magicmaker3/magicmaker/ESP32主控板JOKER SPARROW/Brush fastener tool刷固件工具/ESP32清FLASH教程/ESP双清教程.jpg

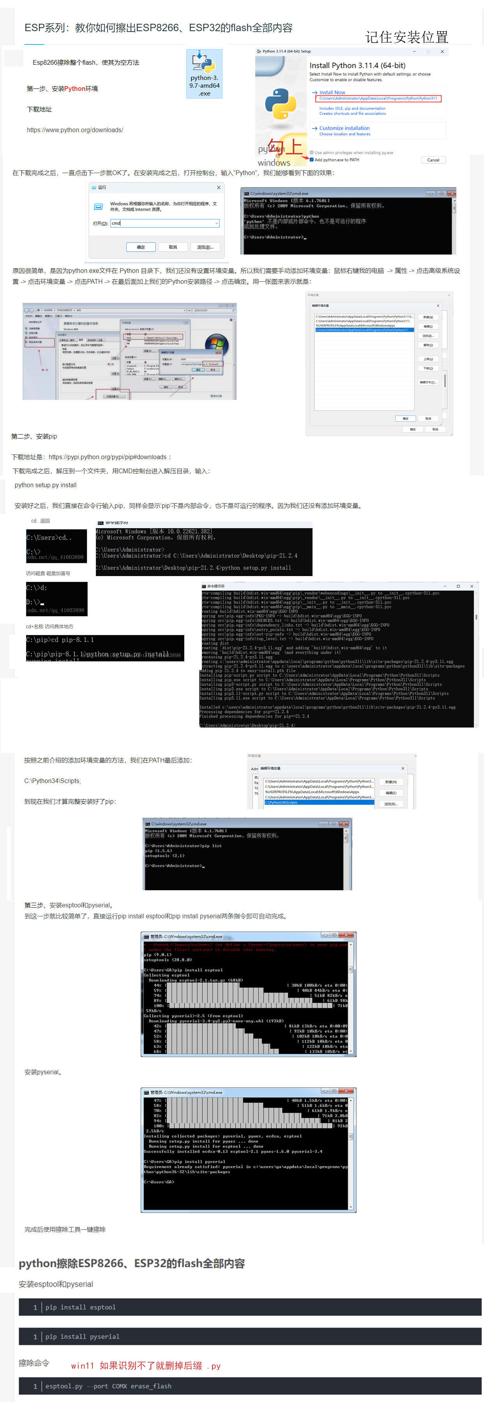
ESP32主控板JOKER SPARROW/Brush fastener tool刷固件工具/ESP32清FLASH教程/ESP双清教程.jpg
