magicmaker3/magicmaker/ESP32主控板JOKER SPARROW/JOKER/JOKER-PIN.JPG

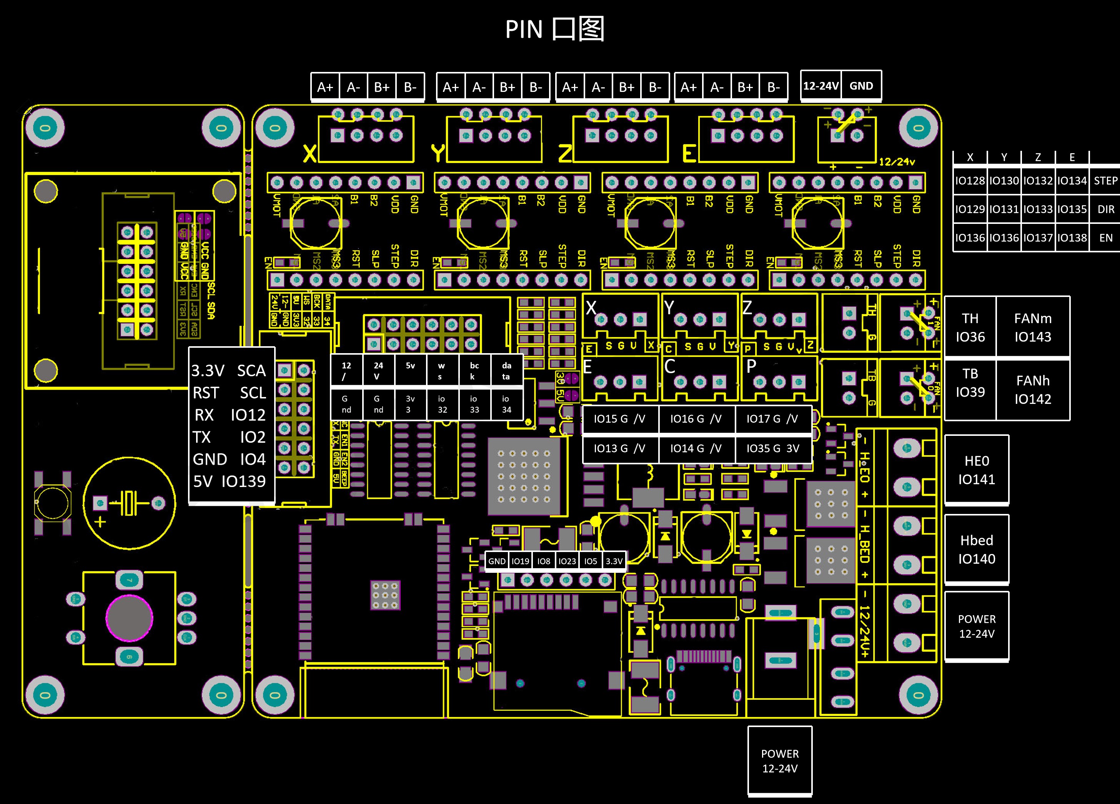
ESP32主控板JOKER SPARROW/JOKER/JOKER-PIN.JPG
