magicmaker3/magicmaker/SLuban/Video link 视频链接1.4.txt

☆官方网站
3dmohe.com 推荐电脑浏览

Installation tutorial安装教程
https://b23.tv/ZMMmphU还是以图文教程为主，视频做参考流程和动作，因为视频不好表现细节

Operation demonstration操作演示
https://b23.tv/kTxgm2I

Slicing software切片软件
https://www.bilibili.com/video/BV17K4y1t77R/.

小鲁班资料百度云链接:
 https://pan.baidu.com/s/1aTfgacmzn0Qr1cNqkTUBUg 提取码: mukb

海外用户：
github.com/magicmaker3/magicmaker
