magicmaker3/magicmaker/ESP32主控板JOKER SPARROW/JOKER连wifi和刷固件教程1.82.pdf

用的ESP32-S模组，双天线

提要：
ESP32的wifi对信号比较挑剔，信号不好系
统会重启，可以尝试多连几次，但也可能中
途重启，建议换手机或电脑尝试。
（如何判断wifi稳不稳定：看连上后重不重启）

之前在测试时针对重启问题折腾了一个月，换各版ESP32，换过 乐鑫原厂的，换各版marlin，换过进口falsh，最后发现同事的苹 果SE连wifi怎么折腾都不会重启，我的努比亚Z20和电脑的 USBwifi连就必重启，后面用华为P40测试也不会重启，电脑换了 PCI的无线网卡，也没再重启，结论就是ESP32对wifi信号质量和
稳定性要求高。

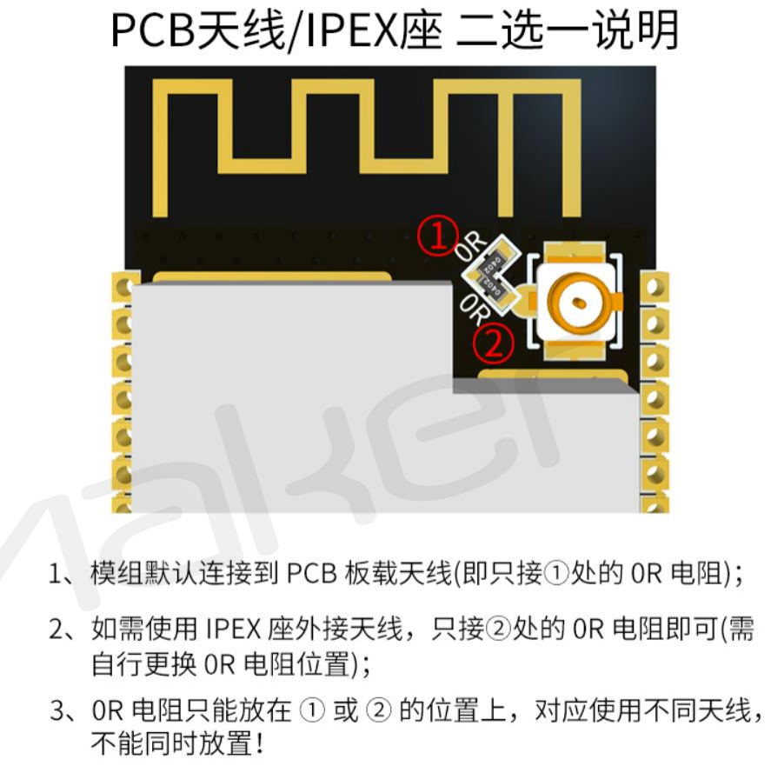
[picture p18: figure]

然而改成客户端模式，基本没有重启过。 如果遇到连wifi重启的，改成客户端模式。 | 一般出厂是默认的板载电阻，
换电阻需要点技术，建议直接用洛铁，
吹风可能直接吹没了
（这是个0R电阻，也可以直接飞线）

## 首先刷好marlin2.0固件，

一般会出厂刷好，没固件的看刷固件教程

## ESP32的初始wifi密码是12345678,不建议更改

# magicmaker

客户端模式会更稳定，
建议改成客户端模式(只支持2.4G）

## 连上后打开浏览器输入IP地址192.168.0.1

## index.html.gz

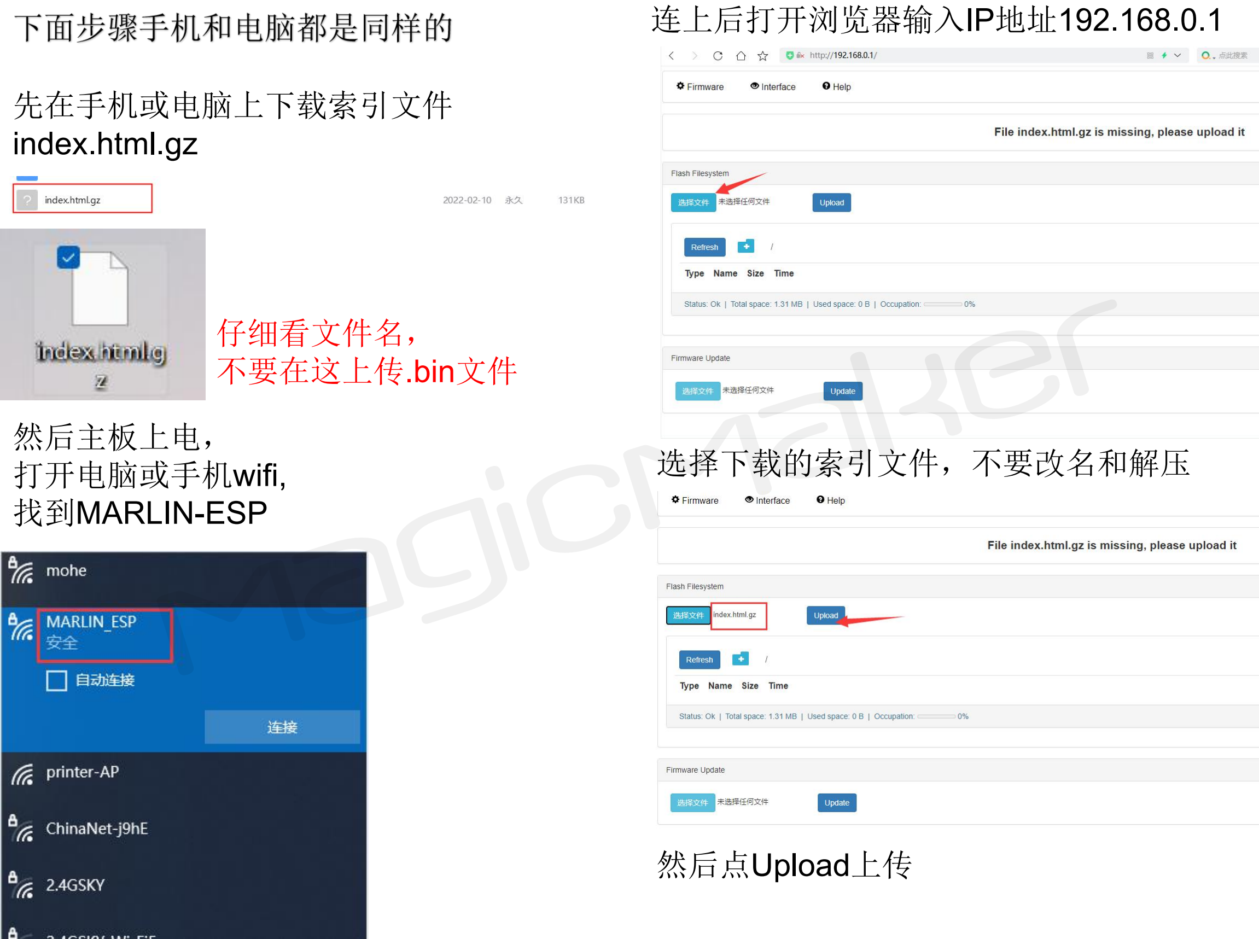
[picture p19: page 2]

然后主板上电，

## 打开电脑或手机wifi, 找到MARLIN-ESP

先在手机或电脑上下载索引文件

选择下载的索引文件，不要改名和解压

## 然后点Upload上传

# magicmaker

仔细看文件名，
不要在这上传.bin文件

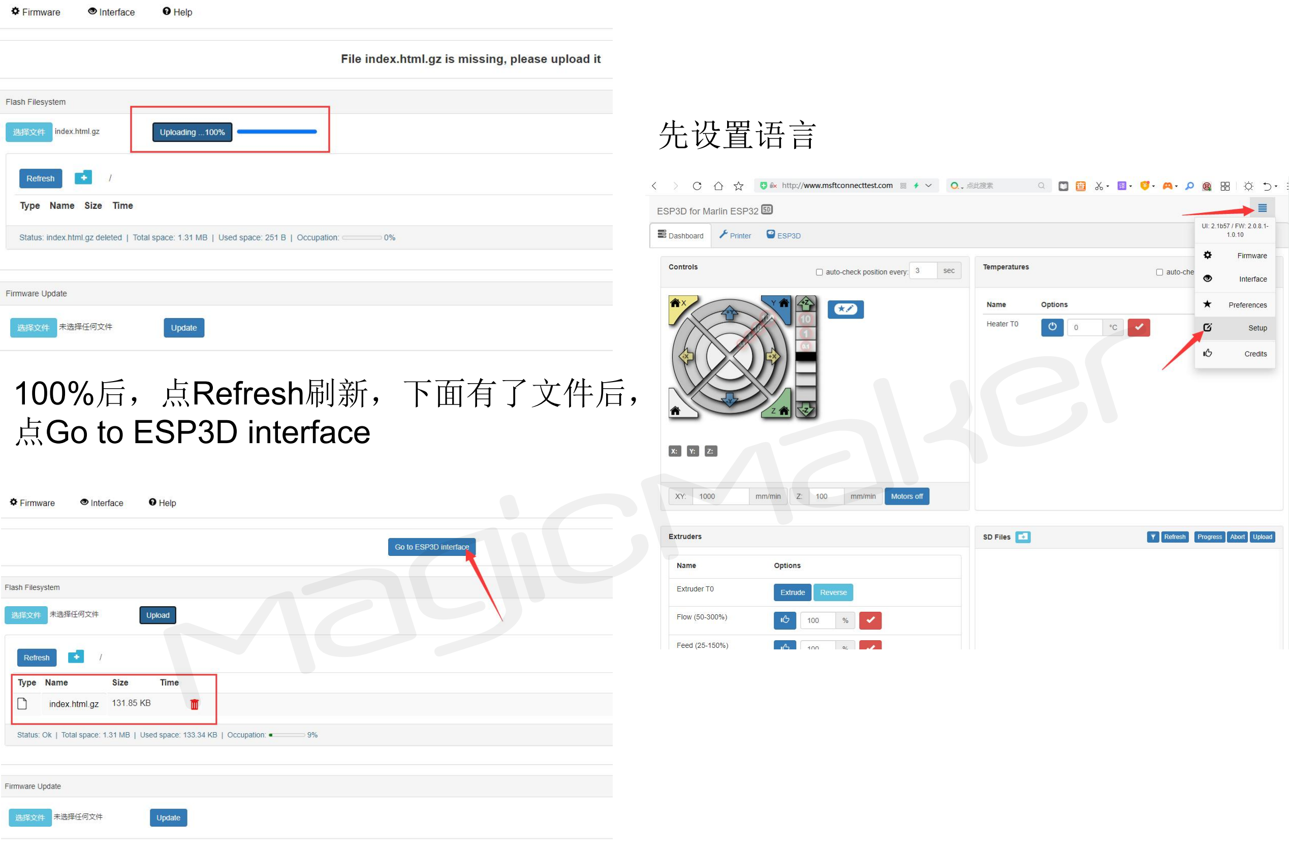
[picture p20: page 3]

100%后，点Refresh刷新，下面有了文件后，

## 点Go to ESP3D interface

先设置语言

# magicmaker

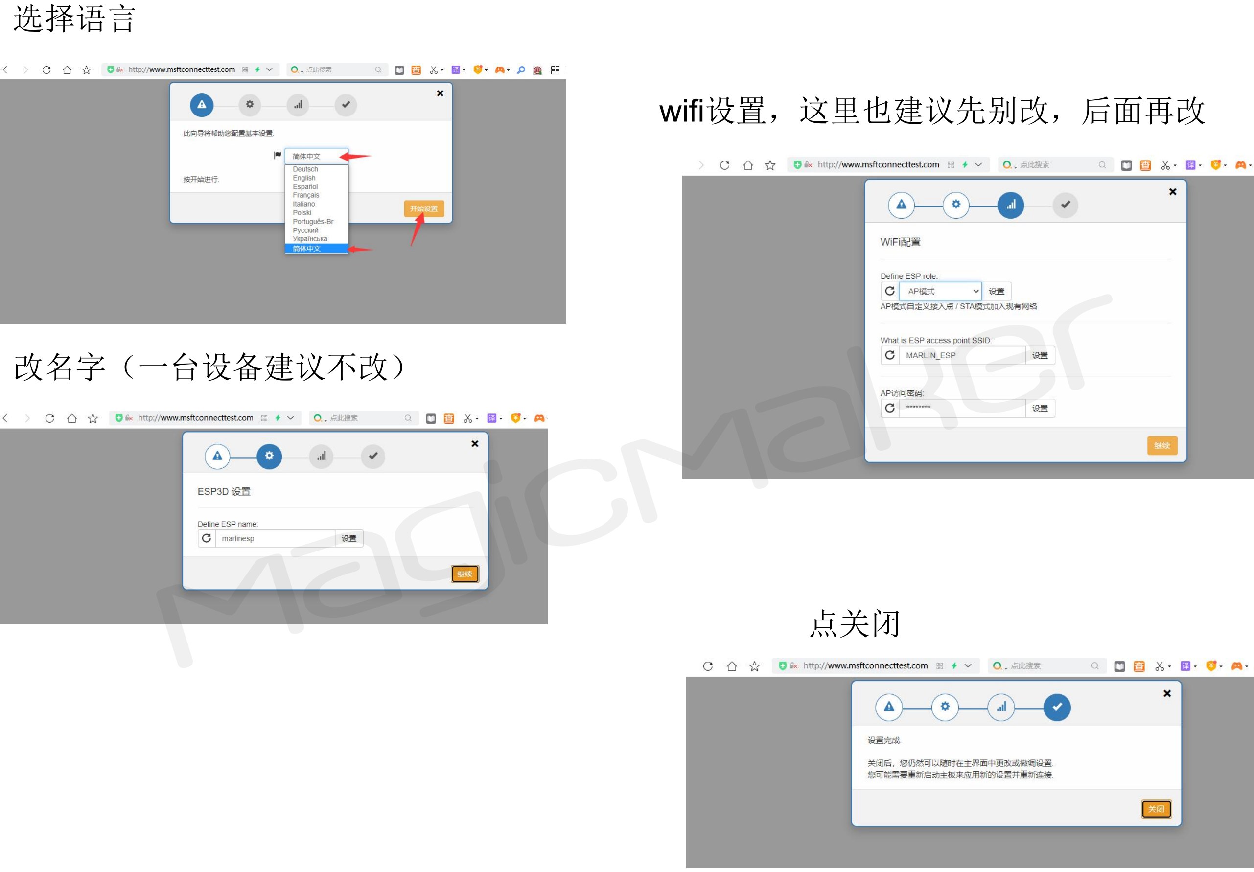
[picture p21: page 4]

改名字（一台设备建议不改）

wifi设置，这里也建议先别改，后面再改

# mag

点关闭

# icmaker

选择语言

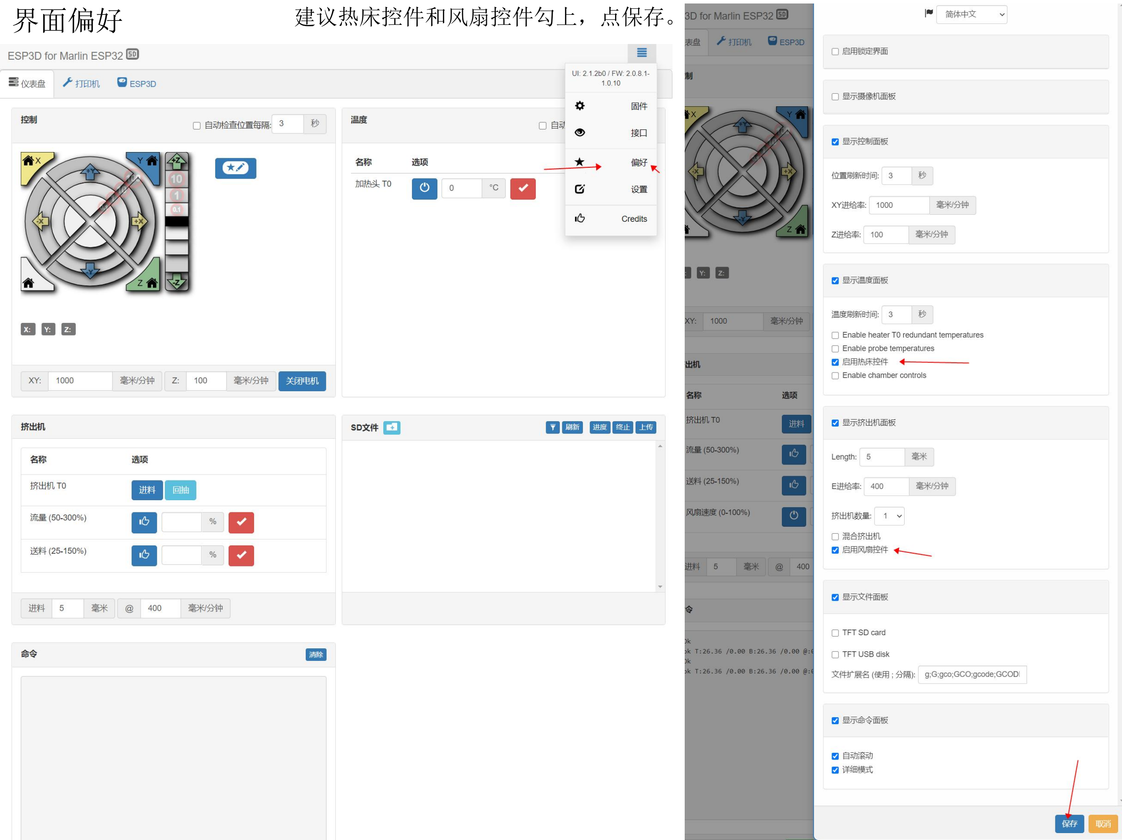
[picture p22: page 5]

界面偏好 | 建议热床控件和风扇控件勾上，点保存。

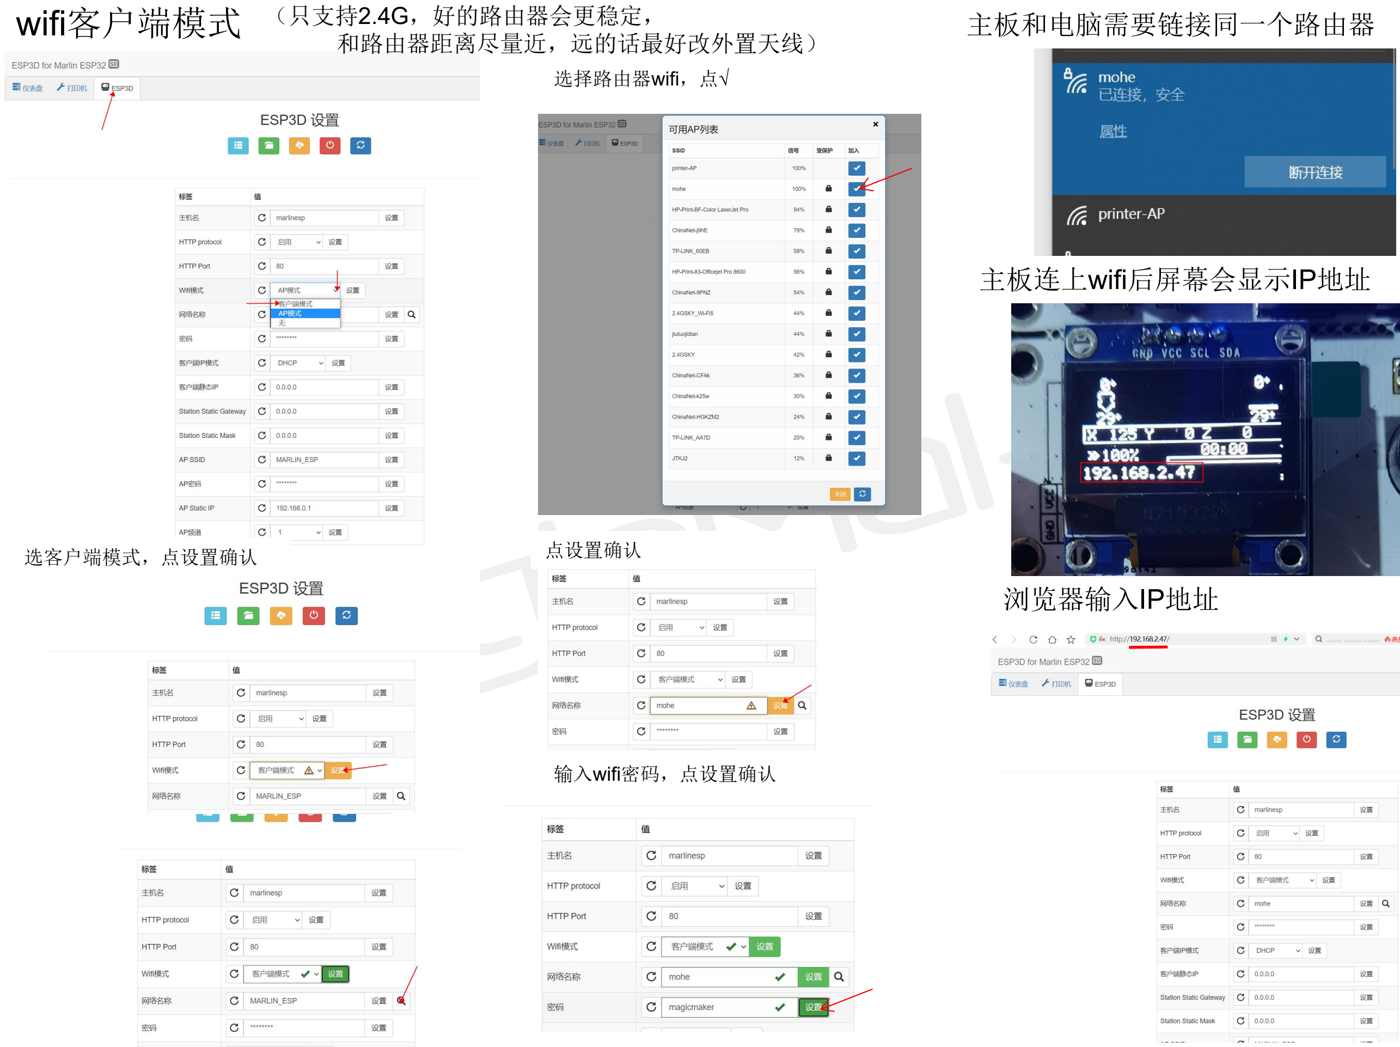
[picture p23: page 6]

wifi客户端模式

# magicmaker

主板和电脑需要链接同一个路由器

主板连上wifi后屏幕会显示IP地址

浏览器输入IP地址

输入wifi密码，点设置确认

选客户端模式，点设置确认

选择路由器wifi，点√

点设置确认

（只支持2.4G，好的路由器会更稳定，
和路由器距离尽量近，远的话最好改外置天线）

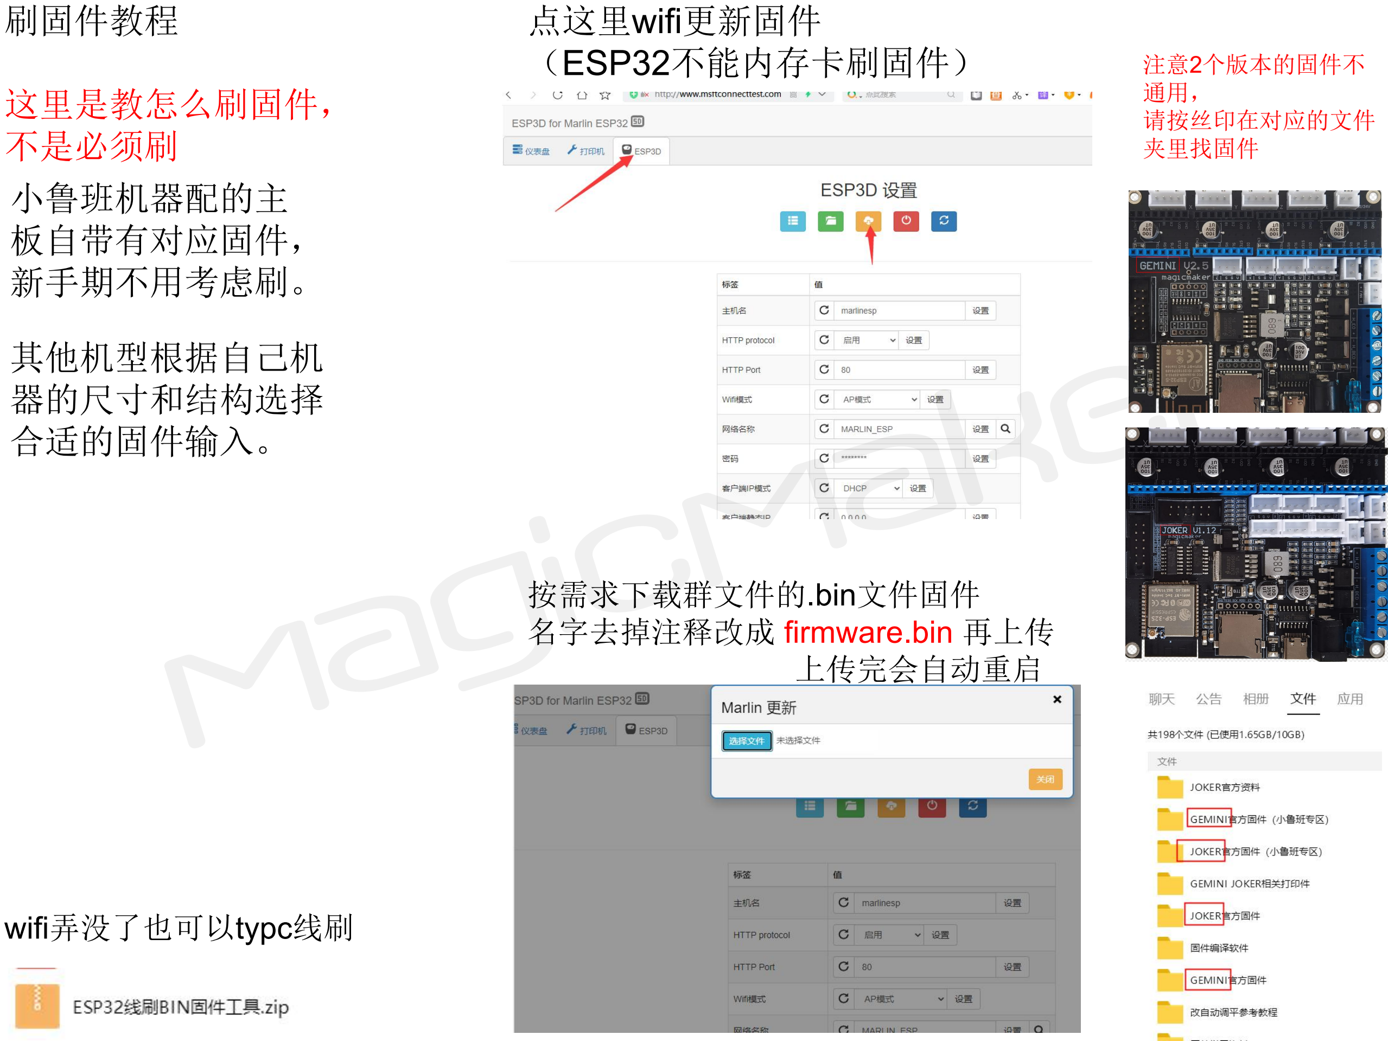
[picture p24: page 7]

点这里wifi更新固件
（ESP32不能内存卡刷固件）

按需求下载群文件的.bin文件固件

### 名字去掉注释改成 firmware.bin 再上传

上传完会自动重启 magicmaker

注意2个版本的固件不
通用，
请按丝印在对应的文件
夹里找固件

刷固件教程

小鲁班机器配的主
板自带有对应固件，
新手期不用考虑刷。

这里是教怎么刷固件，
不是必须刷

其他机型根据自己机
器的尺寸和结构选择
合适的固件输入。

### wifi弄没了也可以typc线刷

## JOKER主板在JOKER的文件夹里找，

## 文件名只能为firmware.bin

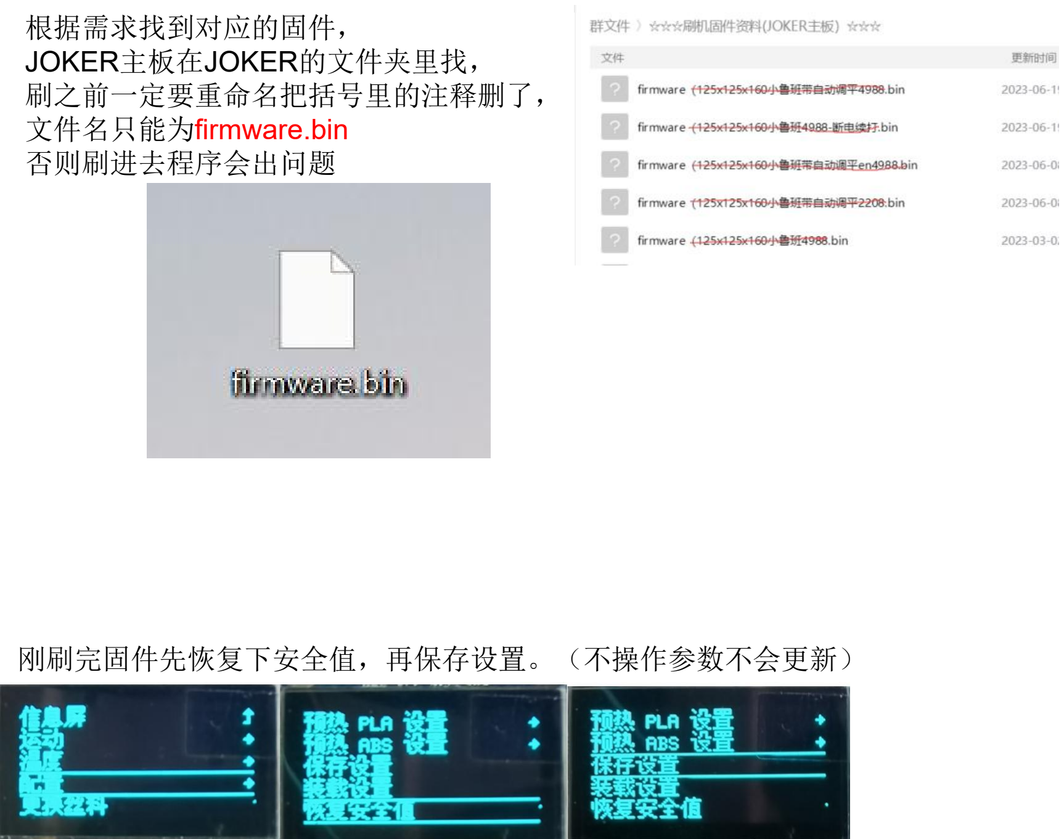
[picture p25: page 8]

根据需求找到对应的固件，

刷之前一定要重命名把括号里的注释删了，

否则刷进去程序会出问题

刚刷完固件先恢复下安全值，再保存设置。（不操作参数不会更新）

## 电机反转

刷完固件可能遇到电机反的情况，
wifi和屏幕上不能改屏幕方向。
需要重新改固件，
不会编译固件的可以直接改电机线序

根据机型和机器尺寸选择固件模板
没一样的尺寸可以选大一号的尺寸，
向下兼容，尺寸限制在切片软件上设置


把电机线的一端端子用尖锐的东西挑出来，线序互换一下，就是换方向了，

## 比如1234可以换成4321


例如，如果要换电机方向，
把 红蓝绿黑 换成 黑绿蓝红

刷完固件可能出现这个界面，需要旋钮拧到右边，点确认

模板固件的限位都是在XYZ的MIN，
坐标0点，喷头在平台左前方停

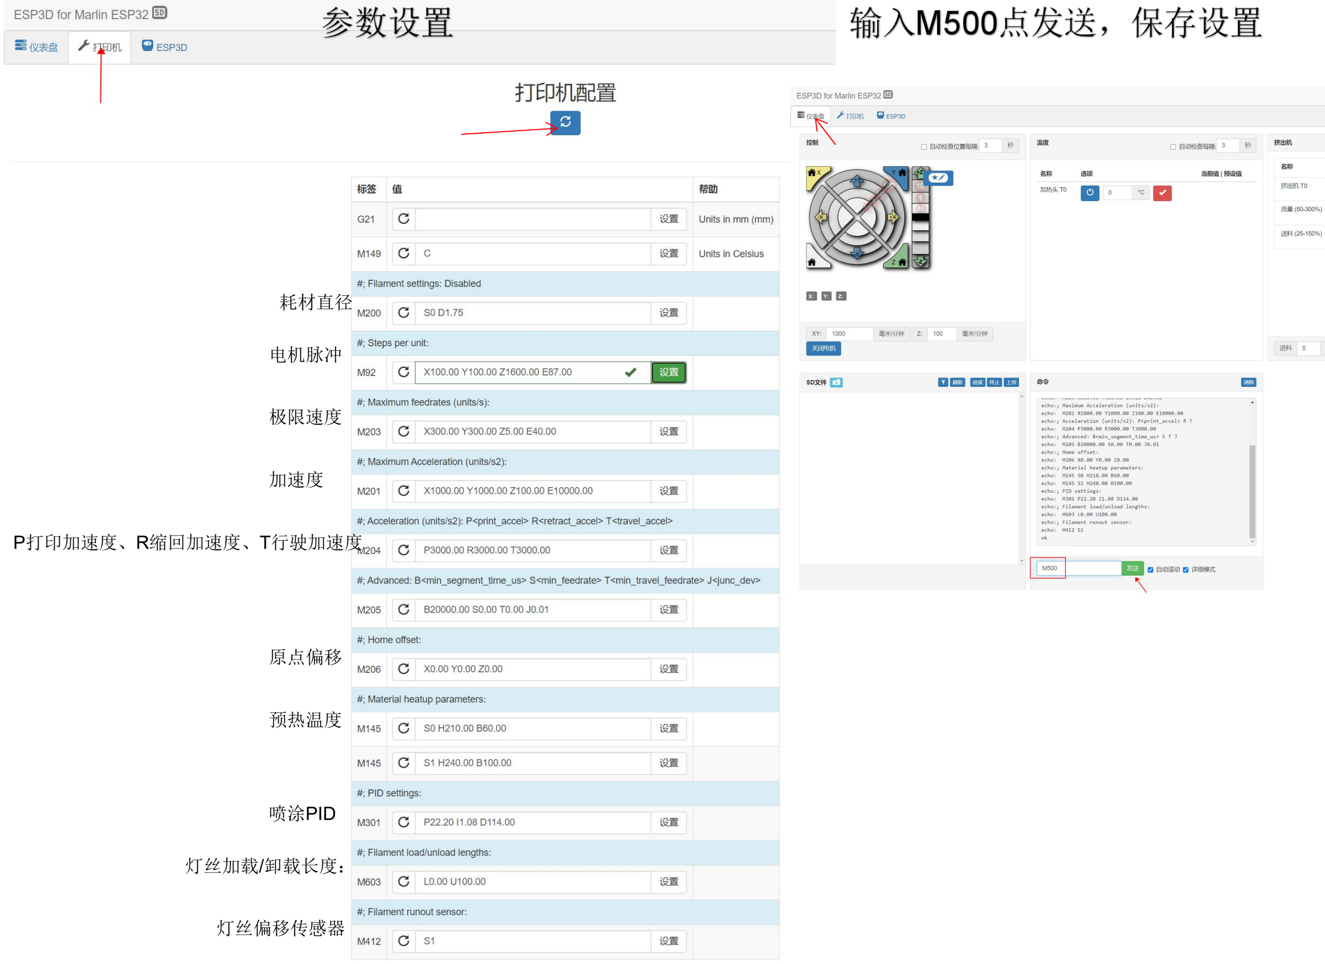
[picture p26: page 10]

电机脉冲

极限速度

加速度

预热温度

喷涂PID

原点偏移

灯丝加载/卸载长度：

灯丝偏移传感器

P打印加速度、R缩回加速度、T行驶加速度

耗材直径
