magicmaker3/magicmaker/SLuban/refit data 改装资料/Automatic leveling自动调平/小鲁班改自动调平教程2.2.pdf

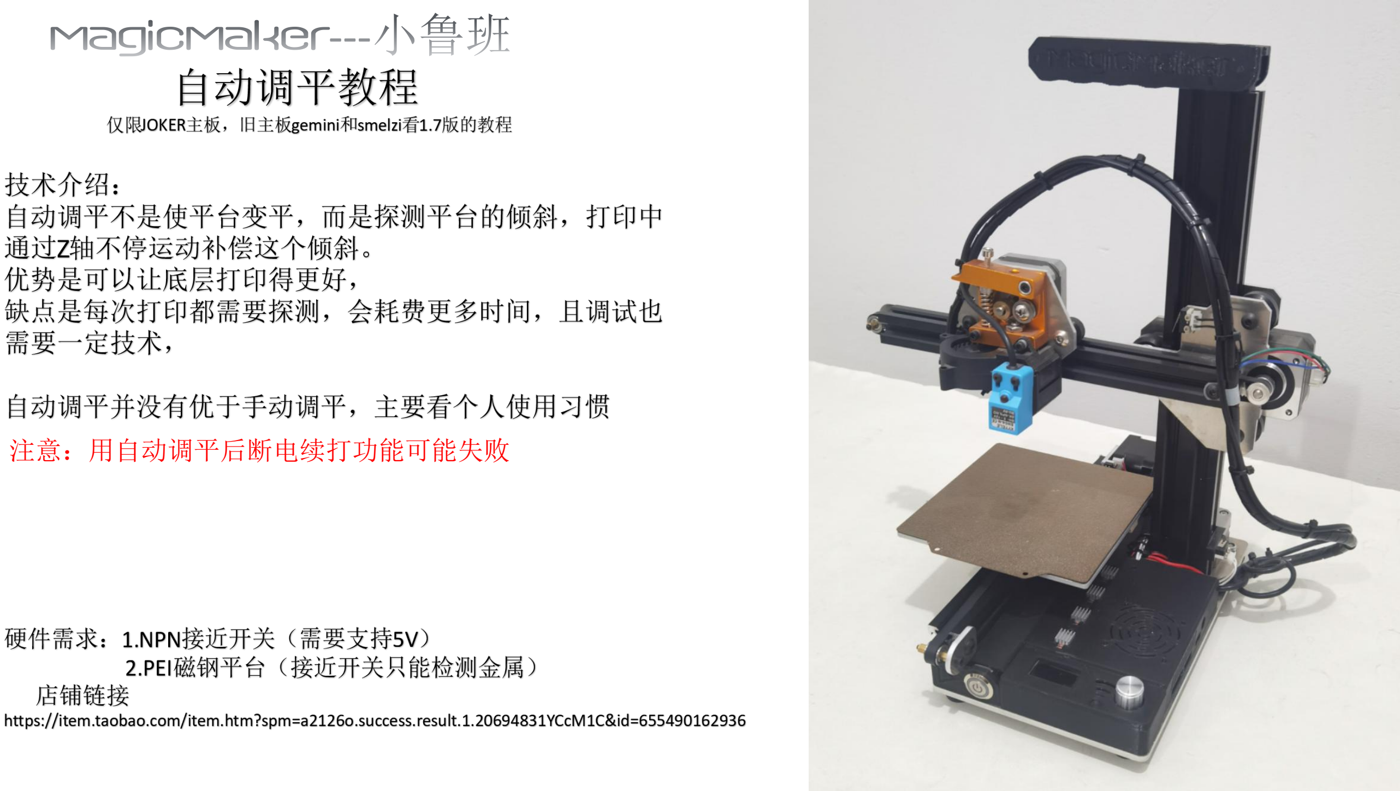
[picture p27: page 1]

注意：用自动调平后断电续打功能可能失败

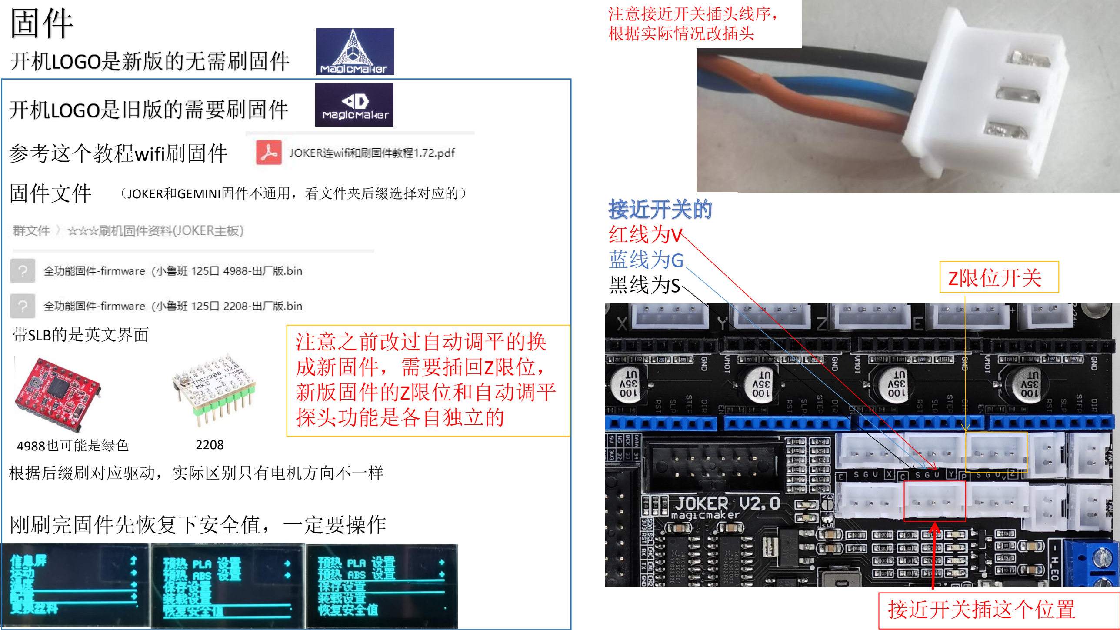
[picture p28: page 2]

接近开关插这个位置

参考这个教程wifi刷固件

固件文件

根据后缀刷对应驱动，实际区别只有电机方向不一样

刚刷完固件先恢复下安全值，一定要操作

（JOKER和GEMINI固件不通用，看文件夹后缀选择对应的）

4988也可能是绿色 | 2208

注意接近开关插头线序，
根据实际情况改插头

红线为V
蓝线为G
黑线为S
带SLB的是英文界面 | 注意之前改过自动调平的换 成新固件，需要插回Z限位， 新版固件的Z限位和自动调平 探头功能是各自独立的

Z限位开关

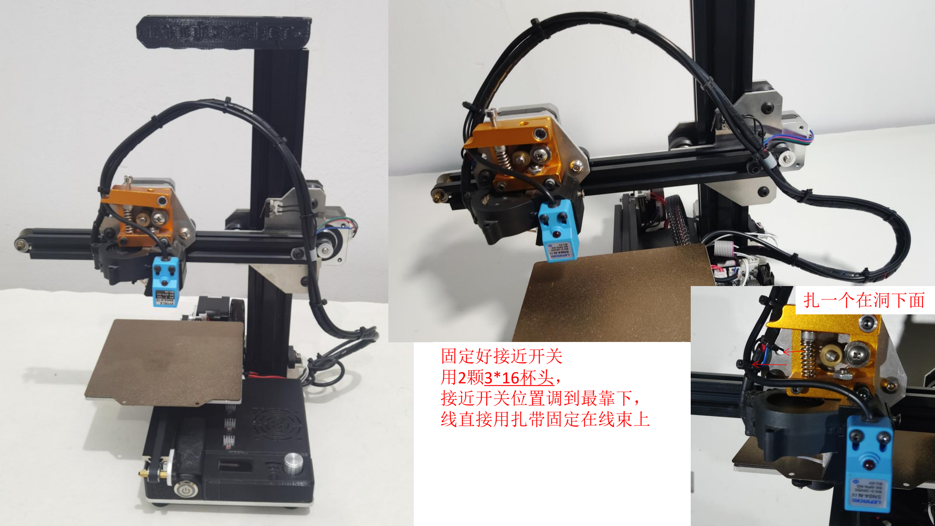
[picture p29: page 3]

固定好接近开关
用2颗3*16杯头，
接近开关位置调到最靠下，
线直接用扎带固定在线束上

扎一个在洞下面

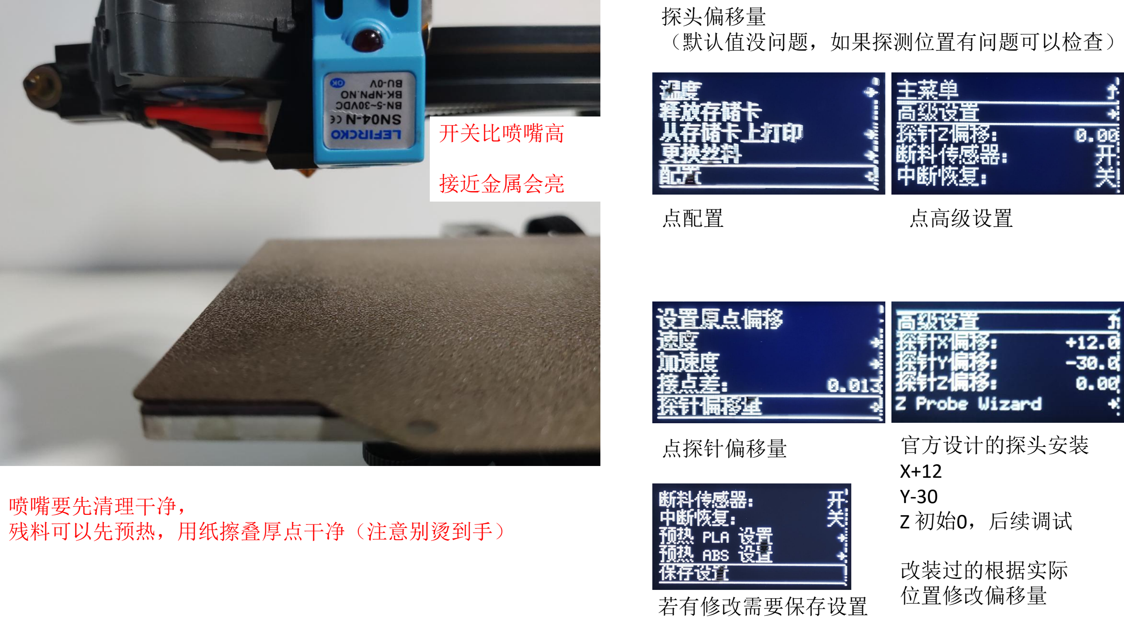
[picture p30: page 4]

开关比喷嘴高

接近金属会亮

喷嘴要先清理干净，
残料可以先预热，用纸擦叠厚点干净（注意别烫到手）

探头偏移量
（默认值没问题，如果探测位置有问题可以检查）
点配置 | 点高级设置
点探针偏移量 | 官方设计的探头安装
X+12
Y-30
| Z 初始0，后续调试
| 改装过的根据实际
位置修改偏移量 若有修改需要保存设置

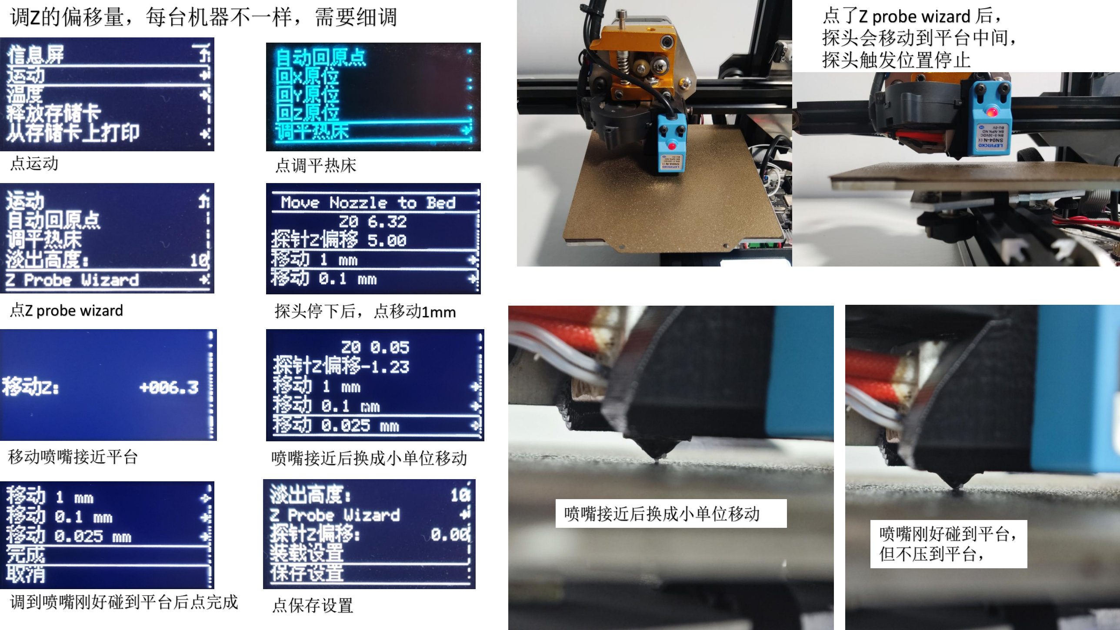
[picture p31: page 5]
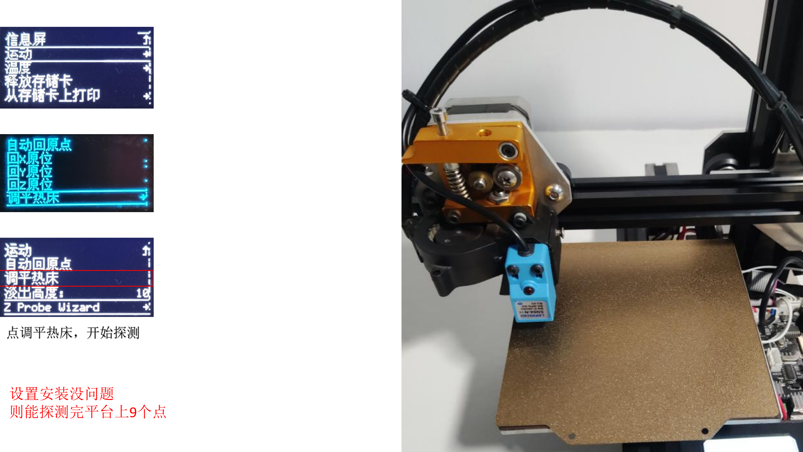
[picture p32: page 6]

设置安装没问题
则能探测完平台上9个点

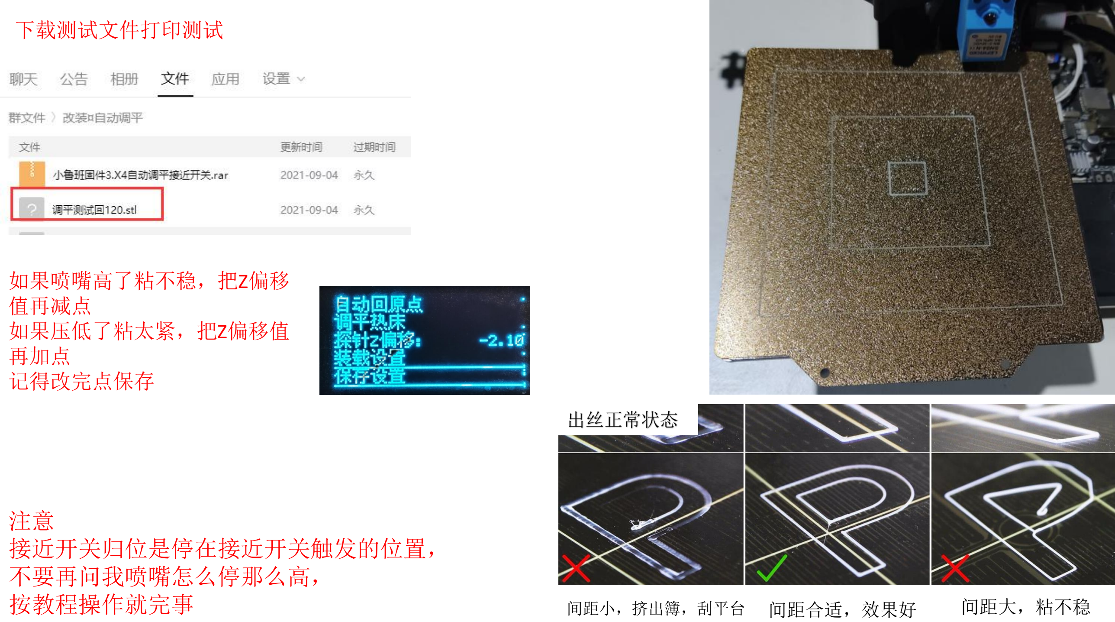
[picture p33: page 7]

如果喷嘴高了粘不稳，把Z偏移
值再减点
如果压低了粘太紧，把Z偏移值
再加点
记得改完点保存

下载测试文件打印测试

间距小，挤出簿，刮平台 | 间距合适，效果好 | 间距大，粘不稳

注意
接近开关归位是停在接近开关触发的位置，
不要再问我喷嘴怎么停那么高，
按教程操作就完事

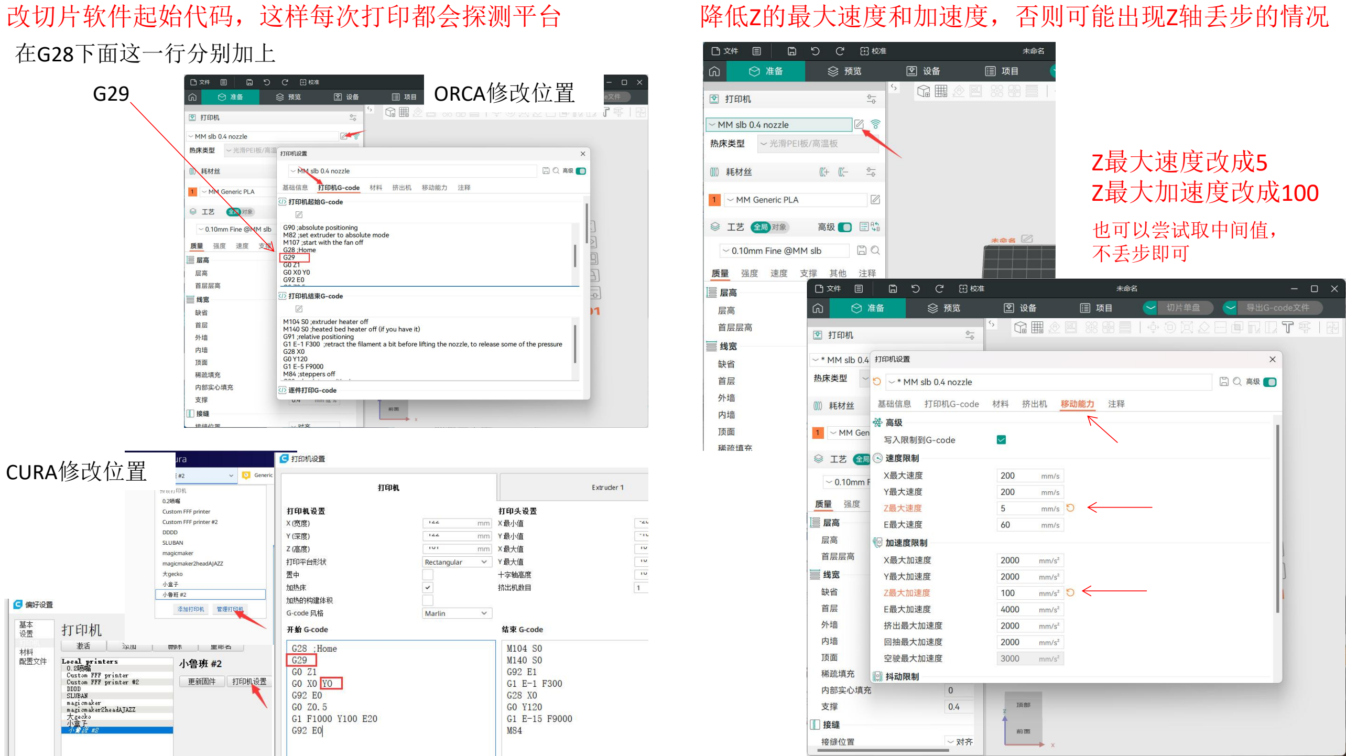
[picture p34: page 8]

在G28下面这一行分别加上

改切片软件起始代码，这样每次打印都会探测平台

### CURA修改位置

G29 | ORCA修改位置

也可以尝试取中间值，
不丢步即可

Z最大速度改成5
Z最大加速度改成100

降低Z的最大速度和加速度，否则可能出现Z轴丢步的情况
