magicmaker3/magicmaker/ESP32主控板JOKER SPARROW/JOKER/小鲁班X升级JOKER教程/小鲁班改JOKER主板教程1.3.pdf

没驱动的建议买带驱动的套装，建议4988 或2208

主板默认是4988的固件，其他驱动或带自动调平需
要自己刷固件，详细看后面

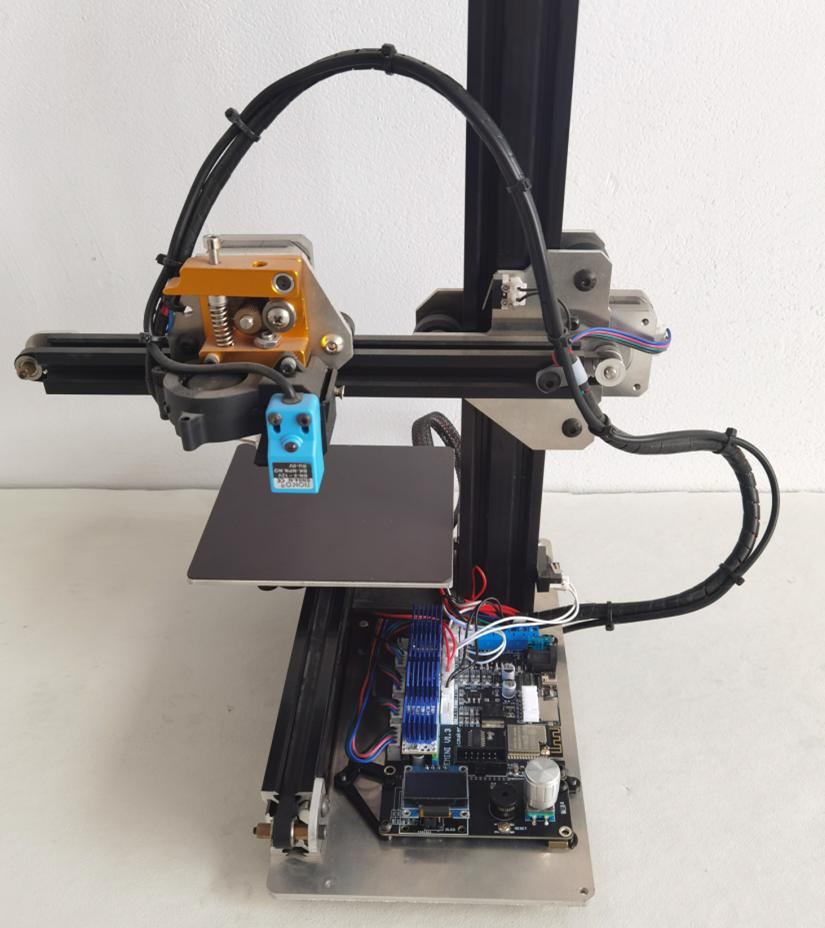
[picture p35: figure]
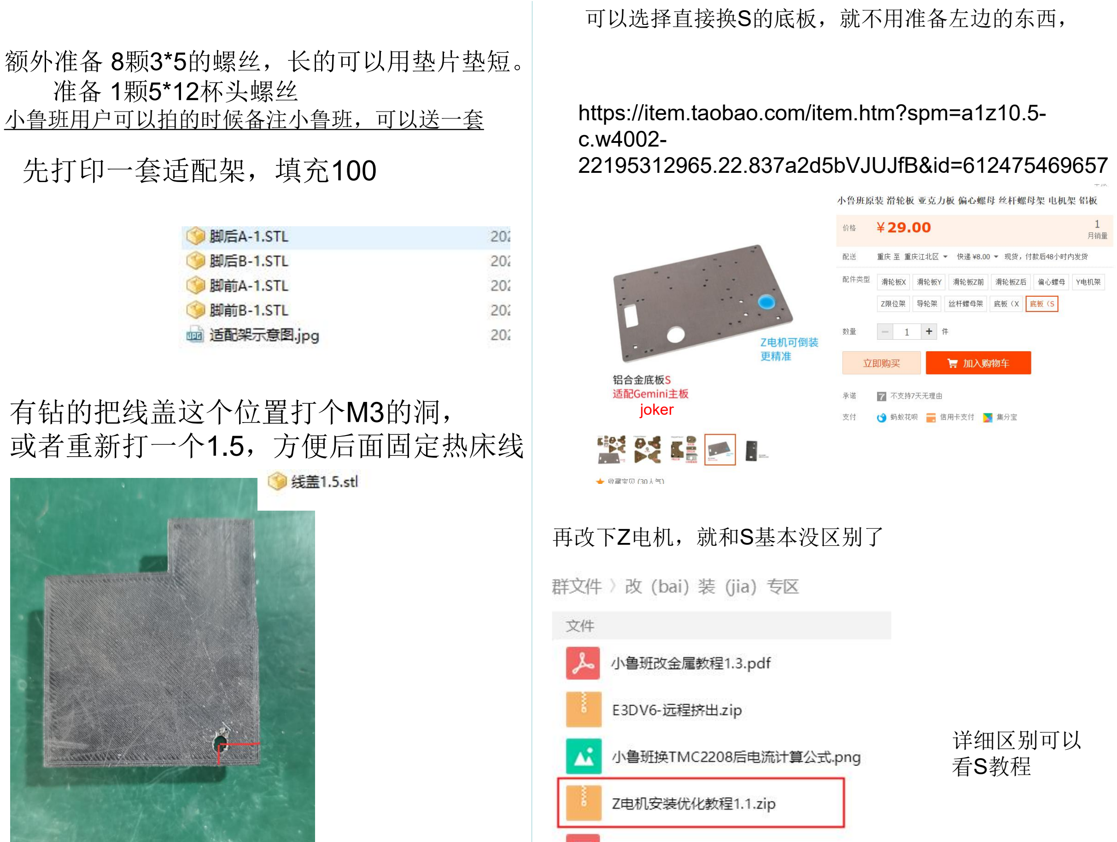
[picture p36: page 2]

先打印一套适配架，填充100

额外准备 8颗3*5的螺丝，长的可以用垫片垫短。
准备 1颗5*12杯头螺丝
小鲁班用户可以拍的时候备注小鲁班，可以送一套

有钻的把线盖这个位置打个M3的洞，
或者重新打一个1.5，方便后面固定热床线

https://item.taobao.com/item.htm?spm=a1z10.5- c.w4002- 22195312965.22.837a2d5bVJUJfB&id=612475469657

可以选择直接换S的底板，就不用准备左边的东西，

joker

再改下Z电机，就和S基本没区别了

详细区别可以
看S教程

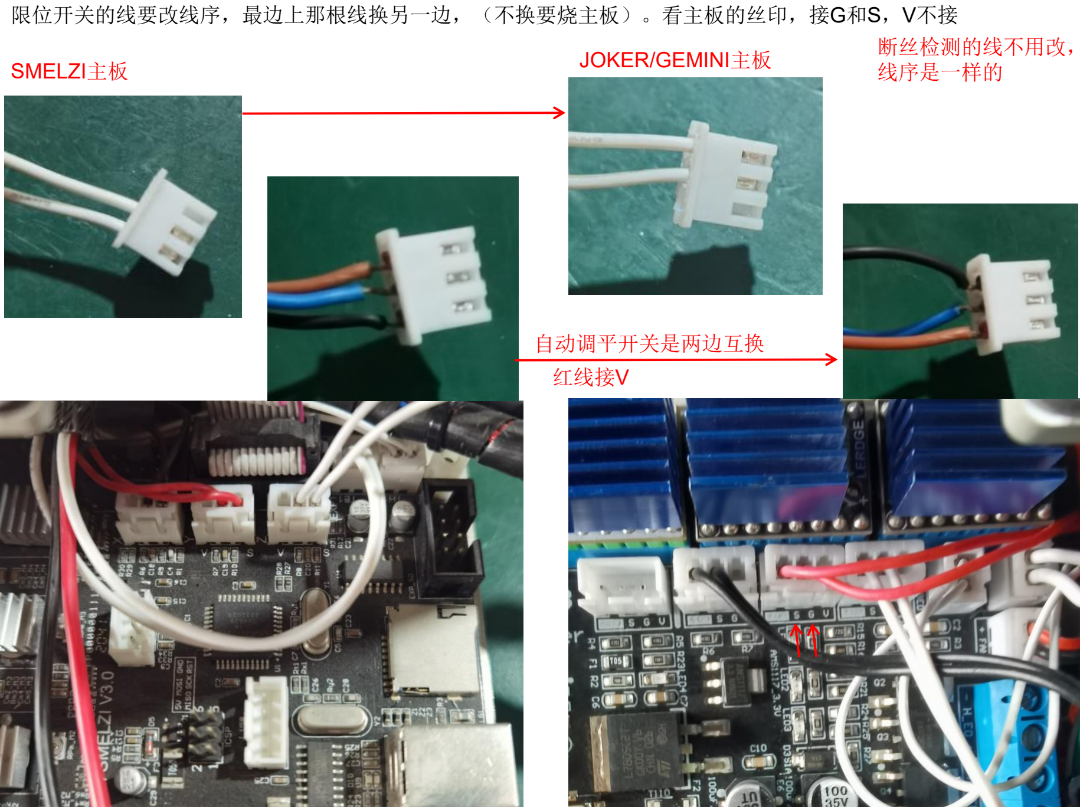
[picture p37: page 3]

限位开关的线要改线序，最边上那根线换另一边，（不换要烧主板）。看主板的丝印，接G和S，V不接

SMELZI主板

JOKER/GEMINI主板

自动调平开关是两边互换
红线接V

断丝检测的线不用改，
线序是一样的

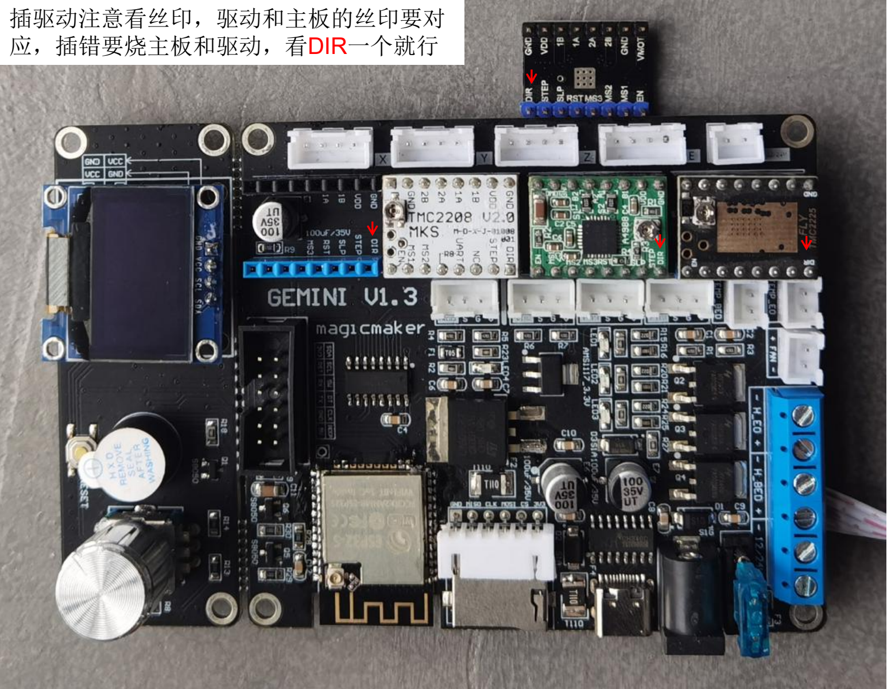
[picture p38: page 4]

插驱动注意看丝印，驱动和主板的丝印要对
应，插错要烧主板和驱动，看DIR一个就行

# JOKER接线图

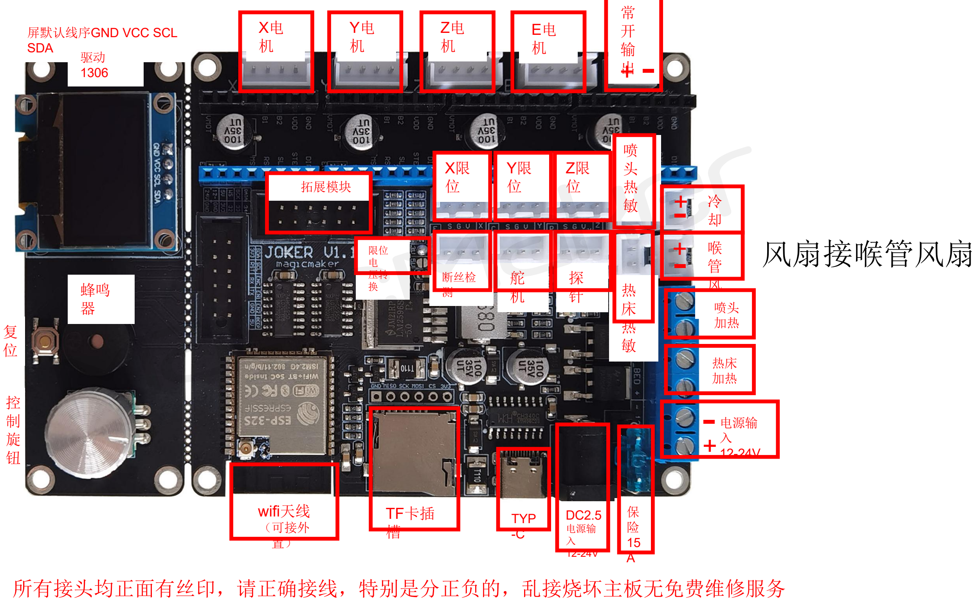
[picture p39: figure]
wifi天线; （可接外 置）; 断丝检 测; TF卡插 槽; TYP -C; 电源输 入; 电源输; 所有接头均正面有丝印，请正确接线，特别是分正负的，乱接烧坏主板无免费维修服务; 屏默认线序GND VCC SCL; SDA; 拓展模块; magicmaker; 风扇接喉管风扇

- +

# GEMINI接线图

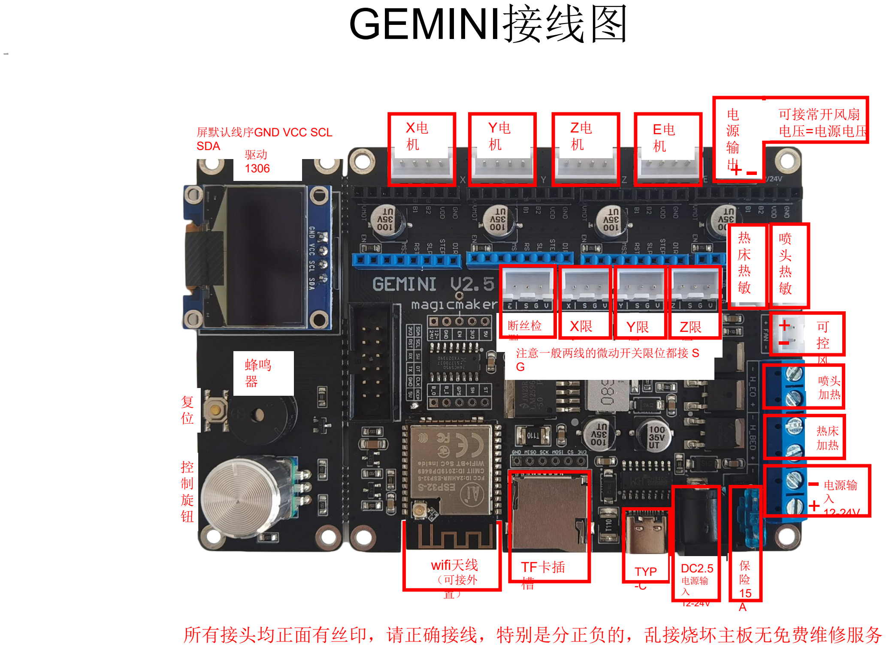
[picture p40: page 6]

wifi天线
（可接外
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
可接常开风扇
X电 | 电压=电源电压
机

Y电
机

Z电
机

E电
机

TF卡插
槽

TYP
-C

DC2.5
电源输
入

12-24V 保 险
15
A

电源输

入 +12-24V -

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
注意一般两线的微动开关限位都接 S
G

所有接头均正面有丝印，请正确接线，特别是分正负的，乱接烧坏主板无免费维修服务

+

屏默认线序GND VCC SCL
SDA | 驱动
| 1306

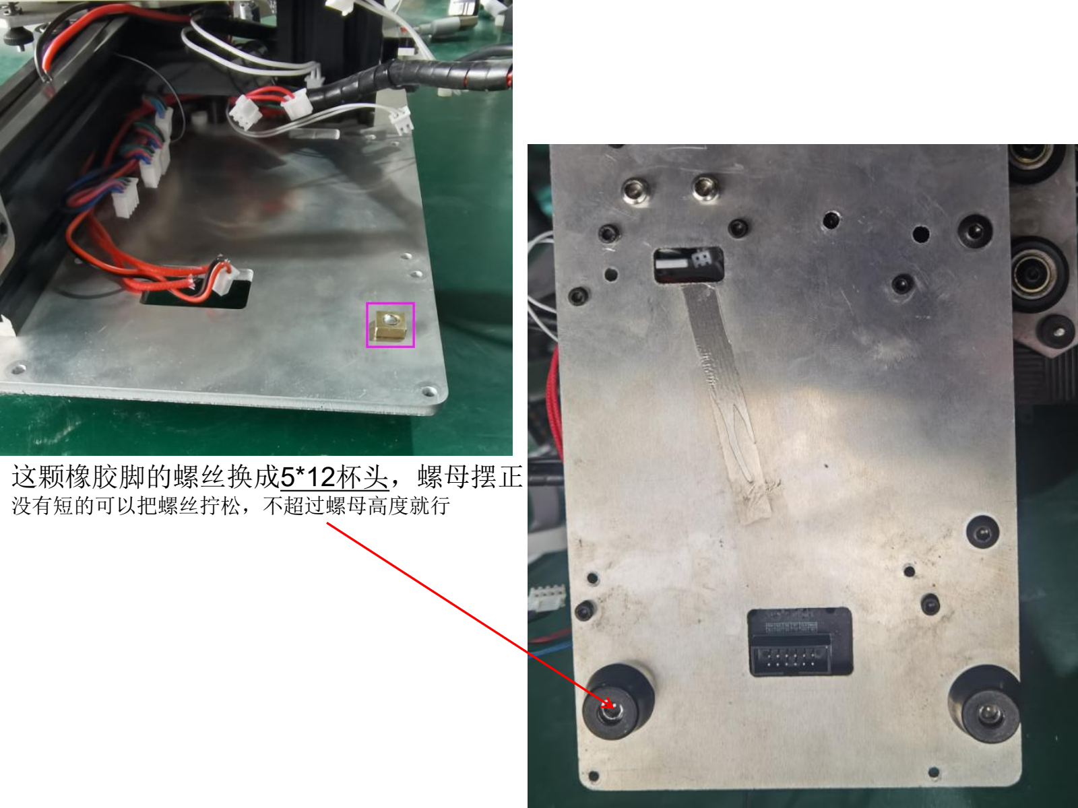
[picture p41: page 7]

这颗橡胶脚的螺丝换成5*12杯头，螺母摆正
没有短的可以把螺丝拧松，不超过螺母高度就行

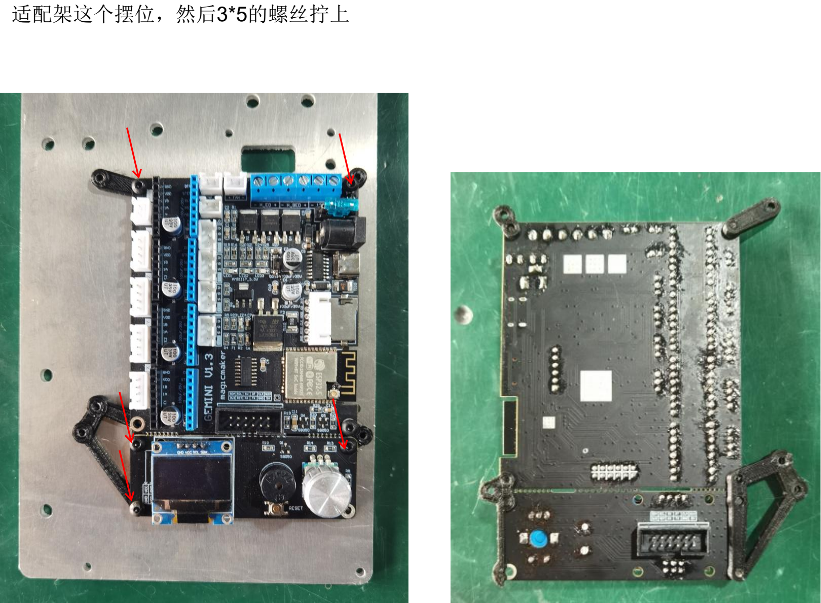
[picture p42: page 8]

适配架这个摆位，然后3*5的螺丝拧上

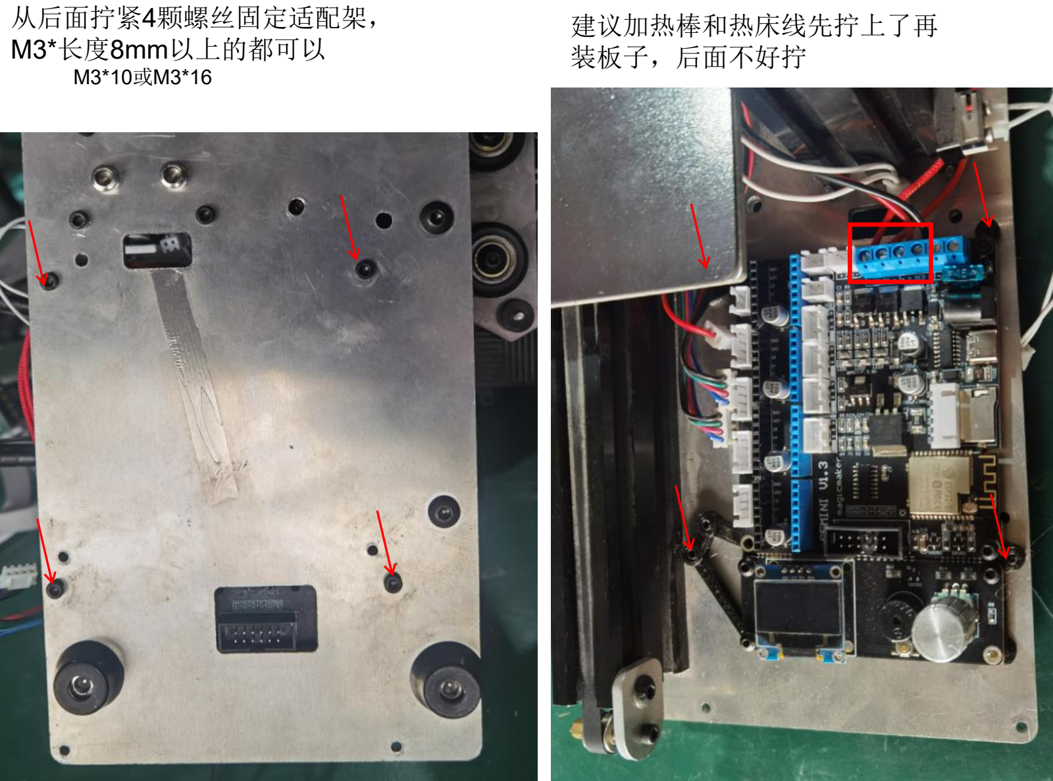
[picture p43: page 9]

从后面拧紧4颗螺丝固定适配架， M3*长度8mm以上的都可以 M3*10或M3*16 | 建议加热棒和热床线先拧上了再 装板子，后面不好拧

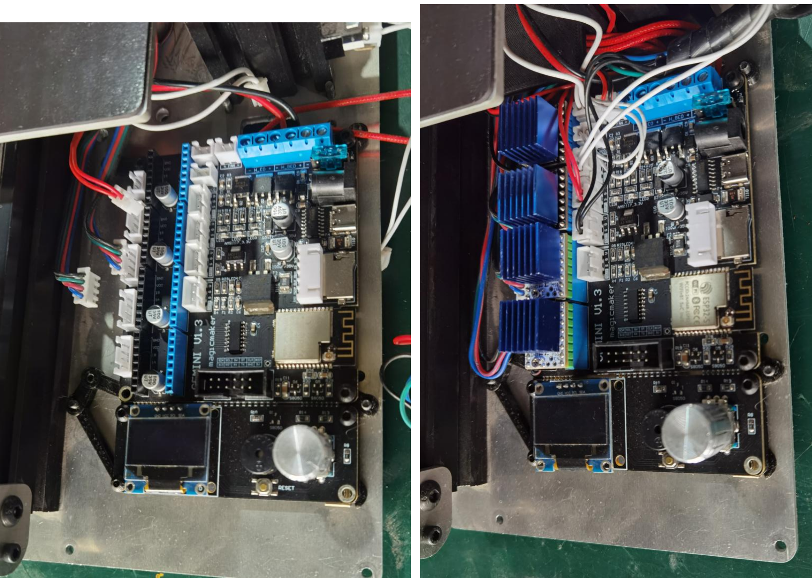
[picture p44: page 10]
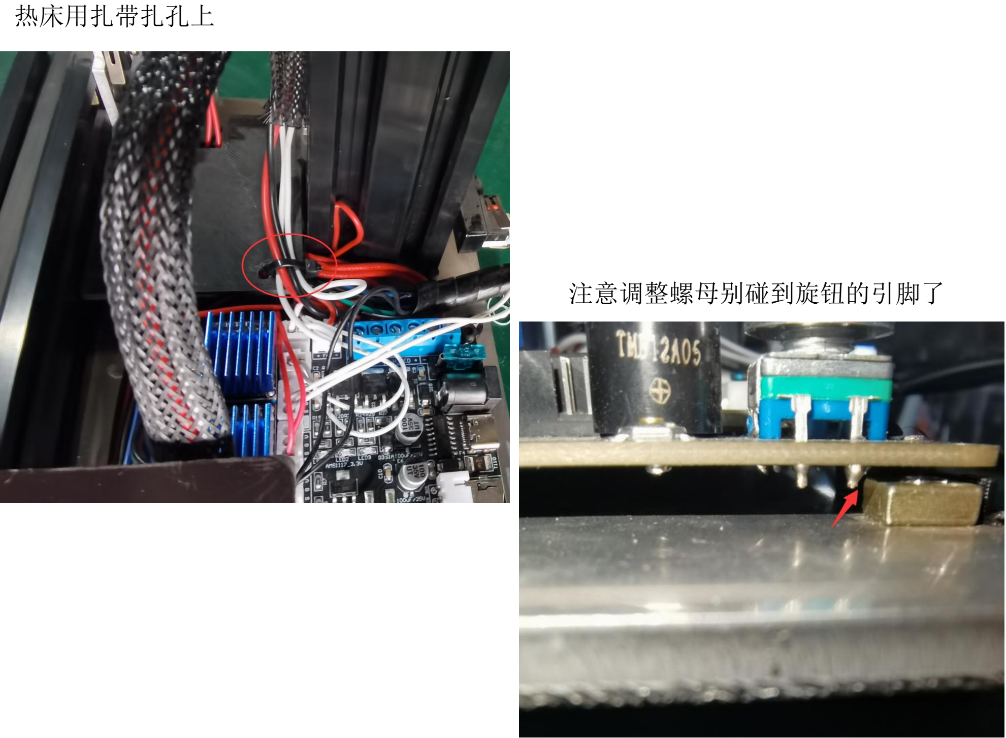
[picture p45: page 11]

热床用扎带扎孔上

注意调整螺母别碰到旋钮的引脚了

把电机线的端子一端，把边上两根线线序互换，就会改变换方向，

## 比如1234可以换成2134或1243，或者全换-换成4321

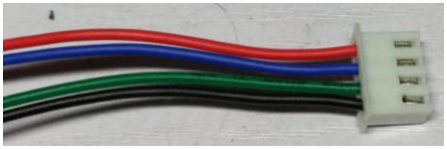
[picture p46: figure]

例如，如果要换电机方向，打红蓝线互
换位置，或者绿黑互换位置

1.改固件，但2.0编译比较麻烦，需要有一定经验才能搞定

2.改线序，如下

有万用表的看驱动链接里的教程跟着调（小鲁班电机合适电流0.5-0.6A） 没万用表的可以盲调，拧一小段就打印一会测试下（直到电机不烫也不丢步

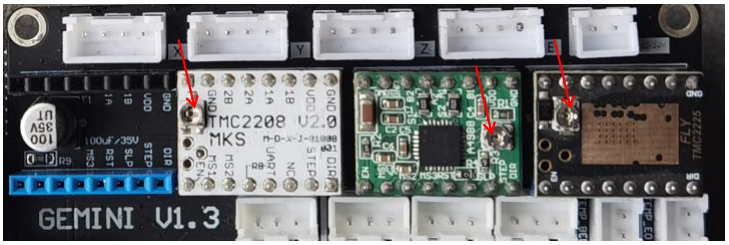
[picture p47: figure]

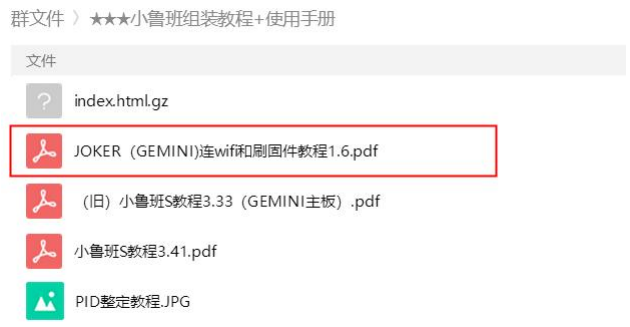
[picture p48: figure]
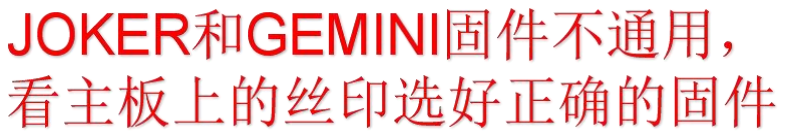
[picture p49: figure]
