magicmaker3/magicmaker/SLuban/refit data 改装资料/Automatic leveling自动调平/小鲁班改自动调平教程1.7（非JOKER旧主板.pdf

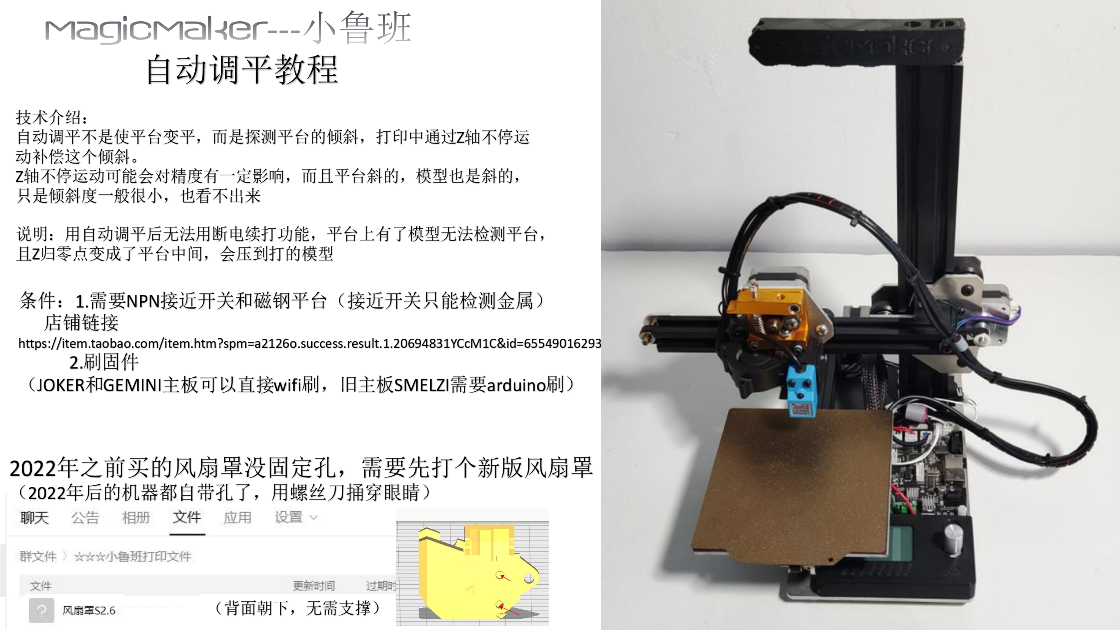
[picture p50: page 1]
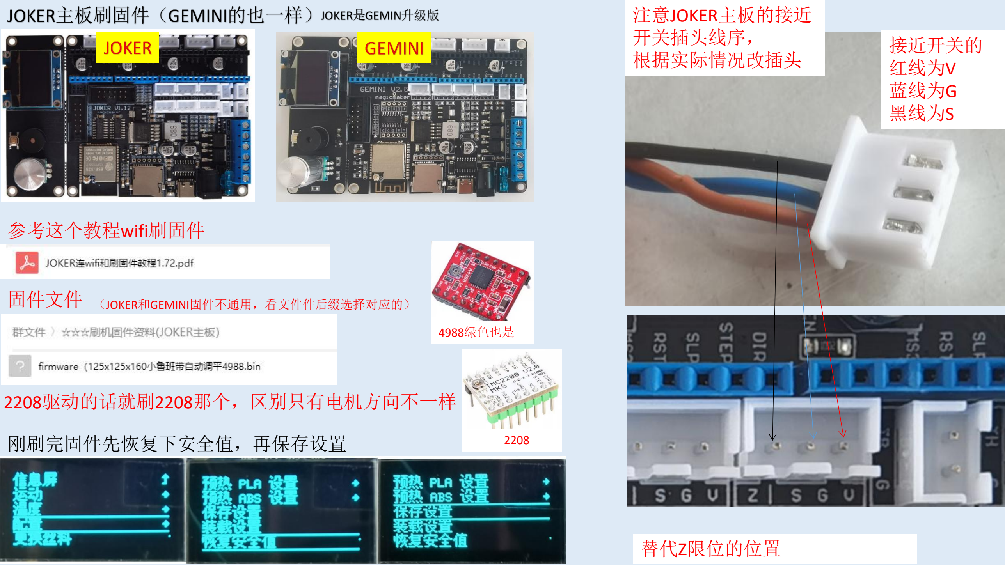
[picture p51: page 2]

参考这个教程wifi刷固件

固件文件

2208驱动的话就刷2208那个，区别只有电机方向不一样

注意JOKER主板的接近
开关插头线序，
根据实际情况改插头

接近开关的
红线为V
蓝线为G
黑线为S

刚刷完固件先恢复下安全值，再保存设置

（JOKER和GEMINI固件不通用，看文件件后缀选择对应的）

替代Z限位的位置

4988绿色也是

2208

## 注意SMELZI和JOKER两

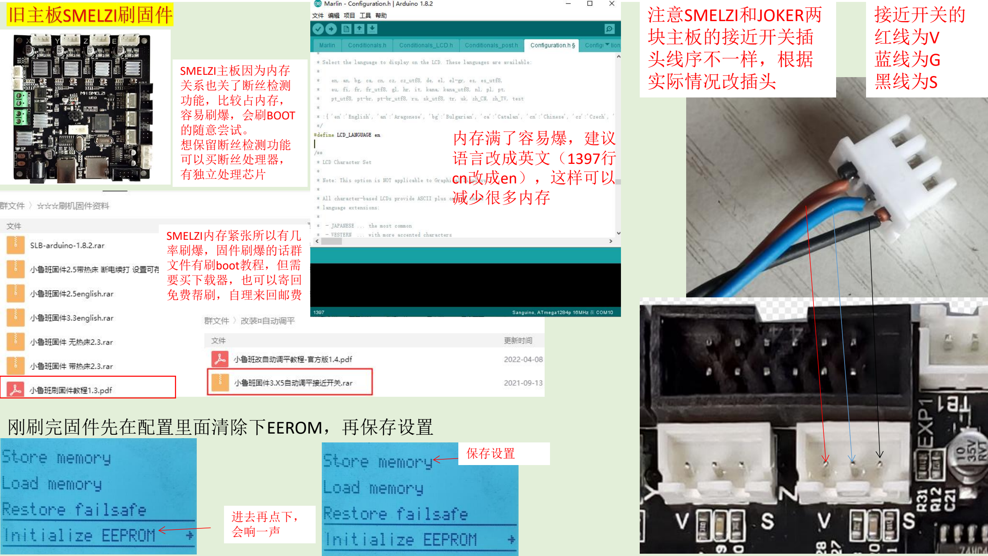
[picture p52: page 3]

SMELZI内存紧张所以有几
率刷爆，固件刷爆的话群
文件有刷boot教程，但需
要买下载器，也可以寄回
免费帮刷，自理来回邮费

内存满了容易爆，建议
语言改成英文（1397行
cn改成en），这样可以
减少很多内存

块主板的接近开关插
头线序不一样，根据
实际情况改插头

接近开关的
红线为V
蓝线为G
黑线为S

刚刷完固件先在配置里面清除下EEROM，再保存设置

进去再点下，
会响一声

保存设置

SMELZI主板因为内存
关系也关了断丝检测
功能，比较占内存，
容易刷爆，会刷BOOT
的随意尝试。
想保留断丝检测功能
可以买断丝处理器，
有独立处理芯片

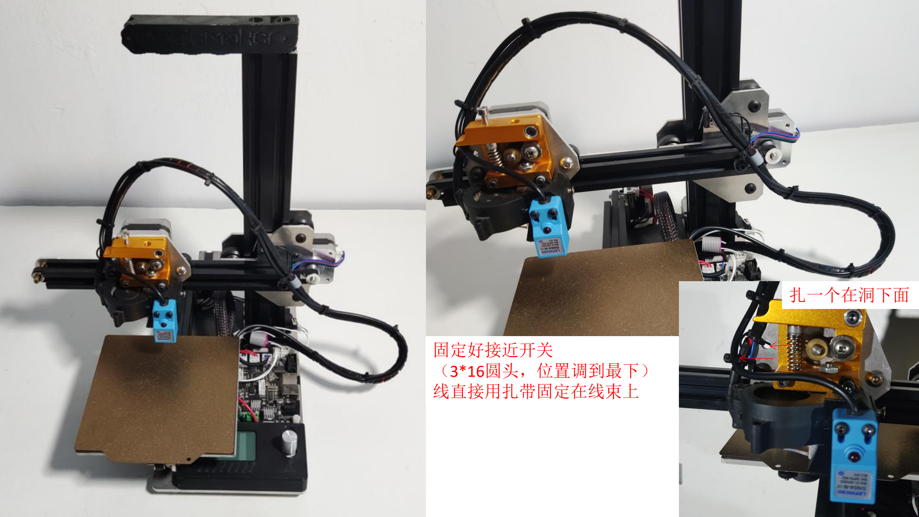
[picture p53: page 4]

固定好接近开关
（3*16圆头，位置调到最下）
线直接用扎带固定在线束上

扎一个在洞下面

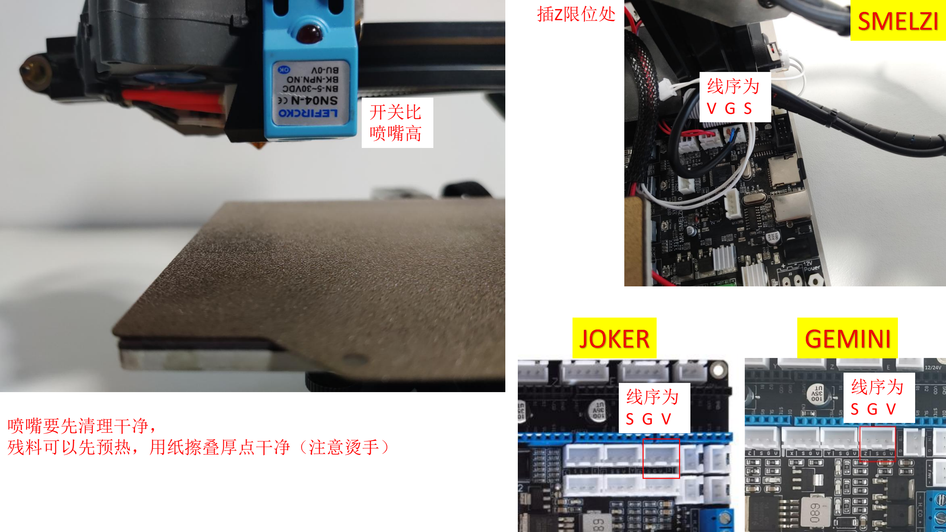
[picture p54: page 5]

线序为
开关比 | V G S
喷嘴高

喷嘴要先清理干净，
残料可以先预热，用纸擦叠厚点干净（注意烫手）

线序为

## S G V

插Z限位处

线序为

## S G V

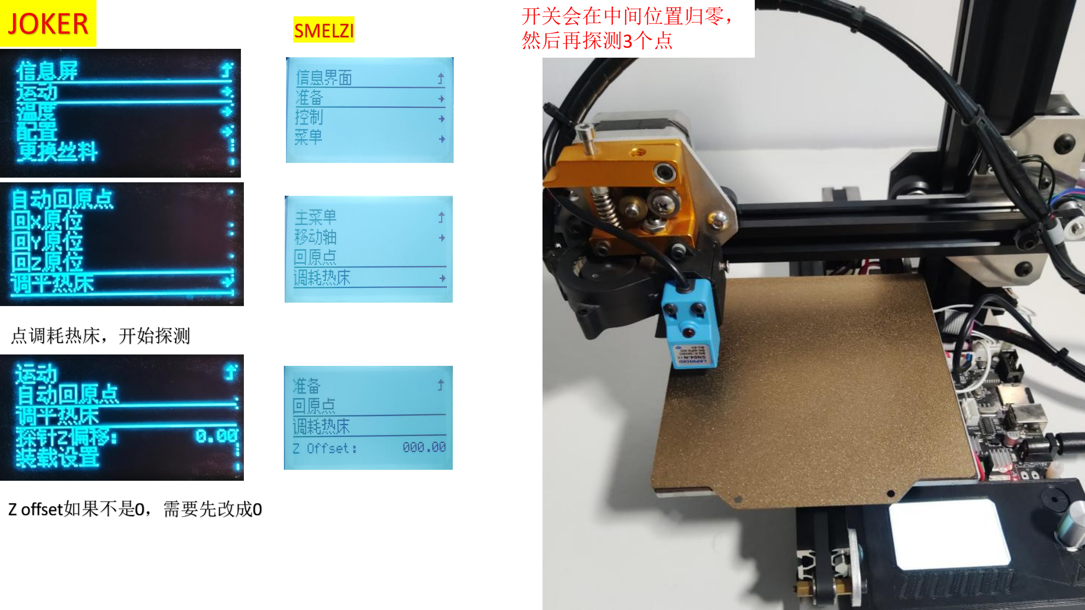
[picture p55: page 6]

开关会在中间位置归零，
然后再探测3个点

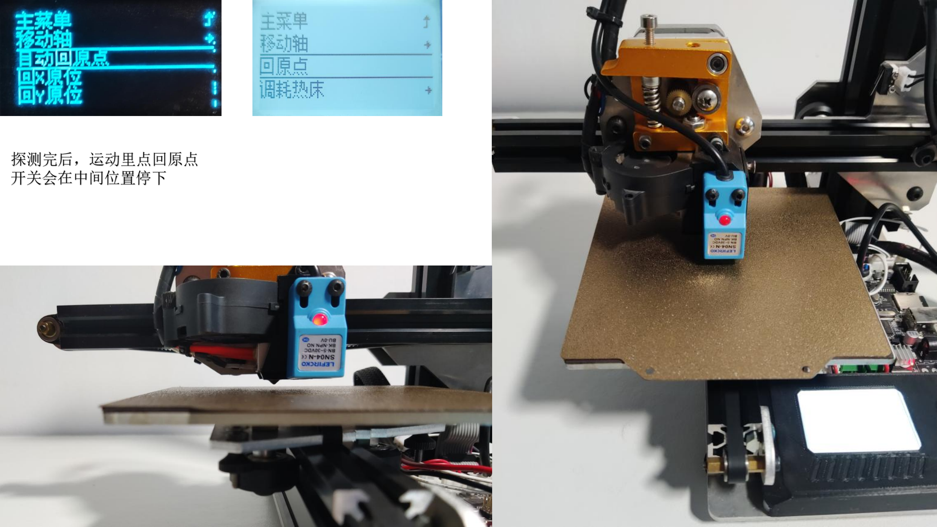
[picture p56: page 7]
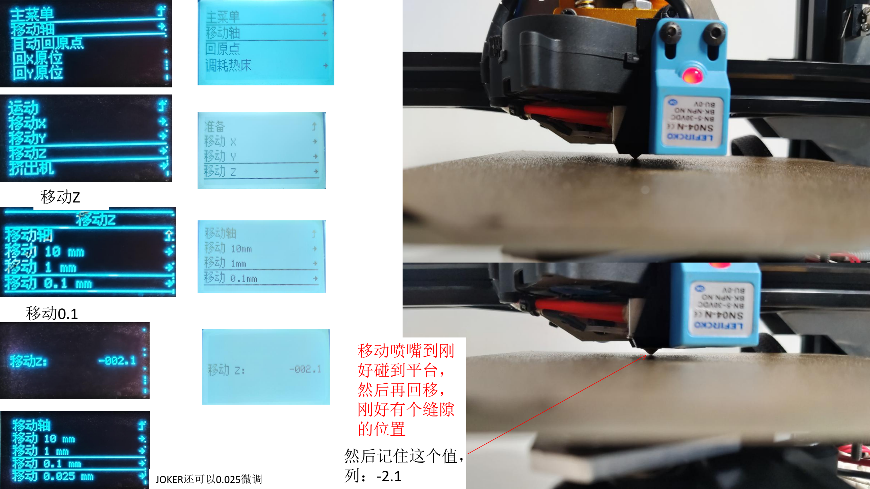
[picture p57: page 8]

移动Z

移动0.1

移动喷嘴到刚
好碰到平台，
然后再回移，
刚好有个缝隙
的位置
然后记住这个值，
JOKER还可以0.025微调 | 列：-2.1

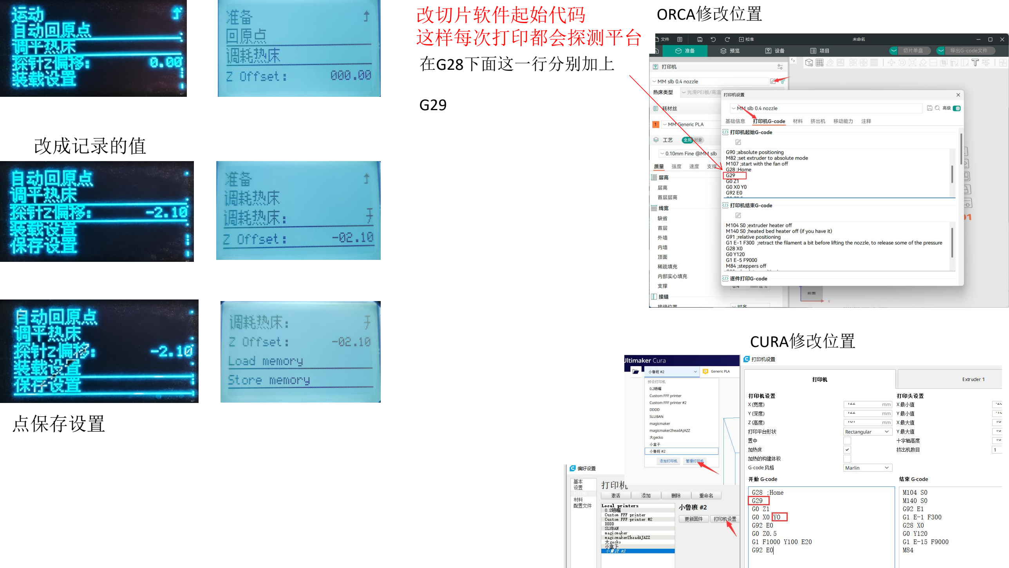
[picture p58: page 9]

改成记录的值

点保存设置

在G28下面这一行分别加上

G29

改切片软件起始代码
这样每次打印都会探测平台

### CURA修改位置

### ORCA修改位置

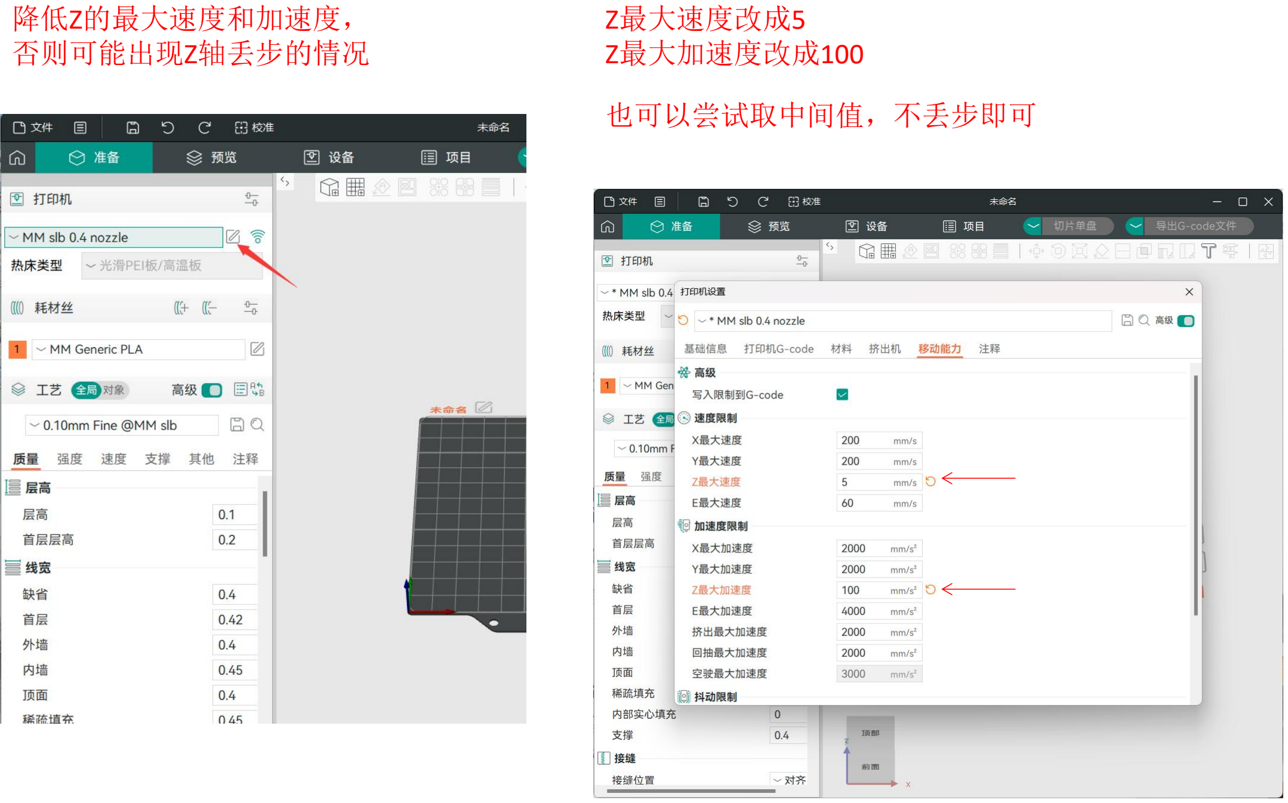
[picture p59: page 10]

降低Z的最大速度和加速度，
否则可能出现Z轴丢步的情况

Z最大速度改成5
Z最大加速度改成100

也可以尝试取中间值，不丢步即可

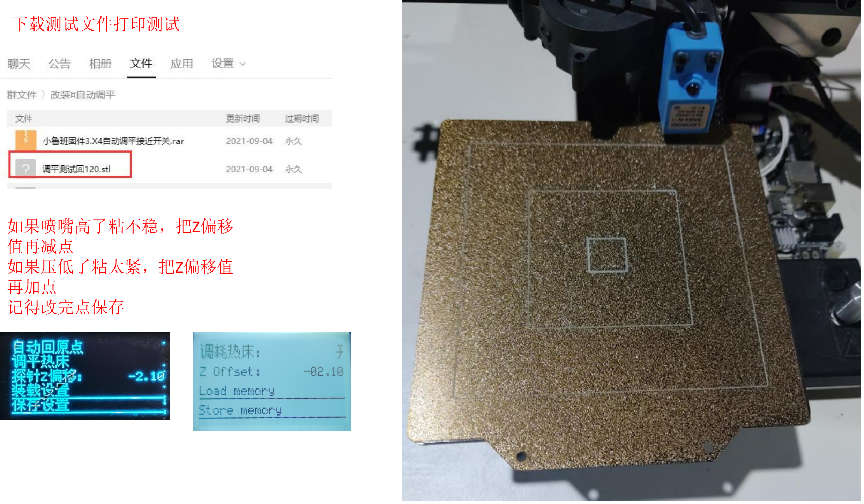
[picture p60: page 11]

如果喷嘴高了粘不稳，把Z偏移
值再减点
如果压低了粘太紧，把Z偏移值
再加点
记得改完点保存

下载测试文件打印测试
