magicmaker3/magicmaker/ESP32主控板JOKER SPARROW/JOKER/Firmware template固件模板/自动调平-自定义C口-插常开接近开关SN04-N-NPN-NO-支持5V.jpg

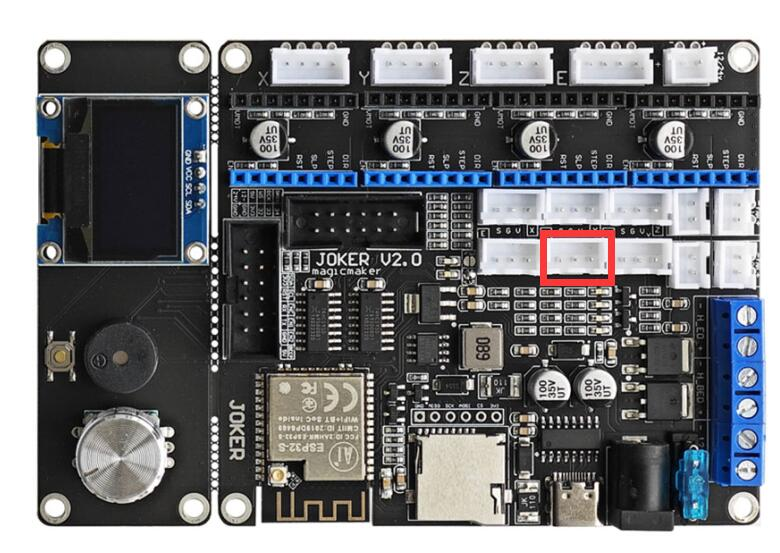
ESP32主控板JOKER SPARROW/JOKER/Firmware template固件模板/自动调平-自定义C口-插常开接近开关SN04-N-NPN-NO-支持5V.jpg
