magicmaker3/magicmaker/ESP32主控板JOKER SPARROW/JOKER/Firmware template固件模板SLUBAN小鲁班/全功能固件更新内容.jpg

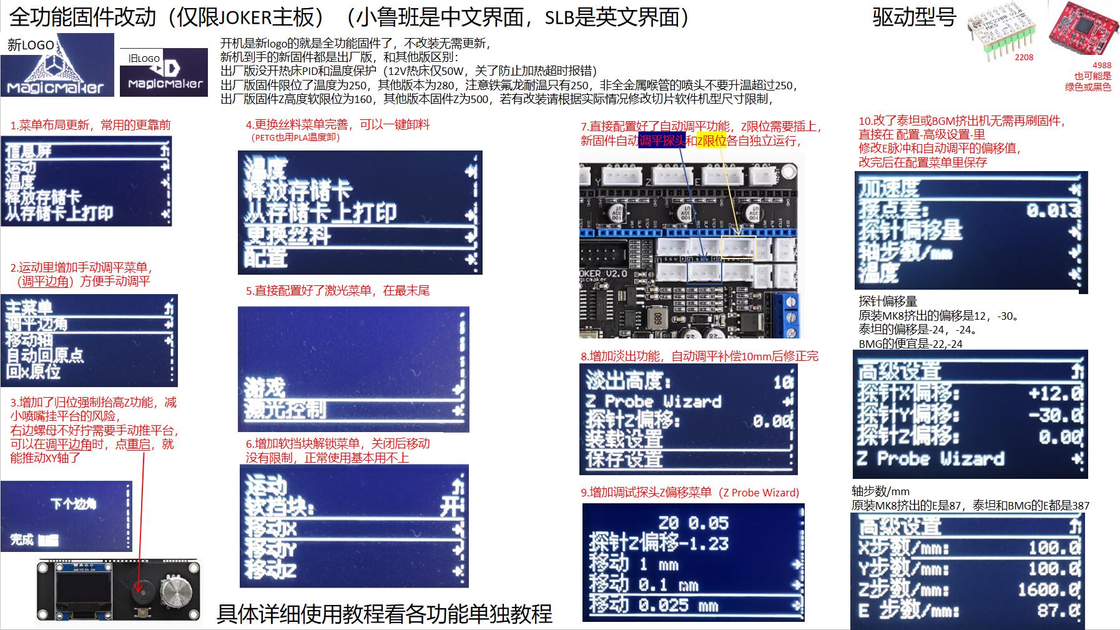
ESP32主控板JOKER SPARROW/JOKER/Firmware template固件模板SLUBAN小鲁班/全功能固件更新内容.jpg
