magicmaker3/magicmaker/ESP32主控板JOKER SPARROW/JOKER/jcanshu.JPG

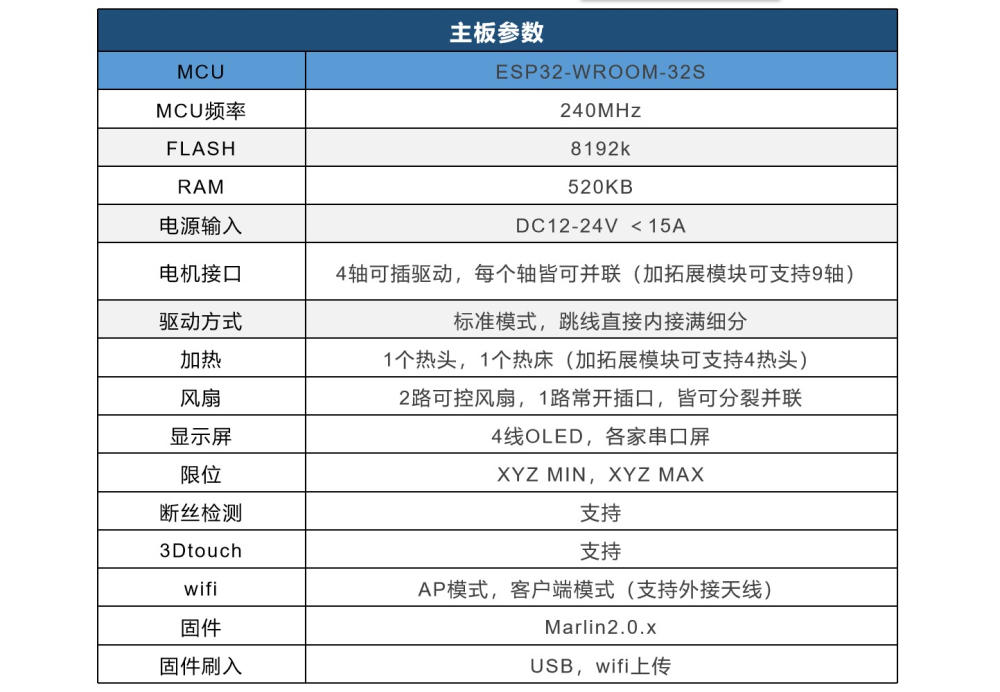
ESP32主控板JOKER SPARROW/JOKER/jcanshu.JPG
