magicmaker3/magicmaker/ESP32主控板JOKER SPARROW/JOKER/JOKER+2+5拓展模块/JOKER+2-PIN.JPG

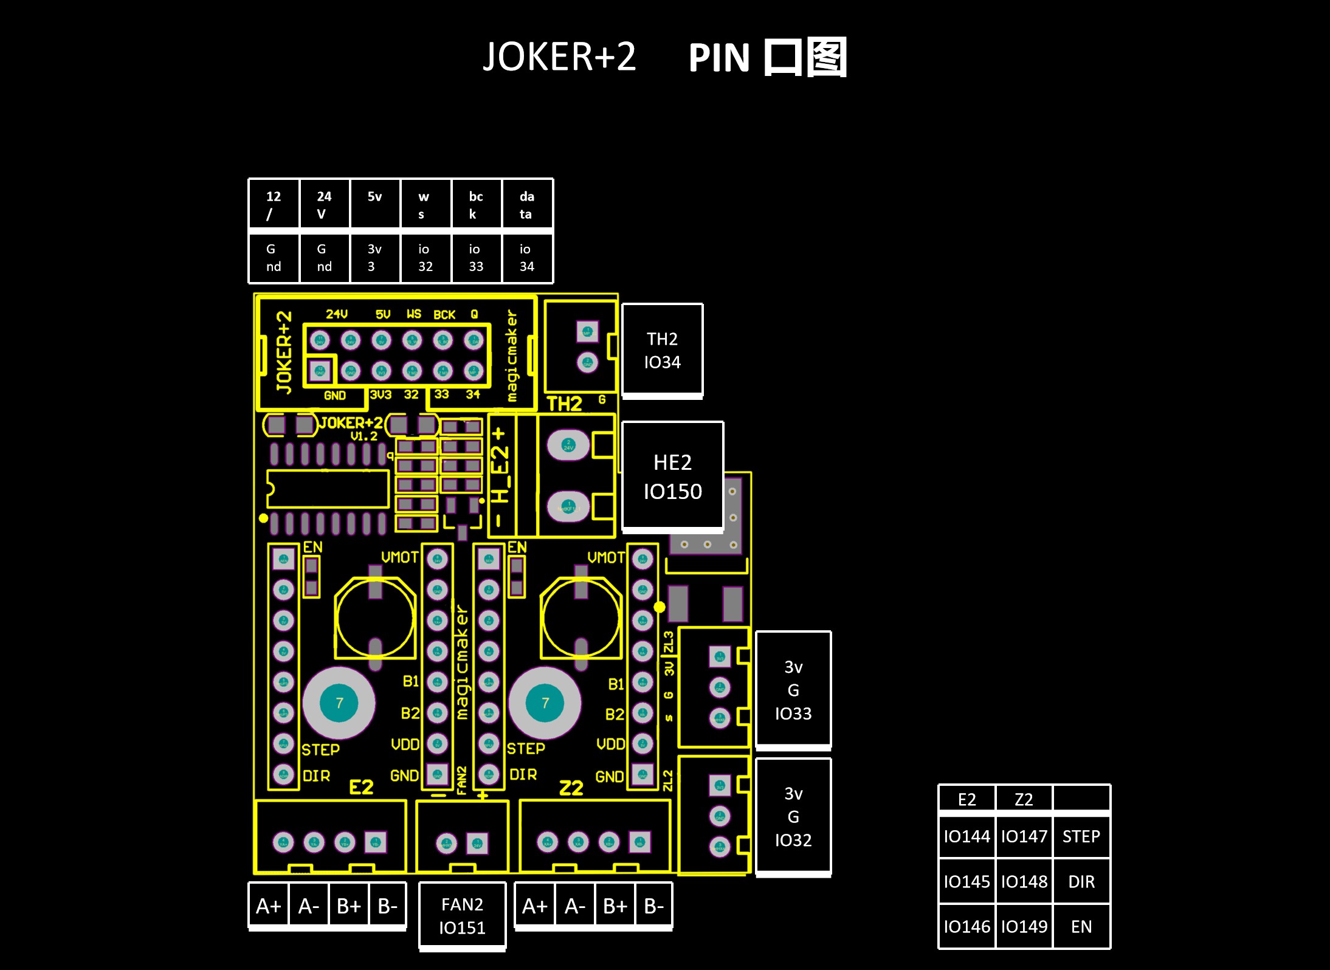
ESP32主控板JOKER SPARROW/JOKER/JOKER+2+5拓展模块/JOKER+2-PIN.JPG
