magicmaker3/magicmaker/ESP32主控板JOKER SPARROW/JOKER/JOKER-尺寸图.jpg

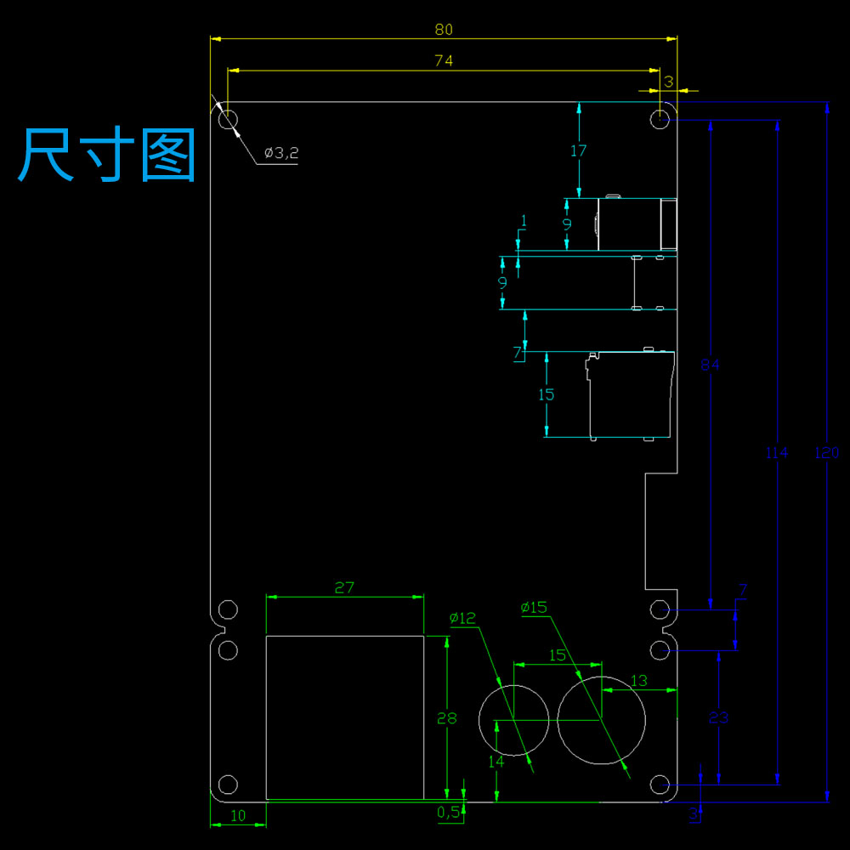
ESP32主控板JOKER SPARROW/JOKER/JOKER-尺寸图.jpg
