magicmaker3/magicmaker/ESP32主控板JOKER SPARROW/JOKER/JOKER接线图.jpg

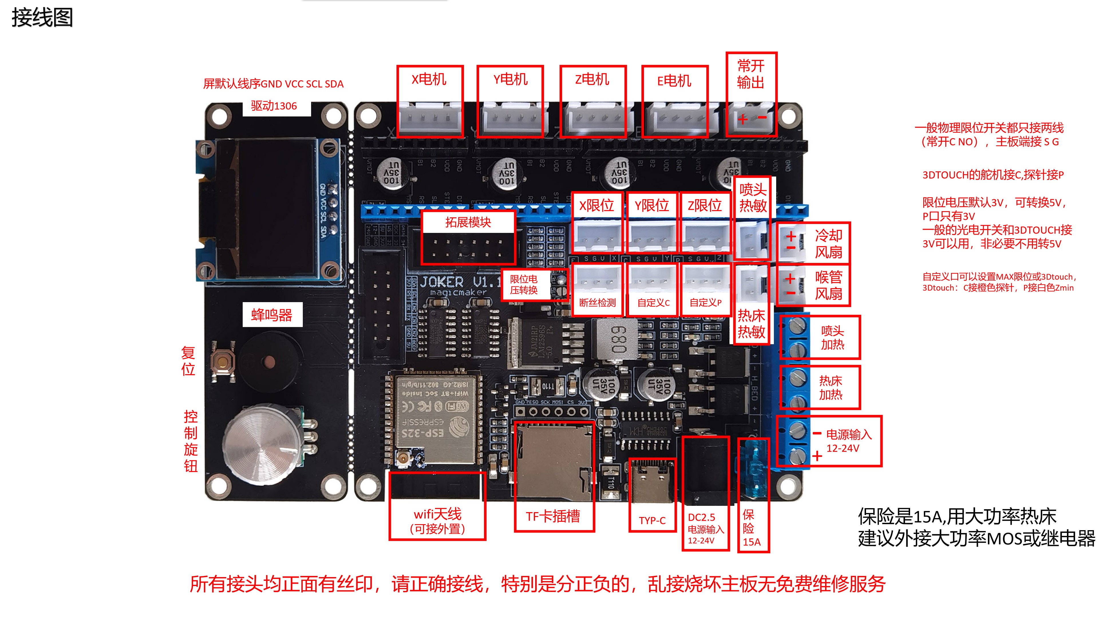
ESP32主控板JOKER SPARROW/JOKER/JOKER接线图.jpg
