magicmaker3/magicmaker/ESP32主控板JOKER SPARROW/JOKER/小鲁班X升级JOKER教程/适配架示意图.jpg

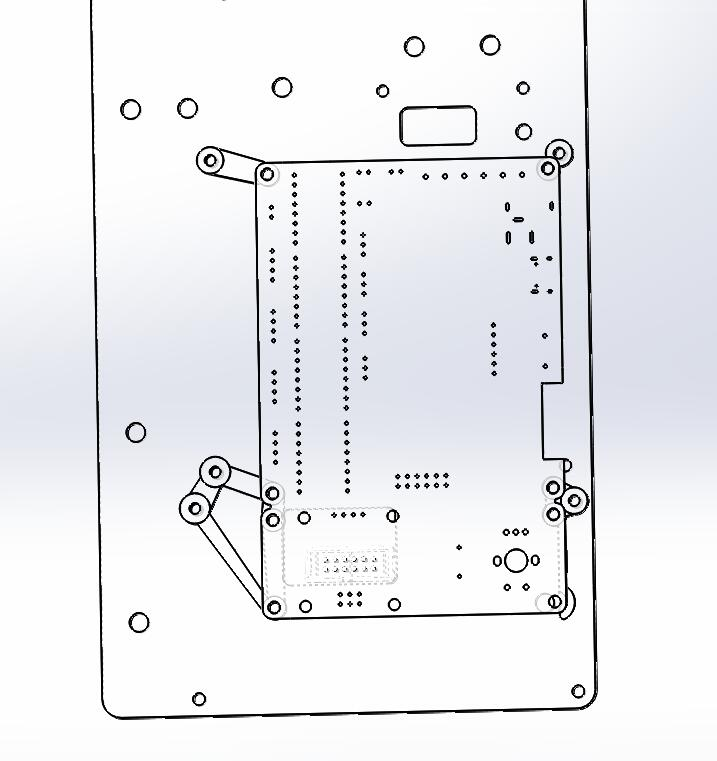
ESP32主控板JOKER SPARROW/JOKER/小鲁班X升级JOKER教程/适配架示意图.jpg
