magicmaker3/magicmaker/ESP32主控板JOKER SPARROW/PID整定教程（marlin2）.JPG

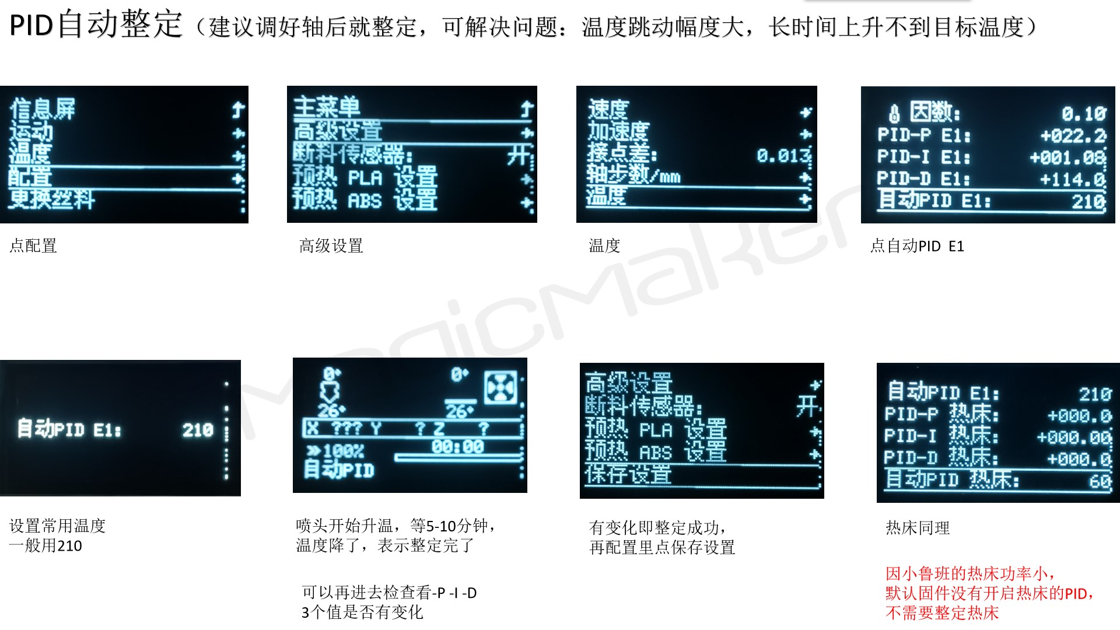
ESP32主控板JOKER SPARROW/PID整定教程（marlin2）.JPG
