magicmaker3/magicmaker/SLuBan-U/小鲁班U螺丝对照图A4纸.jpg

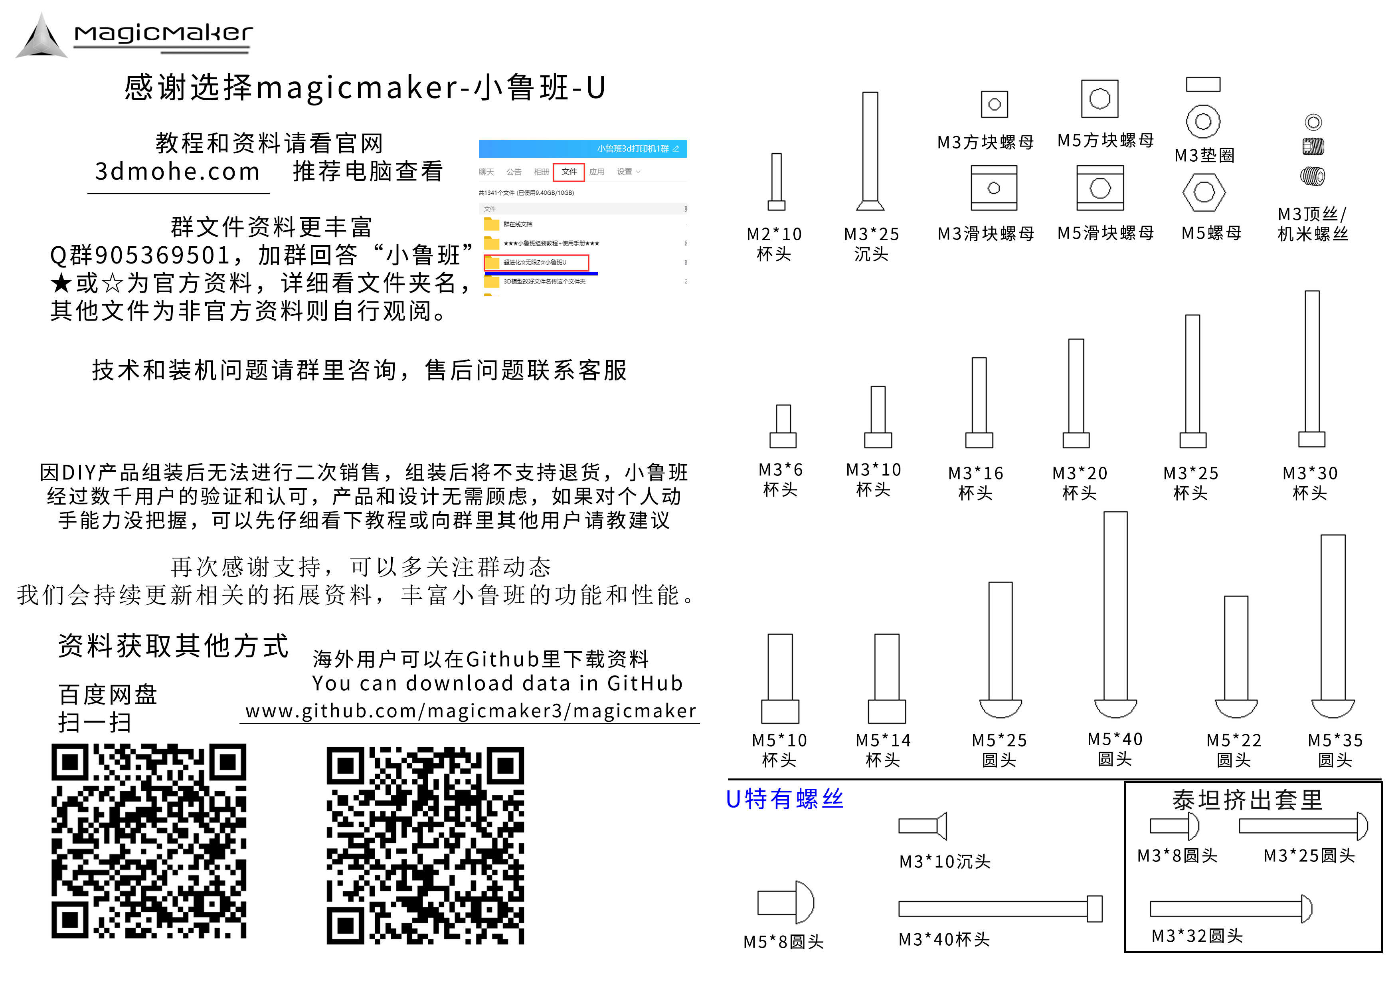
SLuBan-U/小鲁班U螺丝对照图A4纸.jpg
