magicmaker3/magicmaker/SLuban/小鲁班S螺丝对照图A4纸.jpg

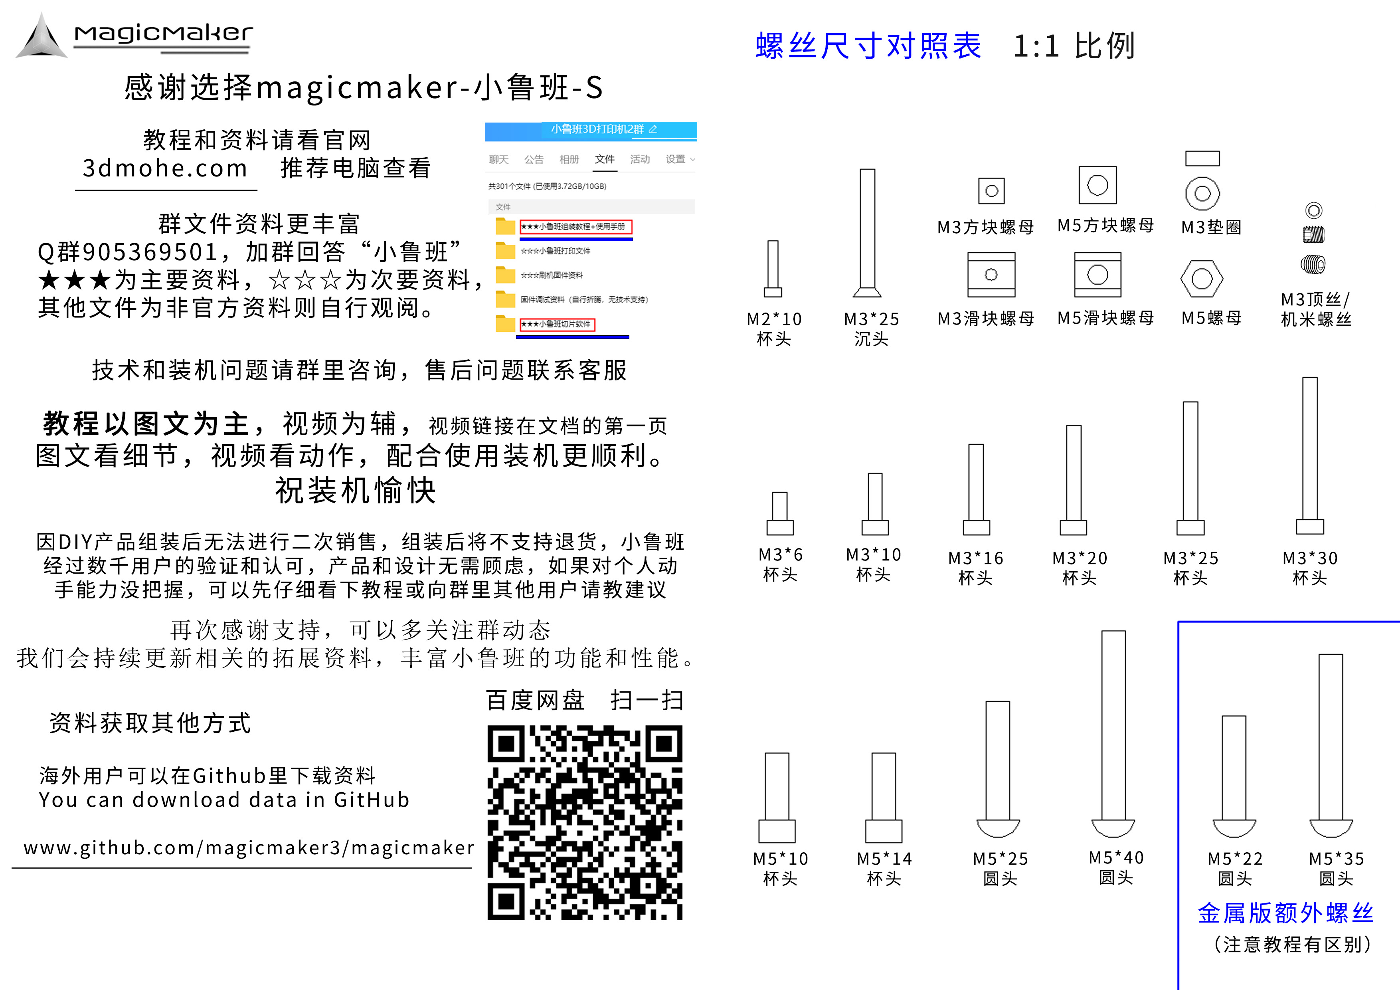
SLuban/小鲁班S螺丝对照图A4纸.jpg
