magicmaker3/magicmaker/SLuban/小鲁班S清单BOM表.xlsx

Sheet: Sheet1
 | o | 名称 | 备注 | 数量 | 单价
 | o | 2040铝型材欧标v-slot 黑色
 | o | 300mm | 切割平整，两边打螺纹15mm | 1
 | o | 200mm |  | 1
 | o | 2020铝型材欧标v-slot 黑色
 | o | 230mm |  | 1
https://item.taobao.com/item.htm?spm=a1z10.5-c.w4002-22195312965.22.2c7a2d5b49nyGq&id=612475469657 | o | 丝杆螺母架 | CNC加工 | 1
https://item.taobao.com/item.htm?spm=a1z10.5-c.w4002-22195312965.22.2c7a2d5b49nyGq&id=612475469657 | o | 铝底板4mm |  | 1
https://item.taobao.com/item.htm?spm=a1z10.5-c.w4002-22195312965.22.2c7a2d5b49nyGq&id=612475469657 | o | 亚克力6mm | 结构板 | 1
 | o | 定制42步进电机 | 高25.5mm | 4
 | o | 电机线 | E 80cm | 1
 | o |  | X 60cm | 1
 | o |  | ZY 20cm | 2
 | o | 法兰轴承F623ZZ |  | 4
 | o | 弹簧 | 6*7*12 | 4
 | o | 调节螺母 | 镀黑锌M3 | 4
 | o | 偏心柱 | 内径5.1外径8高度6 | 4
 | o | 隔离柱5*8*6 |  | 9
 | o | 滑轮小 | 大轴承 | 3
 | o | 滑轮大 |  | 6
 | o | T8丝杆8mm导程2 | 长220mm（端头加工好 | 1
 | o | 法兰螺母切边 | T8导程2 | 1
https://item.taobao.com/item.htm?spm=a1z10.5-c.w4002-22195312965.30.2c7a2d5b49nyGq&id=616609306307 | o | 抱紧式钢性联轴器 | 5*8 | 1
 | o | 同步轮2GT | 5mm孔16齿 | 1
 | o | MK8挤出 | 新版反向（左手）配40齿挤出轮 | 1
https://item.taobao.com/item.htm?spm=a1z10.5-c.w4002-22195312965.16.2c7a2d5b49nyGq&id=611574935822 | o | 铝块E3DV5 | 黑色新版 | 1
 | o | 喉管 (https://item.taobao.com/item.htm?id=44449201543&_u=fnon41s387f) | M6*40，内置铁氟龙（切平整 | 1
 | o | E3D喷嘴0.4 | 1.75/0.4 | 1
 | o | 加热棒 | 6*15 12V40W 线长90cm | 1
 | o | 热敏 带2.54端子 | XH2.54端子 80cm | 1
 | o | 同步带2GT | 宽6mm | 1.2
 | o | 涡轮风扇4020 | 12V 90cm XH2.54端子正头 | 1
 | o | 限位开关带弹片 |  | 3
 | o | 限位线 | X黑色 45cm | 1
 | o |  | Y红色 15cm | 1
 | o |  | Z白色 10cm | 1
 | o | 适配器 | 12V足10A | 1
 | o | wifi主板joker | 带显示屏 | 1
 | o | 4988驱动 |  | 4
https://item.taobao.com/item.htm?spm=a1z10.5-c.w4002-22195312965.28.2c7a2d5b49nyGq&id=615959888998 | o | 热床 |  | 1
 | o | 3M胶 | 300LSE | 1
 | o | 橡胶脚垫21*17*12 |  | 4
 | o | 带孔平头销钉8*80 | 料架 | 1
 | o | M6薄螺母 | 厚度3mm | 1
 | o | 20型材滑块螺母M3 |  | 3
 | o | 20型材滑块螺母M5 | 长度不超过11mm | 3
 | o | M3四方螺母3*5.5*2 |  | 15
 | o | M5四方螺母5*8*3 |  | 15
 | o | M5防松螺母 |  | 9
 | o | 铜柱M3*6 | 双通 | 9
 | o | ABS隔离柱7*3*3 | 外径*内径*高度 | 10
 | o | 3*6*0.5垫圈 |  | 30
 | o | PVC软垫片 | M3*6*1 | 3
 | o | 内6角螺丝
 | o | M2*10杯头 | 304 | 7
 | o | M3*10杯头 | 12.9级 | 20
 | o | M3*8圆头 | 12.9级 | 5
 | o | M3*16圆头 | 12.9级 | 9
 | o | M3*20杯头 | 12.9级 | 5
 | o | M3*25杯头 | 12.9级 | 6
 | o | M3*30杯头 | 12.9级 | 2
 | o | M3*25沉头 | 不锈钢304 | 4
 | o | M5*10圆头 | 12.9级 | 10
 | o | M5*14杯头 | 不锈钢201 | 8
 | o | M5*25圆头 | 12.9级 | 6
 | o | M5*40圆头 | 12.9级 | 3
 | o
 | o | 绕线带黑6mm | 1M | 1
 | o | 扎带3*80 | 2.5宽 | 20
 | o | R型线夹 | R型6.4mm | 2
 | o | 打印件 | 风扇架风扇罩料架 | 1
 | 白金套餐 | 高速内存卡4G |  | 1
 | 白金套餐 | 读卡器 |  | 1
 | 白金套餐 | 42步进电机 | 34 | 2
https://item.taobao.com/item.htm?spm=a1z10.5-c.w4002-22195312965.32.2c7a2d5b49nyGq&id=633946927081 | 白金套餐 | 磁吸平台 |  | 1
 | 白金套餐 | 断丝检测 |  | 1
 | 白金套餐 | 耗材200G |  | 1
 | 至尊套餐 | 铝合金3mm | 结构板 | 1
https://item.taobao.com/item.htm?spm=a1z10.5-c.w4002-22195312965.36.2c7a2d5b49nyGq&id=649268749323 | 至尊套餐 | pei平台 |  | 1
https://item.taobao.com/item.htm?spm=a1z10.5-c.w4002-22195312965.20.756264983puzkP&id=676696046218 | 至尊套餐 | 金属开关大电流15A带灯 |  | 1
https://item.taobao.com/item.htm?spm=a1z10.5-c.w4002-22195312965.40.2c7a2d5b49nyGq&id=655490162936 | 至尊套餐 | 接近开关 | 定制5-24V | 1
 | o | 纸箱350*240*130内尺寸 |  | 1 | 4
 | o | 珍珠棉包装 |  | 1 | 10
 | o | 运费 |  | 1 | 15
 | o | 内六扳手1.5/2.0/2.5/3.0/4.0 | 碳钢 | 1
 | o | 小起子 | 2mm一字 | 1
 | o | 开口扳手 | 8-10（一个多厚 | 1
 | o | 自封袋8丝
 | o |  | 5*7 | 6
 | o |  | 8*12 | 10
 | o |  | 12*17 | 2

Sheet: 子清单
M3 垫片 | 30
PVC软垫片 | 3
M2*10 杯头 | 7
隔离柱 h3 | 10
滑块螺母 M3 | 3
滑块螺母 M5 | 3
四方螺母 M3 | 15
四方螺母 M5 | 15
M5 防松螺母 | 9
铜柱 M3*6 | 9
M3*10 杯头 | 20
M3*20 杯头 | 5
M3*25 杯头 | 6
M3*30 杯头 | 2
M3*8 圆头 | 5
M3*16 圆头 | 9
M5*14 杯头 | 8
M5*10 圆头 | 10
M5*25 圆头 | 6
M5*40 圆头 | 3
M3*25 沉头 | 4
弹簧 | 4
M3调节螺母 | 4
偏心柱 | 4
隔离柱5*8*6 | 9

Sheet: 带图
名称 | 备注
滑轮小 |  | 3 |  | 1.7
滑轮大 |  | 6 |  | 1.6
T8丝杆8mm导程2 | 长220mm（端头加工好 | 1 | 500 | 3.5 | 1750 | 涡轮风扇4020 | 12V 线长90cm XH2.54端子正头 | 1 |  | 3.2
法兰螺母切边 | T8导程2 | 1 | 500 | 1.3 | 650 | 同步带2GT宽6mm | 每根1.2米 | 1.2 |  | 3
钢性联轴器 | 5*8 | 1 | 200 | 3.2 | 640
同步轮5mm孔16齿 |  | 2 | 950 | 1.2 | 1140 | 电机架 |  | 1 |  | 1.9
同步带2GT宽6mm |  | 1 | 600 | 2 | 1200 | 弹性联轴器 | 5*8 | 1 | 0 | 2.2
MK8挤出套 | 新版反向（左手）配40齿挤出轮 | 1 | 500 | 8.3 | 4150
 |  |  |  |  | 9530
热敏 带2.54端子 | XH2.54端子 80cm | 1 |  | 1.6
加热棒 | 6*15 12V40W 线长0.9m | 1 |  | 2.6
铝块E3DV5 |  | 1 | 700 | 1.4 | 980
喉管E3DV6 (https://item.taobao.com/item.htm?id=44449201543&_u=fnon41s387f) | M6*40 | 1 | 700 | 1.5 | 1050
喷嘴0.4 | 1.75/0.4 | 1 | 700 | 0.4 | 280
 | 热敏 |  | 250 | 0.6 | 150
铝块E3DV5新版 |  |  |  | 1.5

Sheet: 金属升级螺丝
金属升级套螺丝
3*6*0.5垫圈 |  | 20 | 0.0019 | 0.038 | 2
M3*8杯头 | 12.9级 | 3 | 0.033 | 0.099 | 2 | X架2
M3*6圆头 | 12.9级 | 10 | 0.033 | 0.33 | 4 | Y电机2 X电机2 Y同步带4
M3*20杯头 | 12.9级 | 1 | 0.044 | 0.044 | 1 | X同步带1
M5*8圆头 | 12.9级 | 5 | 0.052 | 0.26 | 4 | 导轮2Y电机架2
M5*22圆头 | 12.9级 | 1 | 0.062 | 0.062 | 1 | X导轮
M5*35圆头 | 12.9级 | 1 | 0.12 | 0.12 | 1 | Z导轮
M3*23杯头 | 12.9级 | 1 | 0.053 | 0.053 | 1
M3*28杯头 | 12.9级 | 1 | 0.059 | 0.059 | 1
