magicmaker3/magicmaker/SLuban/Related model files机身模型/小鲁班S外壳shell/Main board cover3.5主板盖.stl

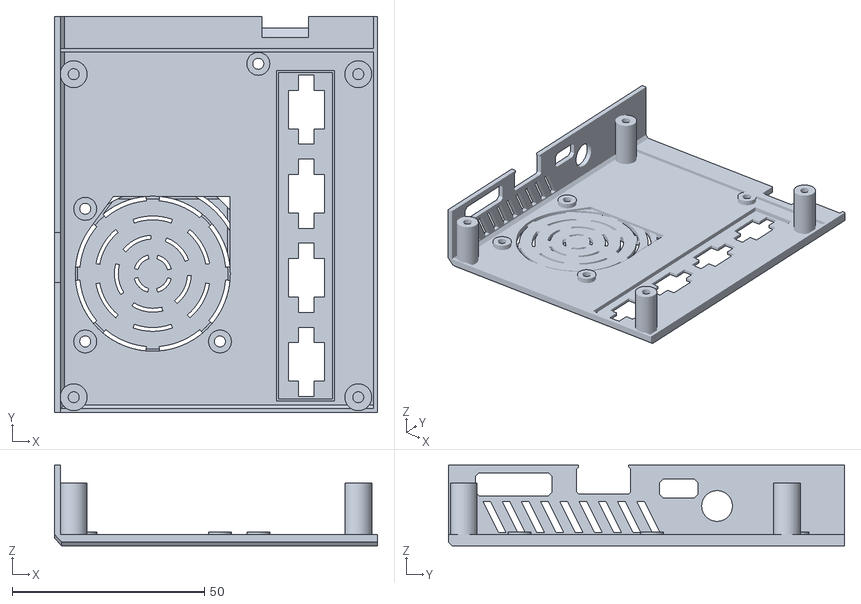
[picture p72: CAD file, 2023-03-16]
SLuban/Related model files机身模型/小鲁班S外壳shell/Main board cover3.5主板盖.stl
84.0 x 103.0 x 21.0
