magicmaker3/magicmaker/SLuban/Related model files机身模型/小鲁班SL外壳shell/SL-Main board cover主板盖.stl

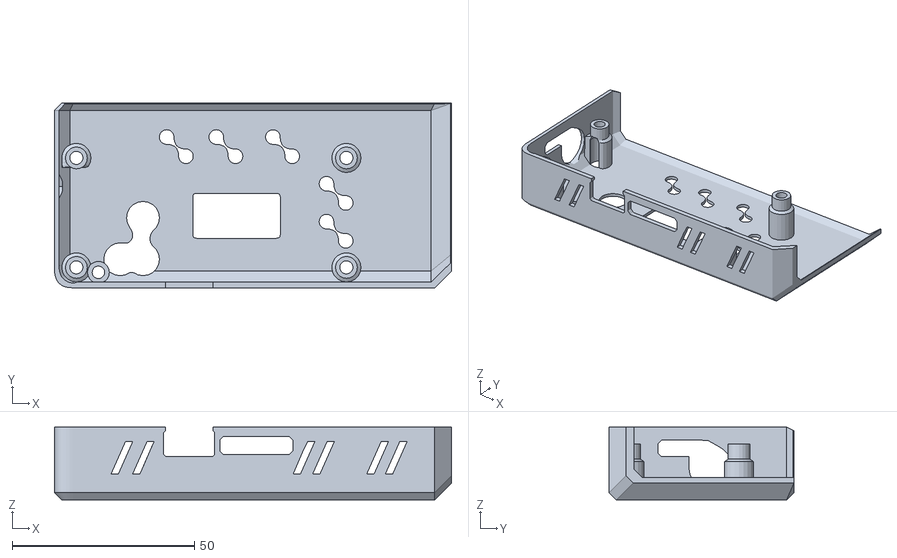
[picture p73: CAD file, 2026-03-28]
SLuban/Related model files机身模型/小鲁班SL外壳shell/SL-Main board cover主板盖.stl
108.8 x 50.6 x 20.0
