magicmaker3/magicmaker/SLuban/Related model files机身模型/小鲁班SP外壳shell/SP-Main board cover主板盖.stl

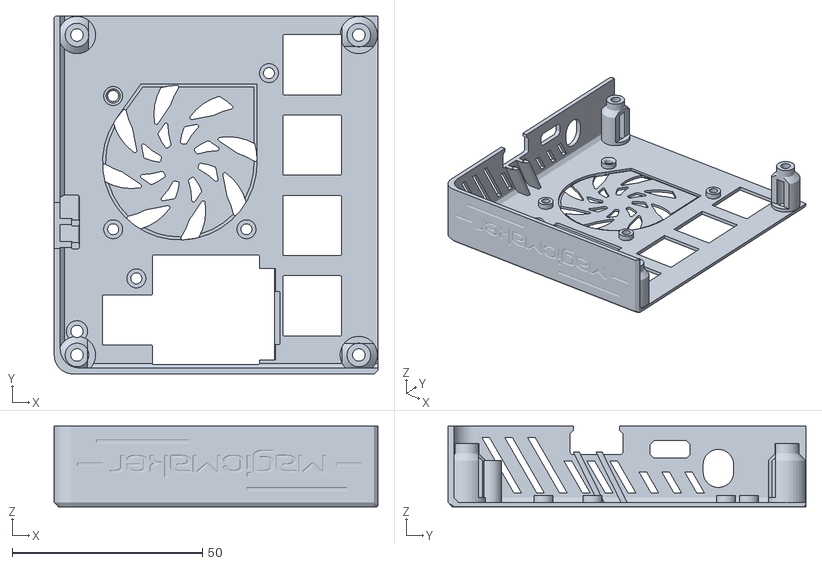
[picture p74: CAD file, 2026-09-19]
SLuban/Related model files机身模型/小鲁班SP外壳shell/SP-Main board cover主板盖.stl
85.0 x 94.0 x 21.2
