magicmaker3/magicmaker/ESP32主控板JOKER SPARROW/JOKER/3D文件/joker底板B.stl

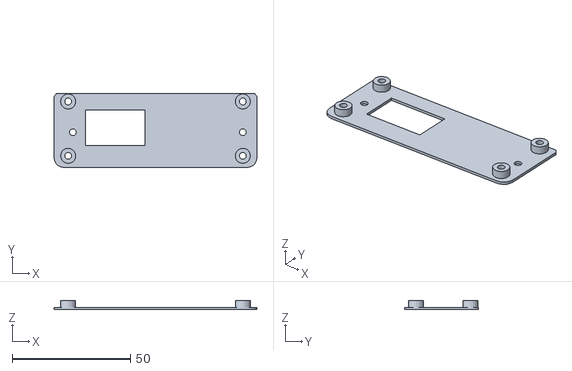
[picture p75: CAD file, 2026-03-28]
ESP32主控板JOKER SPARROW/JOKER/3D文件/joker底板B.stl
86.0 x 31.4 x 4.00
