magicmaker3/magicmaker/ESP32主控板JOKER SPARROW/JOKER/3D文件/小鲁班S专用打印件/小鲁班S屏盖3.6（下装螺丝版）.stl

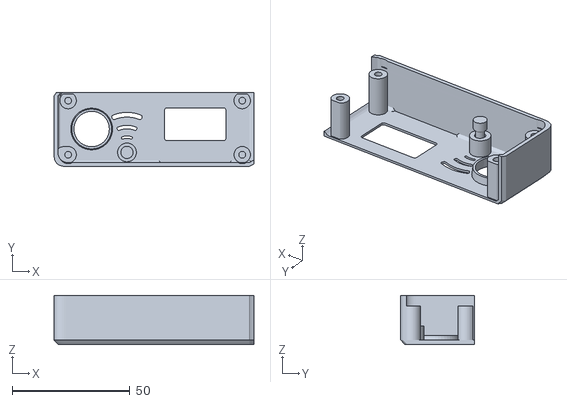
[picture p76: CAD file, 2026-03-28]
ESP32主控板JOKER SPARROW/JOKER/3D文件/小鲁班S专用打印件/小鲁班S屏盖3.6（下装螺丝版）.stl
85.0 x 31.4 x 21.0
