magicmaker3/magicmaker/ESP32主控板JOKER SPARROW/JOKER/小鲁班X升级JOKER教程/线盖1.5.stl

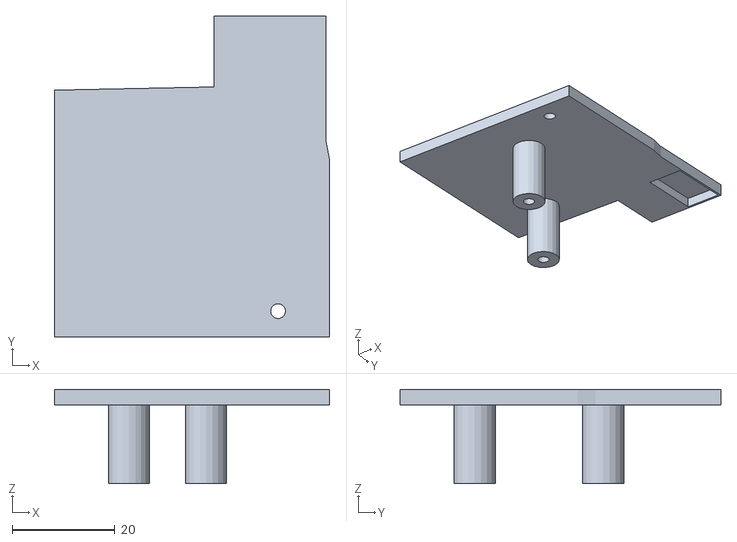
[picture p77: CAD file, 2022-11-03]
ESP32主控板JOKER SPARROW/JOKER/小鲁班X升级JOKER教程/线盖1.5.stl
53.5 x 62.4 x 18.3
