magicmaker3/magicmaker/ESP32主控板JOKER SPARROW/SPARROW/3D文件/小鲁班SX专业打印件/小鲁班SX简易主板盖.stl

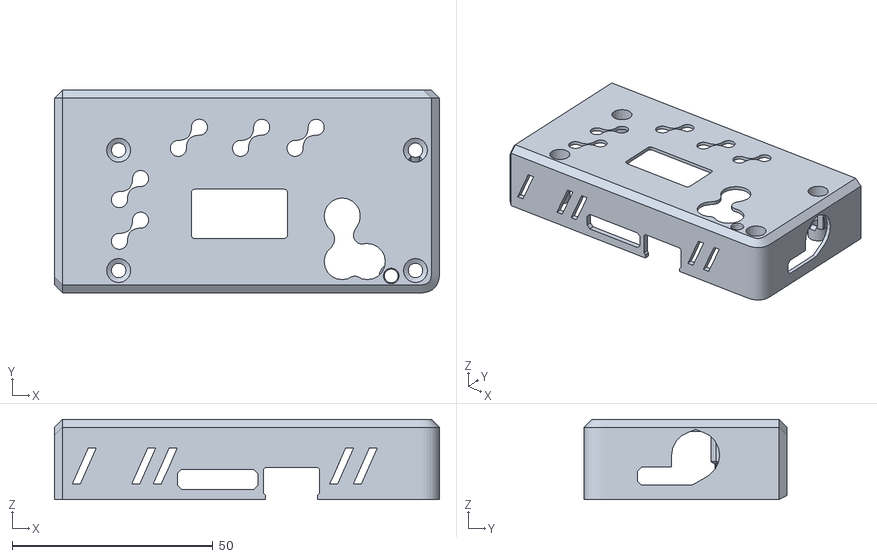
[picture p78: CAD file, 2026-03-28]
ESP32主控板JOKER SPARROW/SPARROW/3D文件/小鲁班SX专业打印件/小鲁班SX简易主板盖.stl
96.0 x 50.6 x 20.0
