magicmaker3/magicmaker/ESP32主控板JOKER SPARROW/SPARROW/3D文件/麻雀壳底.stl

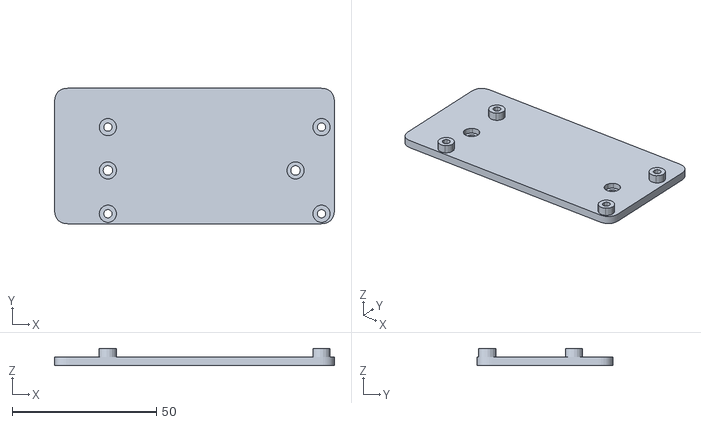
[picture p79: CAD file, 2026-03-28]
ESP32主控板JOKER SPARROW/SPARROW/3D文件/麻雀壳底.stl
97.0 x 47.0 x 6.00
