magicmaker3/magicmaker/SLuBan-U/Related model files机身模型/Already equipped已配/风扇罩1.2.stl

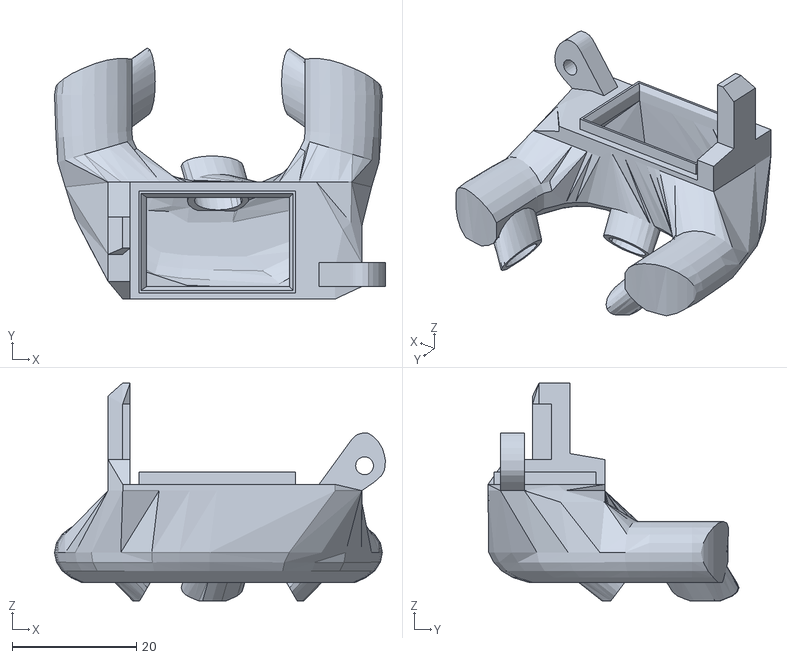
[picture p80: CAD file, 2026-07-19]
SLuBan-U/Related model files机身模型/Already equipped已配/风扇罩1.2.stl
53.2 x 40.4 x 35.0
