magicmaker3/magicmaker/SLuBan-U/Related model files机身模型/Side cover边盖U.stl

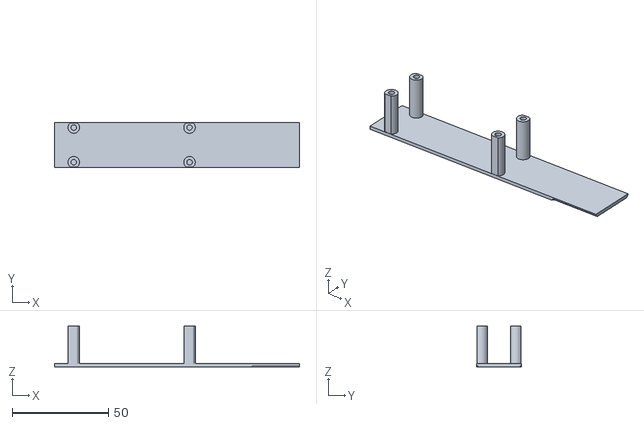
[picture p81: CAD file, 2026-05-23]
SLuBan-U/Related model files机身模型/Side cover边盖U.stl
127.0 x 23.1 x 21.0
