magicmaker3/magicmaker/SLuBan-U/Slicing software切片软件/小鲁班U-cura3.6配置文件1.2.3mf

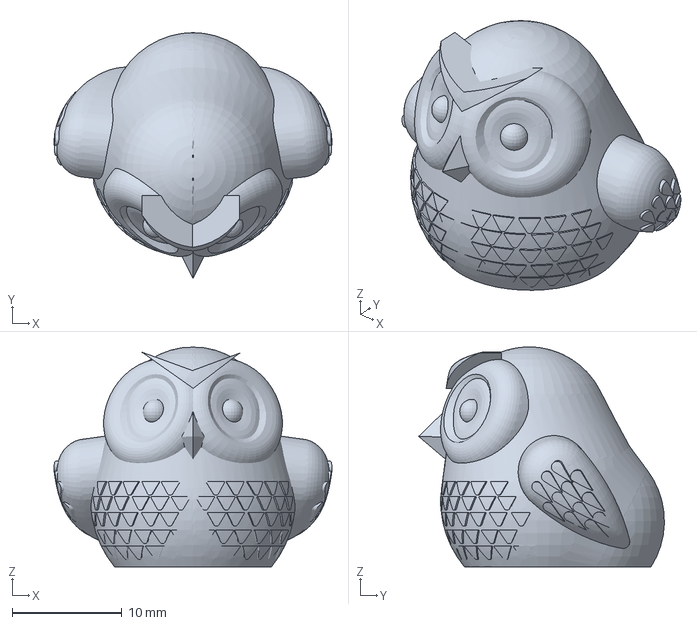
[picture p82: CAD file, 2025-09-22]
SLuBan-U/Slicing software切片软件/小鲁班U-cura3.6配置文件1.2.3mf
25.3 x 22.4 x 20.0 mm
