magicmaker3/magicmaker/SLuban/refit data 改装资料/Automatic leveling自动调平/调平测试回120.stl

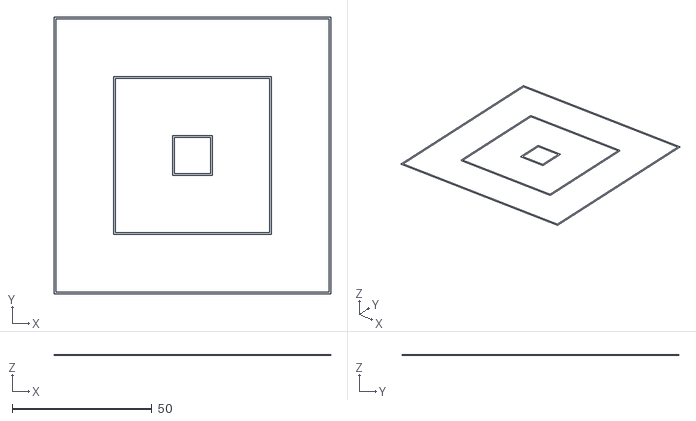
[picture p83: CAD file, 2024-08-17]
SLuban/refit data 改装资料/Automatic leveling自动调平/调平测试回120.stl
99.0 x 99.0 x 0.2
