magicmaker3/magicmaker/SLuban/Related model files机身模型/Already equipped已配/Fan cover风扇罩S2.8（可装硅胶套.stl

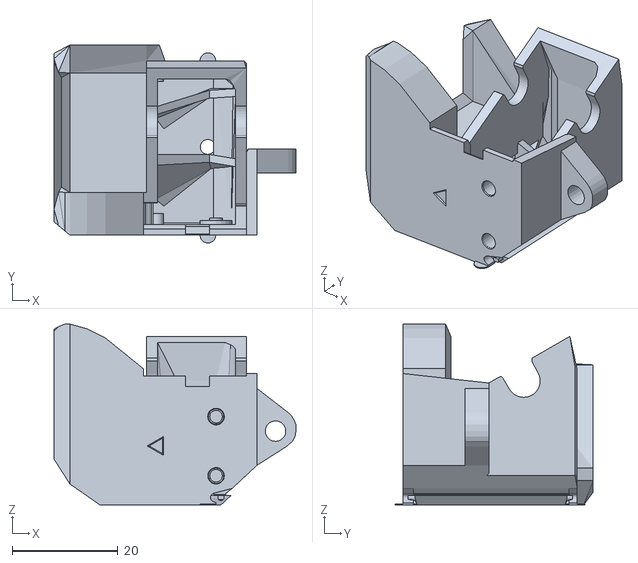
[picture p84: CAD file, 2025-01-15]
SLuban/Related model files机身模型/Already equipped已配/Fan cover风扇罩S2.8（可装硅胶套.stl
45.8 x 37.5 x 34.2
