magicmaker3/magicmaker/SLuban/Related model files机身模型/小鲁班SL外壳shell/SL-Back cover后盖.stl

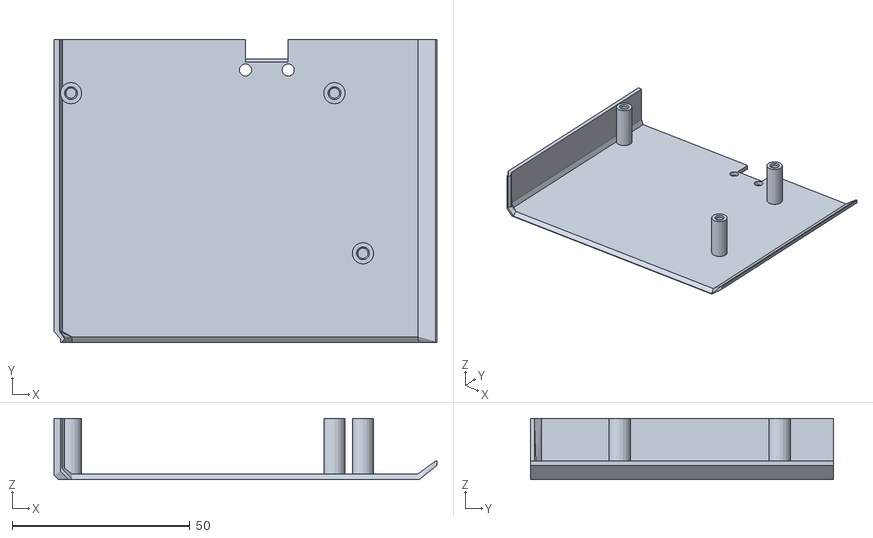
[picture p85: CAD file, 2026-09-19]
SLuban/Related model files机身模型/小鲁班SL外壳shell/SL-Back cover后盖.stl
107.6 x 85.0 x 17.2
