magicmaker3/magicmaker/SLuban/Related model files机身模型/小鲁班SP外壳shell/SP-Wire cover线盖.STL

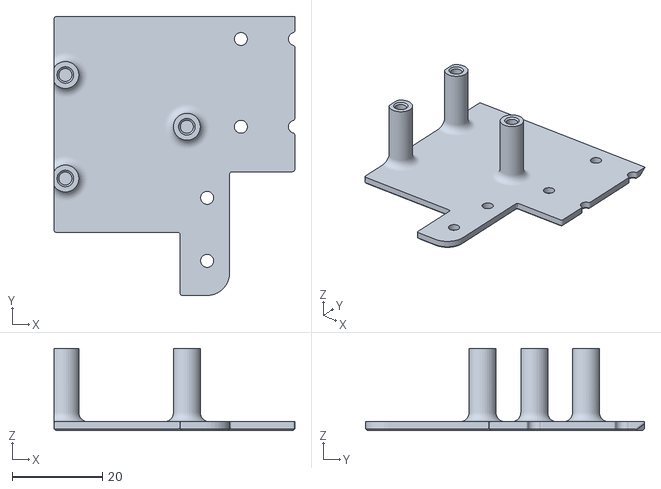
[picture p86: CAD file, 2026-09-19]
SLuban/Related model files机身模型/小鲁班SP外壳shell/SP-Wire cover线盖.STL
53.5 x 62.0 x 18.3
