magicmaker3/magicmaker/ESP32主控板JOKER SPARROW/JOKER/3D文件/joker底板AB一体.stl

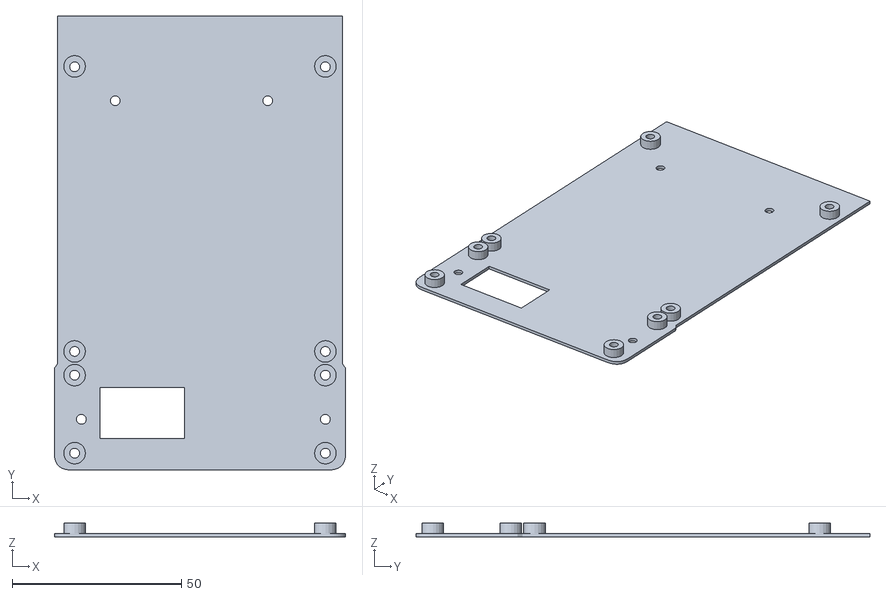
[picture p87: CAD file, 2026-03-28]
ESP32主控板JOKER SPARROW/JOKER/3D文件/joker底板AB一体.stl
86.0 x 134.0 x 4.00
