magicmaker3/magicmaker/ESP32主控板JOKER SPARROW/JOKER/小鲁班X升级JOKER教程/脚前A-1.STL

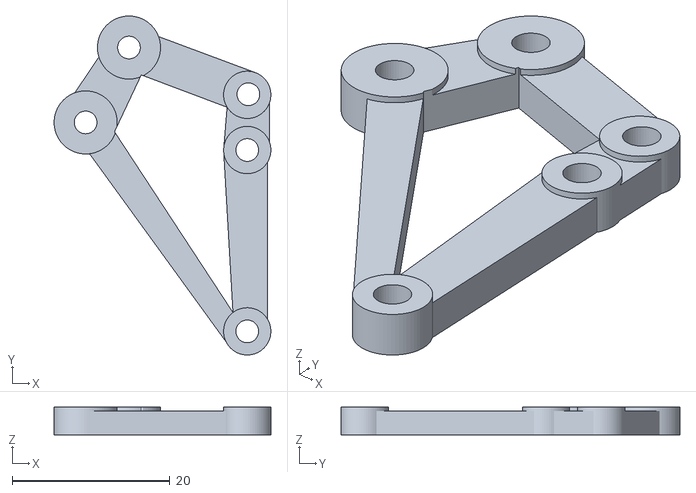
[picture p88: CAD file, 2022-11-03]
ESP32主控板JOKER SPARROW/JOKER/小鲁班X升级JOKER教程/脚前A-1.STL
27.5 x 43.0 x 3.50
