magicmaker3/magicmaker/ESP32主控板JOKER SPARROW/SPARROW/3D文件/麻雀壳.stl

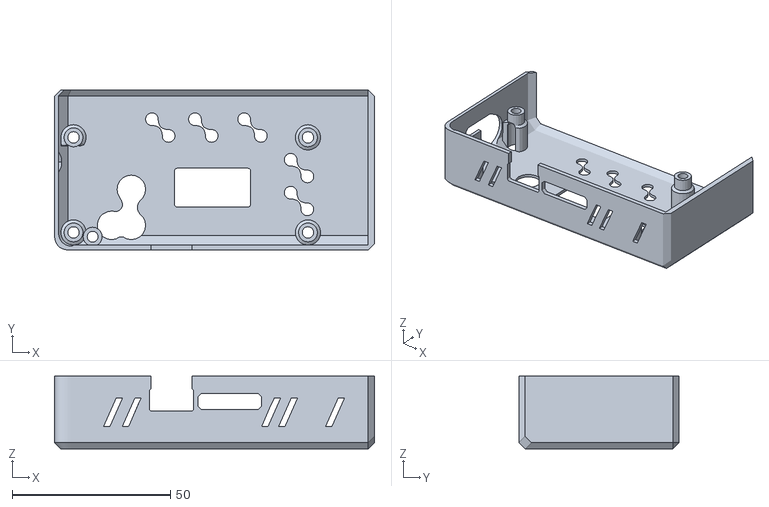
[picture p89: CAD file, 2026-03-28]
ESP32主控板JOKER SPARROW/SPARROW/3D文件/麻雀壳.stl
101.0 x 50.6 x 23.0
