magicmaker3/magicmaker/SLuBan-U/Related model files机身模型/Already equipped已配/料架座.stl

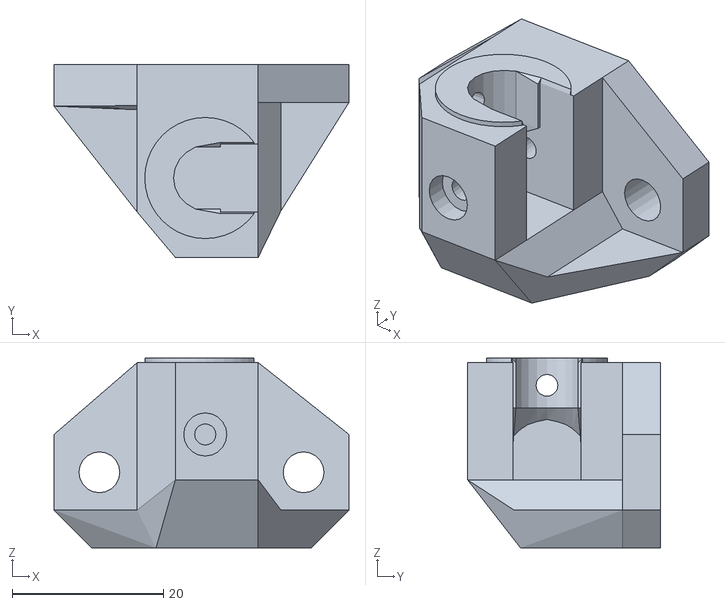
[picture p90: CAD file, 2026-07-19]
SLuBan-U/Related model files机身模型/Already equipped已配/料架座.stl
39.0 x 25.5 x 25.1
