magicmaker3/magicmaker/SLuBan-U/Related model files机身模型/开关架U.stl

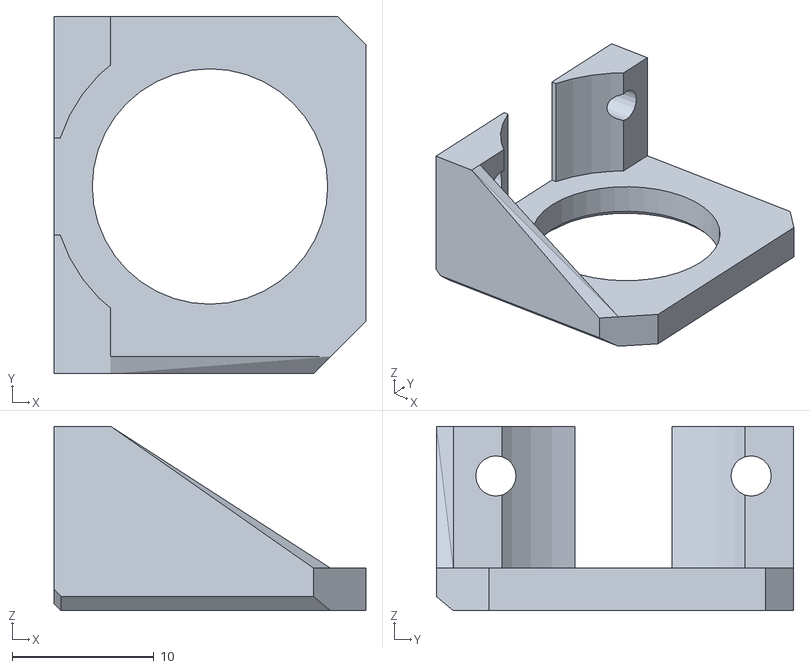
[picture p91: CAD file, 2025-09-22]
SLuBan-U/Related model files机身模型/开关架U.stl
22.0 x 25.2 x 13.0
