magicmaker3/magicmaker/SLuban/Related model files机身模型/Already equipped已配/料架臂X1.4（关支撑.stl

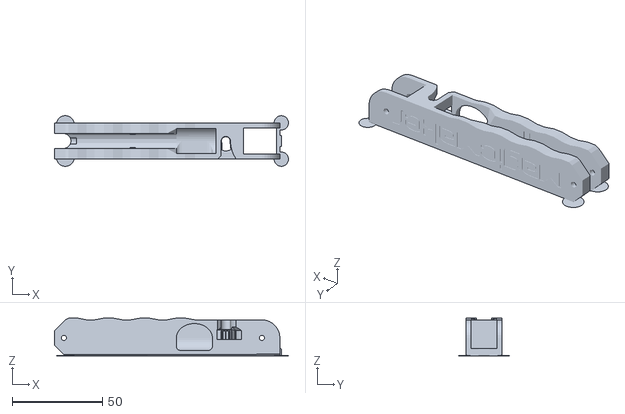
[picture p92: CAD file, 2025-01-07]
SLuban/Related model files机身模型/Already equipped已配/料架臂X1.4（关支撑.stl
129.8 x 28.2 x 21.0
