magicmaker3/magicmaker/SLuban/Related model files机身模型/小鲁班SP外壳shell/SP-Wind guidance风导.STL

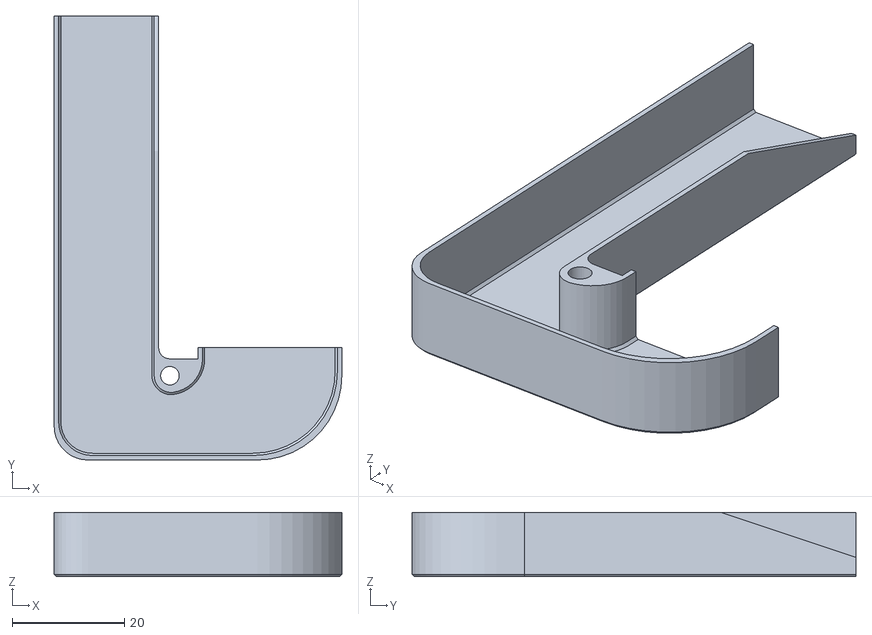
[picture p93: CAD file, 2026-09-19]
SLuban/Related model files机身模型/小鲁班SP外壳shell/SP-Wind guidance风导.STL
51.2 x 79.0 x 11.4
