magicmaker3/magicmaker/SLuban/Related model files机身模型/小鲁班S外壳shell/Wire cover3.42线盖.stl

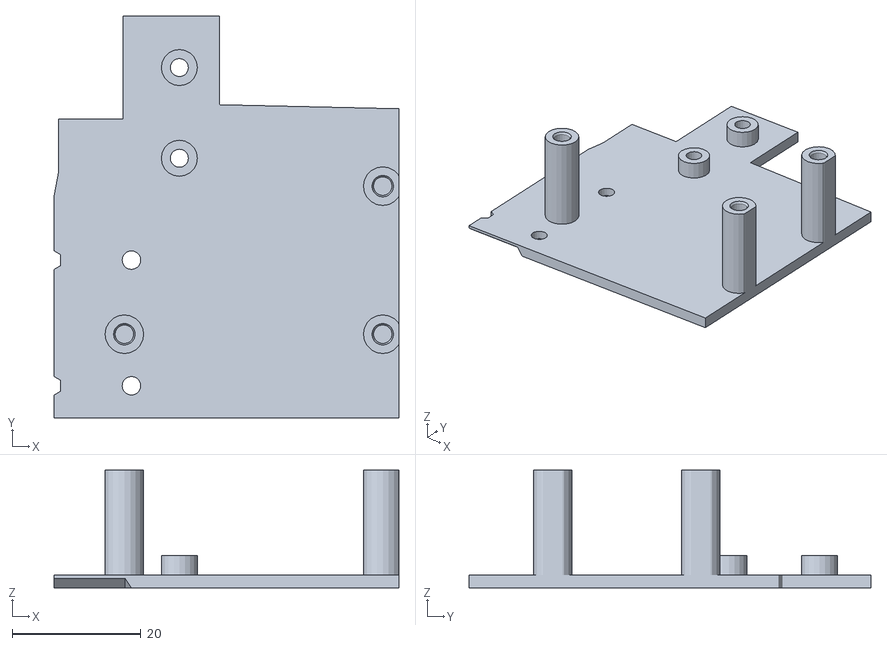
[picture p94: CAD file, 2023-03-16]
SLuban/Related model files机身模型/小鲁班S外壳shell/Wire cover3.42线盖.stl
53.5 x 62.4 x 18.3
