magicmaker3/magicmaker/ESP32主控板JOKER SPARROW/JOKER/3D文件/joker底板A.stl

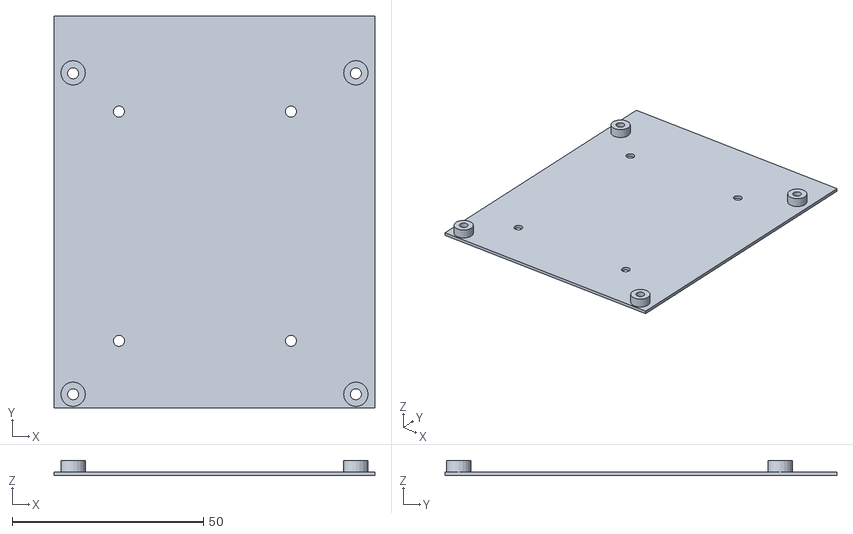
[picture p95: CAD file, 2026-03-28]
ESP32主控板JOKER SPARROW/JOKER/3D文件/joker底板A.stl
84.0 x 102.6 x 4.00
