magicmaker3/magicmaker/ESP32主控板JOKER SPARROW/JOKER/小鲁班X升级JOKER教程/脚后B-1.STL

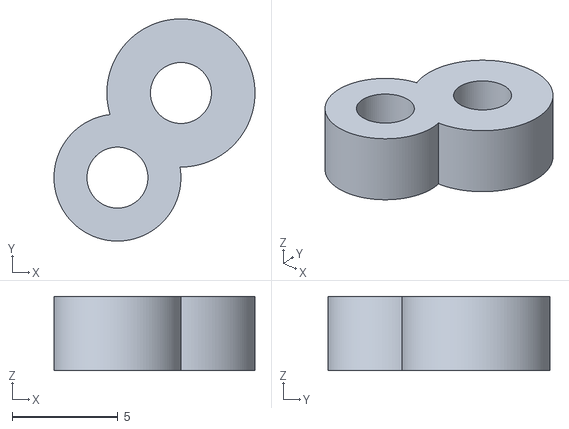
[picture p96: CAD file, 2022-11-03]
ESP32主控板JOKER SPARROW/JOKER/小鲁班X升级JOKER教程/脚后B-1.STL
9.50 x 10.5 x 3.50
