magicmaker3/magicmaker/SLuBan-U/Related model files机身模型/Already equipped已配/喷头架2.3.stl

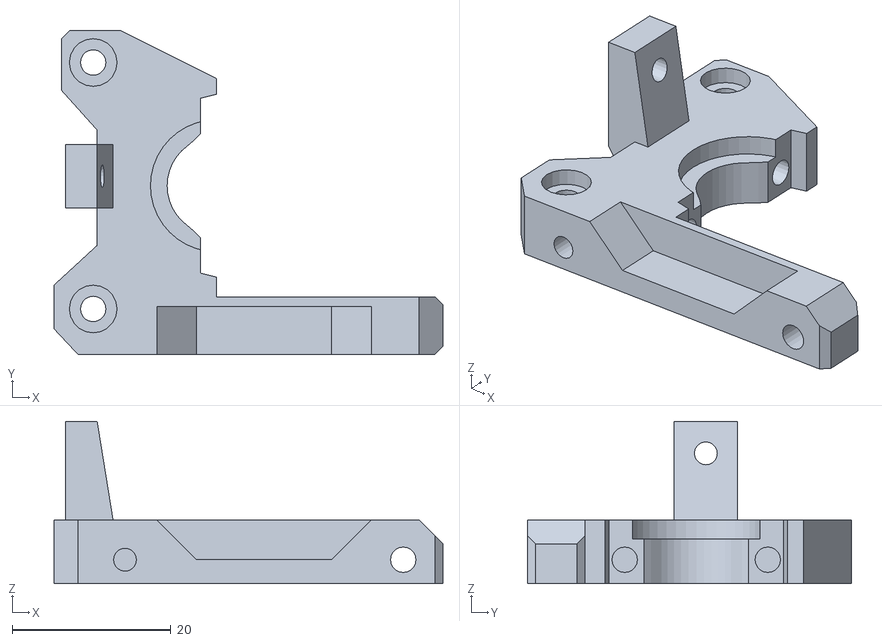
[picture p97: CAD file, 2026-07-19]
SLuBan-U/Related model files机身模型/Already equipped已配/喷头架2.3.stl
48.9 x 40.7 x 20.4
