magicmaker3/magicmaker/SLuBan-U/Related model files机身模型/前档.stl

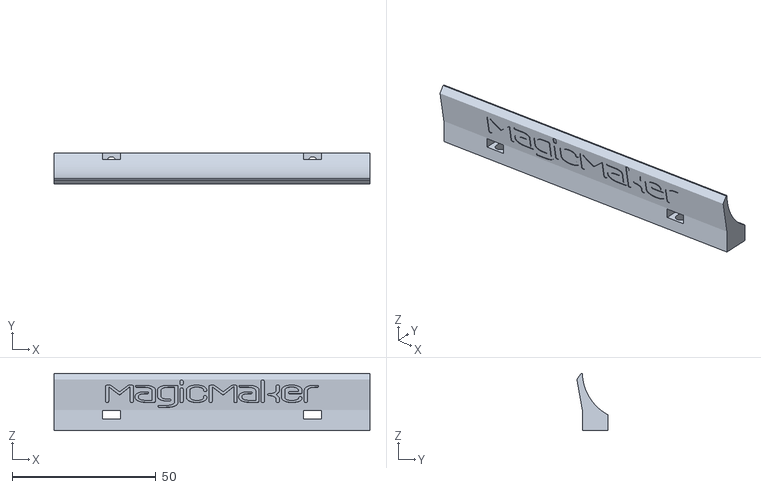
[picture p98: CAD file, 2025-09-22]
SLuBan-U/Related model files机身模型/前档.stl
110.0 x 10.9 x 20.0
