magicmaker3/magicmaker/SLuban/Related model files机身模型/Already equipped已配/Material rack seat1.3料架座.stl

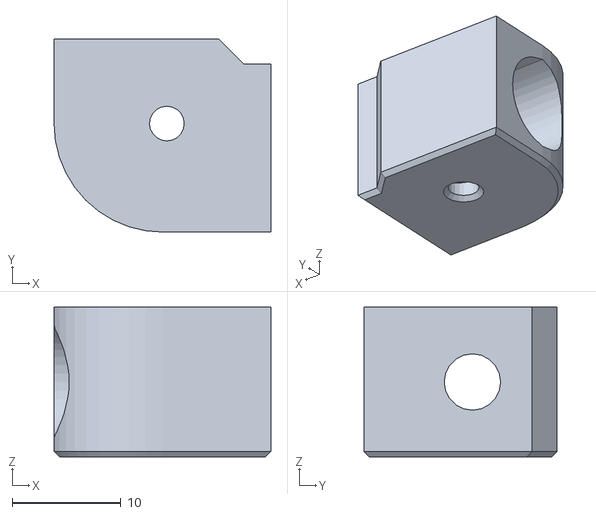
[picture p99: CAD file, 2025-01-07]
SLuban/Related model files机身模型/Already equipped已配/Material rack seat1.3料架座.stl
20.0 x 17.8 x 13.8
