magicmaker3/magicmaker/SLuban/Related model files机身模型/小鲁班SP外壳shell/SP-Side cover边盖.STL

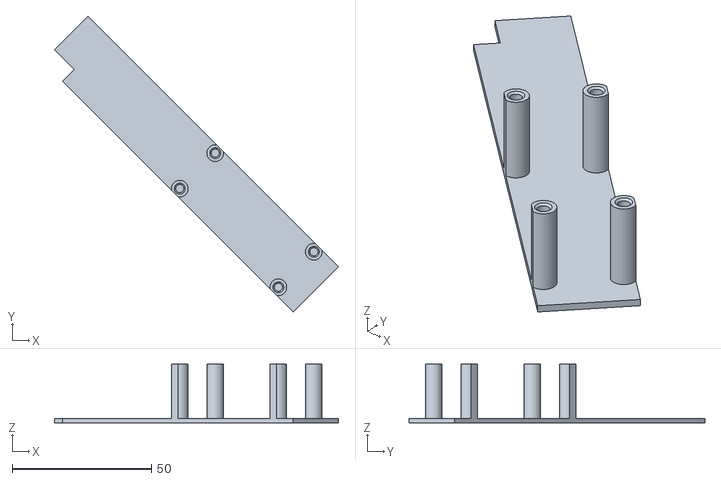
[picture p100: CAD file, 2026-09-19]
SLuban/Related model files机身模型/小鲁班SP外壳shell/SP-Side cover边盖.STL
101.8 x 106.1 x 21.0
