magicmaker3/magicmaker/ESP32主控板JOKER SPARROW/JOKER/小鲁班X升级JOKER教程/脚前B-1.STL

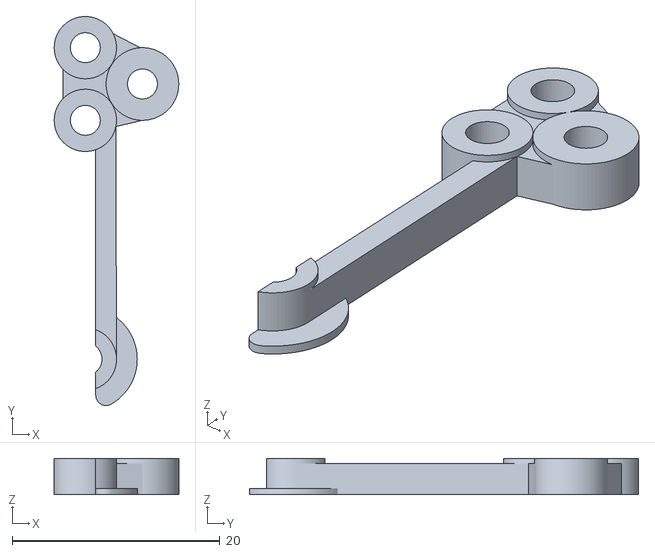
[picture p102: CAD file, 2022-11-03]
ESP32主控板JOKER SPARROW/JOKER/小鲁班X升级JOKER教程/脚前B-1.STL
12.0 x 37.5 x 3.50
