magicmaker3/magicmaker/SLuBan-U/Related model files机身模型/Already equipped已配/喷头扣.stl

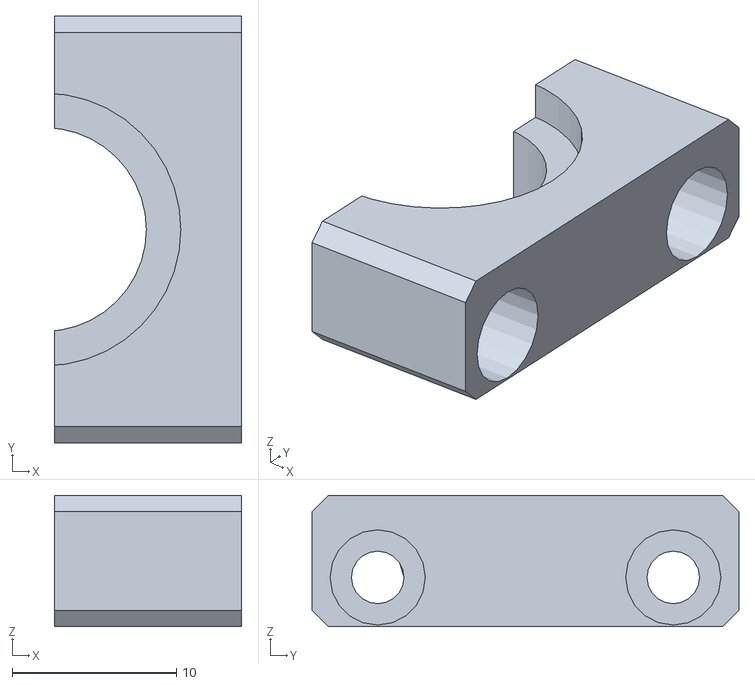
[picture p103: CAD file, 2026-07-19]
SLuBan-U/Related model files机身模型/Already equipped已配/喷头扣.stl
11.4 x 26.0 x 8.00
