magicmaker3/magicmaker/SLuban/Related model files机身模型/Already equipped已配/Fan cover风扇罩2.6.stl

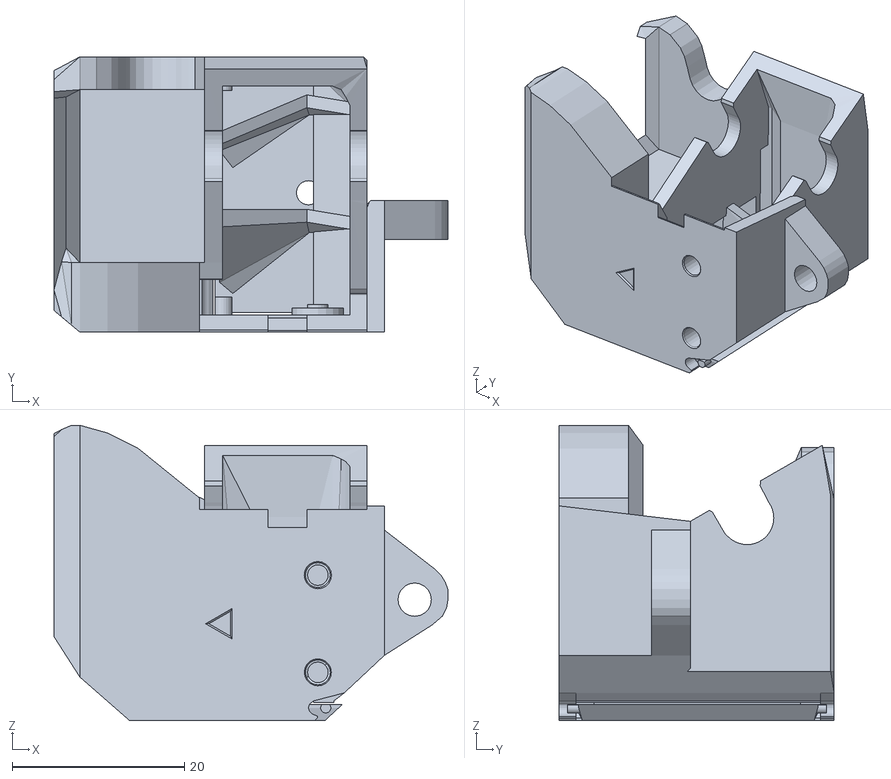
[picture p104: CAD file, 2023-06-21]
SLuban/Related model files机身模型/Already equipped已配/Fan cover风扇罩2.6.stl
45.8 x 32.0 x 34.3
