magicmaker3/magicmaker/SLuban/Related model files机身模型/小鲁班SP外壳shell/SP-Screen cover屏盖.STL

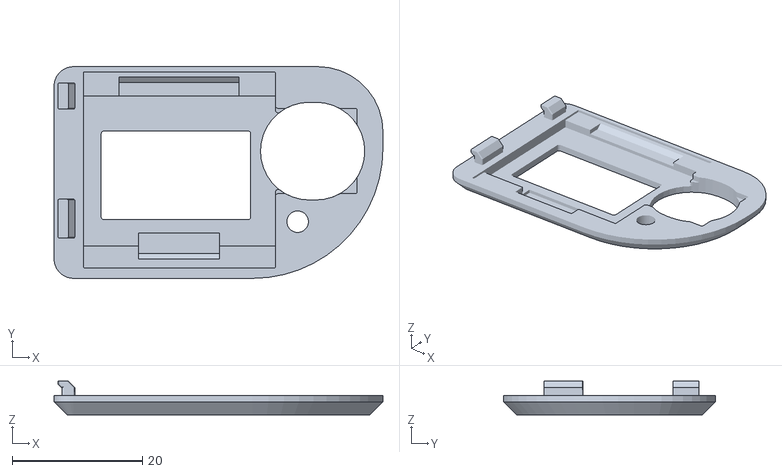
[picture p105: CAD file, 2026-09-19]
SLuban/Related model files机身模型/小鲁班SP外壳shell/SP-Screen cover屏盖.STL
50.5 x 32.5 x 5.21
