magicmaker3/magicmaker/SLuban/Related model files机身模型/小鲁班S外壳shell/Screen cover4.13屏盖（new）.stl

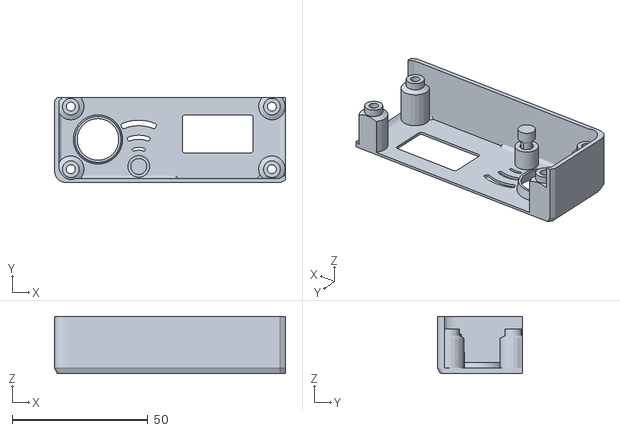
[picture p106: CAD file, 2023-03-16]
SLuban/Related model files机身模型/小鲁班S外壳shell/Screen cover4.13屏盖（new）.stl
85.0 x 31.4 x 21.0
