magicmaker3/magicmaker/ESP32主控板JOKER SPARROW/JOKER/3D文件/joker主板盖.stl

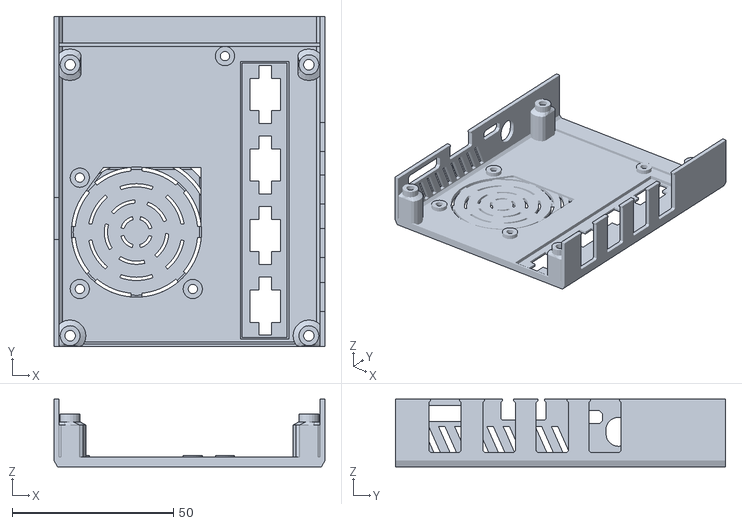
[picture p107: CAD file, 2026-03-28]
ESP32主控板JOKER SPARROW/JOKER/3D文件/joker主板盖.stl
84.0 x 102.4 x 21.0
