magicmaker3/magicmaker/SLuBan-U/Related model files机身模型/Already equipped已配/喉管风扇罩.stl

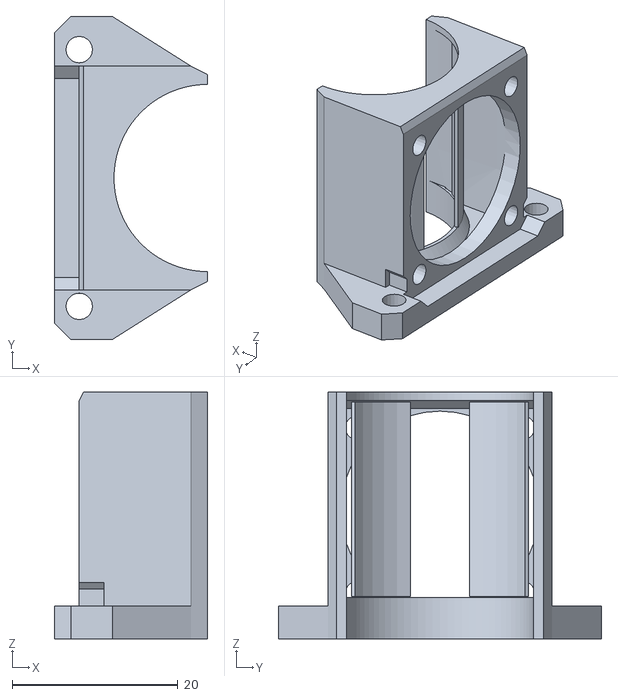
[picture p109: CAD file, 2026-07-19]
SLuBan-U/Related model files机身模型/Already equipped已配/喉管风扇罩.stl
18.5 x 39.0 x 29.8
