magicmaker3/magicmaker/SLuban/Related model files机身模型/Already equipped已配/Fan rack风扇架2.2.stl

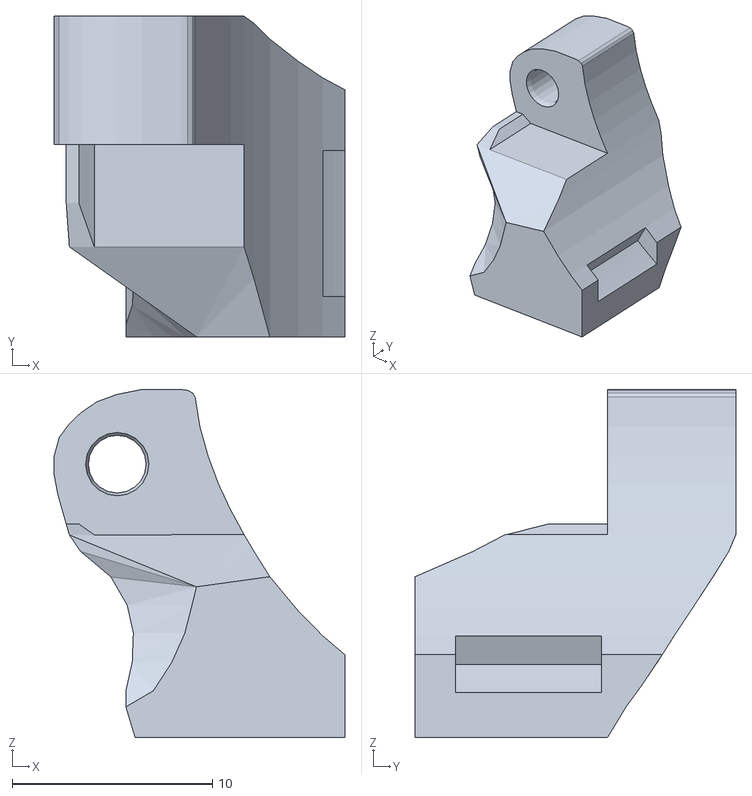
[picture p110: CAD file, 2023-03-16]
SLuban/Related model files机身模型/Already equipped已配/Fan rack风扇架2.2.stl
14.5 x 16.0 x 17.4
