magicmaker3/magicmaker/SLuBan-U/Related model files机身模型/Already equipped已配/Y限位架.stl

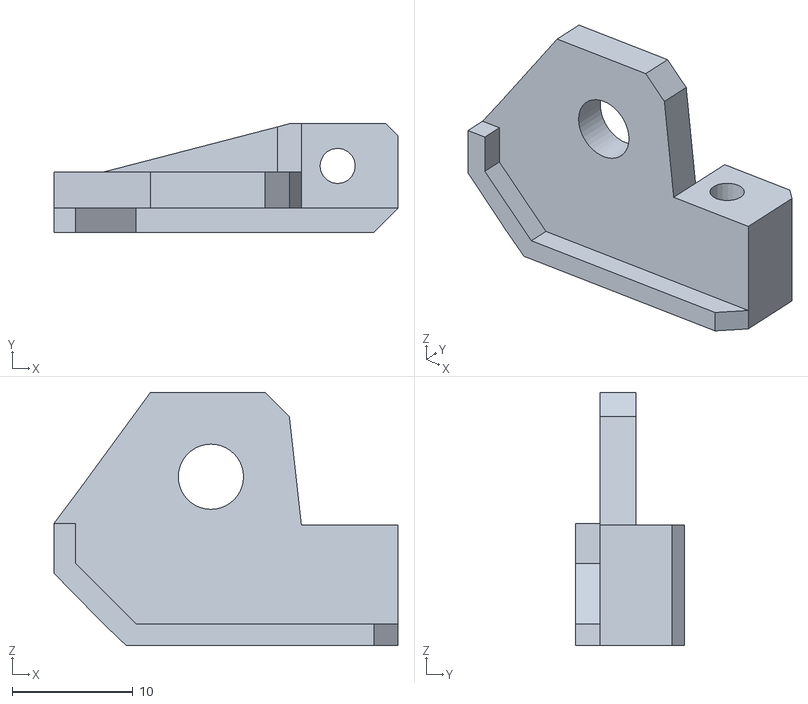
[picture p111: CAD file, 2026-07-19]
SLuBan-U/Related model files机身模型/Already equipped已配/Y限位架.stl
28.5 x 9.00 x 21.0
