magicmaker3/magicmaker/SLuban/Related model files机身模型/Already equipped已配/Material carrier arm1.2料架臂.stl

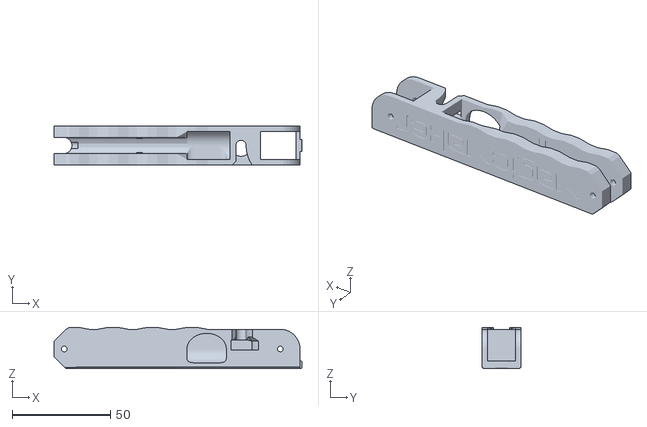
[picture p112: CAD file, 2022-12-29]
SLuban/Related model files机身模型/Already equipped已配/Material carrier arm1.2料架臂.stl
126.0 x 20.0 x 21.0
