magicmaker3/magicmaker/SLuban/Related model files机身模型/小鲁班SP外壳shell/SP-front bumper前杠.STL

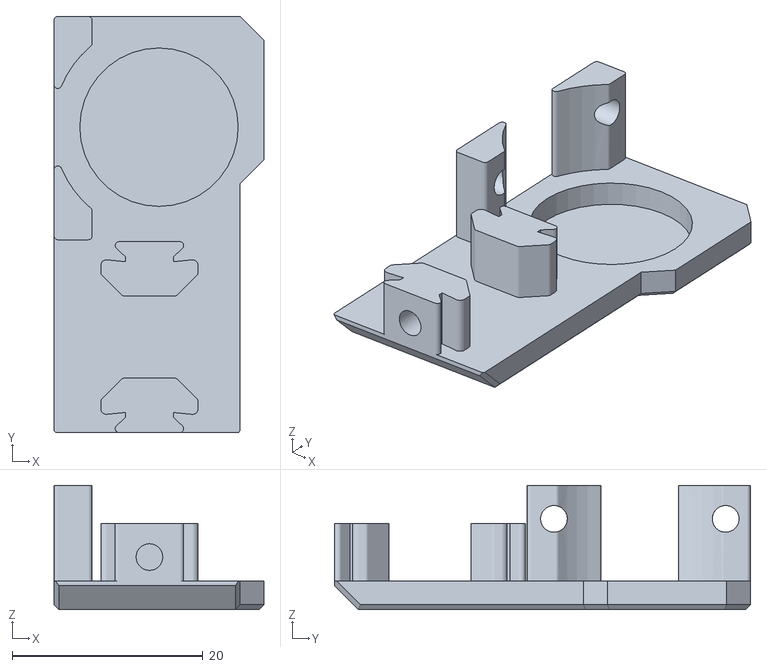
[picture p113: CAD file, 2026-09-19]
SLuban/Related model files机身模型/小鲁班SP外壳shell/SP-front bumper前杠.STL
22.0 x 43.6 x 13.0
