magicmaker3/magicmaker/SLuban/Related model files机身模型/小鲁班S外壳shell/Screen cover3.1屏盖.stl

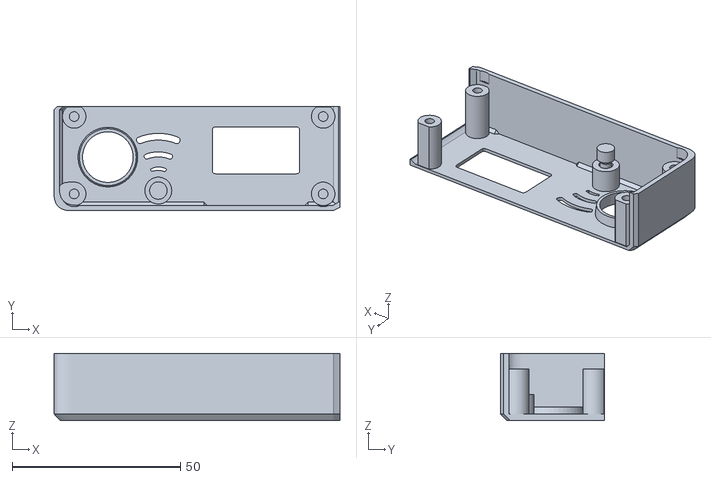
[picture p114: CAD file, 2022-12-29]
SLuban/Related model files机身模型/小鲁班S外壳shell/Screen cover3.1屏盖.stl
85.0 x 31.0 x 20.0
