magicmaker3/magicmaker/SLuBan-U/Related model files机身模型/Already equipped已配/Y导轮架.stl

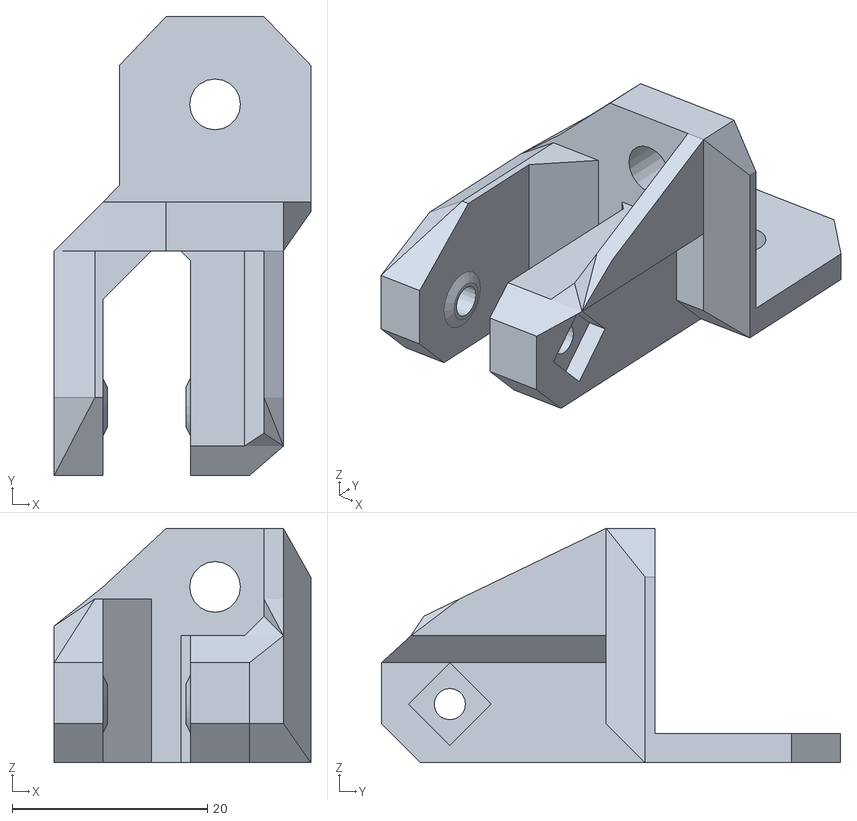
[picture p115: CAD file, 2026-07-19]
SLuBan-U/Related model files机身模型/Already equipped已配/Y导轮架.stl
26.3 x 47.0 x 24.0
