magicmaker3/magicmaker/SLuban/Related model files机身模型/Already equipped已配/Z limitZ限位.STL

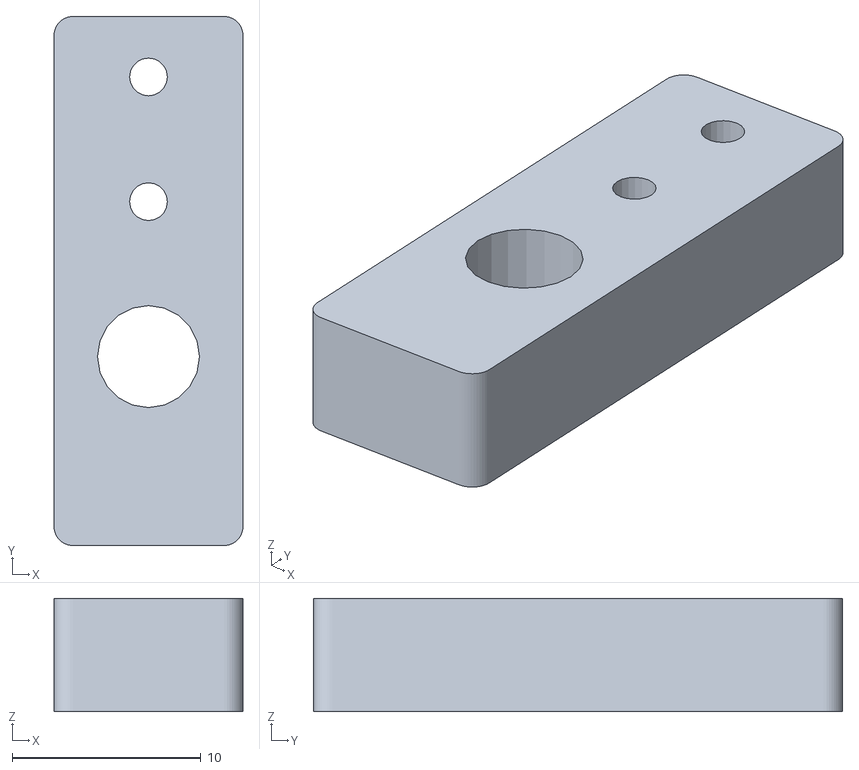
[picture p116: CAD file, 2021-06-03]
SLuban/Related model files机身模型/Already equipped已配/Z limitZ限位.STL
10.0 x 28.0 x 6.00
