magicmaker3/magicmaker/SLuban/Related model files机身模型/小鲁班SP外壳shell/SP-Back cover后盖.STL

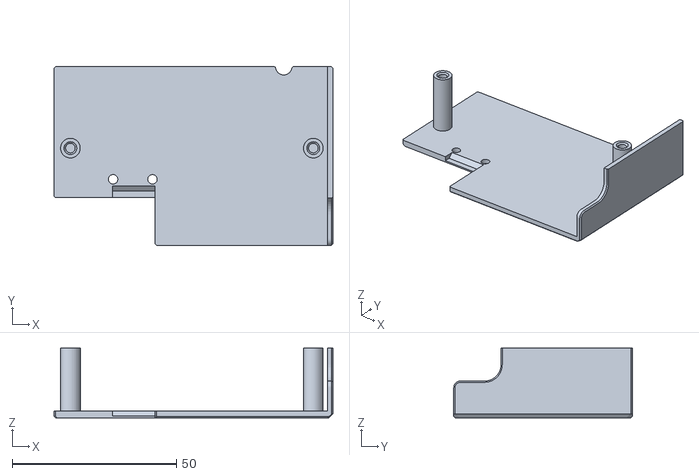
[picture p117: CAD file, 2026-09-19]
SLuban/Related model files机身模型/小鲁班SP外壳shell/SP-Back cover后盖.STL
85.0 x 54.4 x 21.2
