magicmaker3/magicmaker/SLuban/Related model files机身模型/小鲁班S外壳shell/Wire clamp1.2导线卡.stl

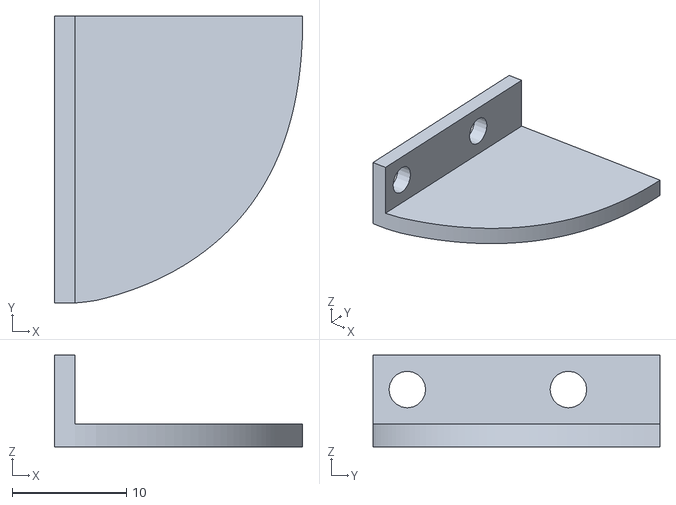
[picture p118: CAD file, 2022-12-29]
SLuban/Related model files机身模型/小鲁班S外壳shell/Wire clamp1.2导线卡.stl
21.7 x 25.1 x 8.00
