magicmaker3/magicmaker/SLuBan-U/Related model files机身模型/Already equipped已配/Z限位架打印件加强版（金属架丢了打这个填充100）.stl

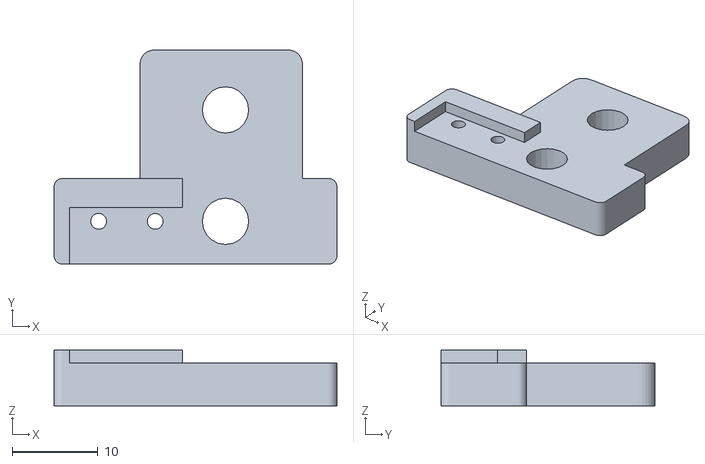
[picture p119: CAD file, 2025-09-22]
SLuBan-U/Related model files机身模型/Already equipped已配/Z限位架打印件加强版（金属架丢了打这个填充100）.stl
33.0 x 25.0 x 6.50
