magicmaker3/magicmaker/SLuban/Related model files机身模型/小鲁班S外壳shell/Air duct3.2风道.stl

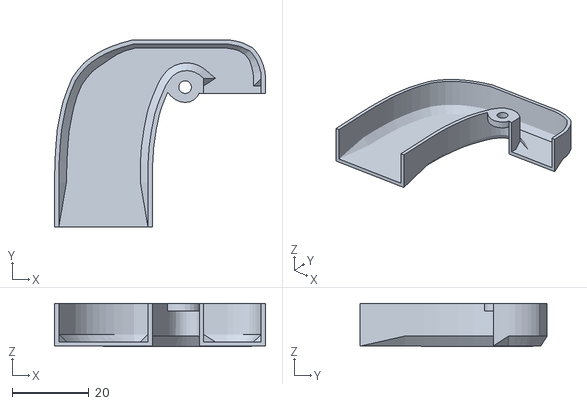
[picture p120: CAD file, 2022-12-29]
SLuban/Related model files机身模型/小鲁班S外壳shell/Air duct3.2风道.stl
54.8 x 48.7 x 11.2
