magicmaker3/magicmaker/SLuban/Related model files机身模型/小鲁班S外壳shell/Switch rack1.1开关架.stl

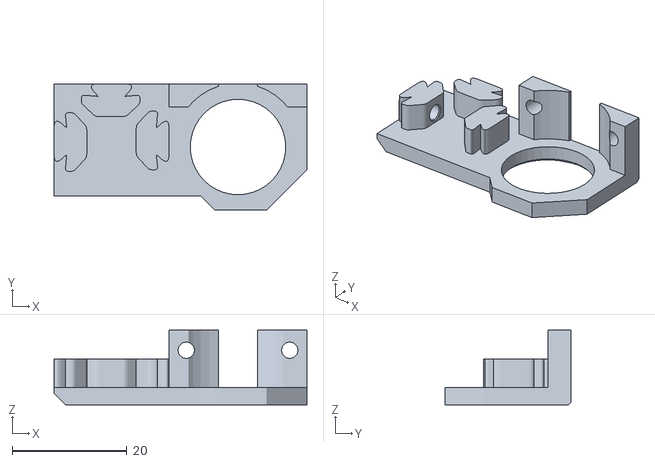
[picture p121: CAD file, 2022-12-29]
SLuban/Related model files机身模型/小鲁班S外壳shell/Switch rack1.1开关架.stl
44.0 x 22.0 x 13.0
