magicmaker3/magicmaker/(list of files, cad)

Other CAD files:
SLuban/Related model files机身模型/小鲁班S外壳shell/Main board cover4.13主板盖（new）.stl
SLuban/Slicing software切片软件/CURA（substitute替补/Miniluban cura4.41 configuration file1.4.3mf
SLuban/Slicing software切片软件/owl.stl
ESP32主控板JOKER SPARROW/JOKER/3D文件/小鲁班S专用打印件/小鲁班S主板盖3.6（下装螺丝版）.stl
SLuban/Slicing software切片软件/CURA（substitute替补/小鲁班cura5.2配置文件.3mf
SLuban/Related model files机身模型/小鲁班S外壳shell/Side cover3.62边盖.stl
SLuban/Old version materials X旧版资料/Related model files/Already equipped已配/Fan cover2.3风扇罩.stl
SLuban/Old version materials X旧版资料/Related model files/Already equipped已配/Fan rack2.1风扇架.STL
SLuban/Old version materials X旧版资料/Related model files/Already equipped已配/Material rack seat1.2料架座.stl
SLuban/Old version materials X旧版资料/Related model files/Already equipped已配/YZ limit.STL
SLuban/Old version materials X旧版资料/Related model files/Main board cover2.2.STL
SLuban/Old version materials X旧版资料/Related model files/Screen cover2.1.STL
SLuban/Old version materials X旧版资料/Related model files/Wire cover1.4.STL
