magicmaker3/magicmaker/SLuban/Slicing software切片软件/CURA（substitute替补/Slicing software video tutorial link.txt

https://www.bilibili.com/video/BV17K4y1t77R/
