magicmaker3/magicmaker/SLuban/Installation tutorial小鲁班SL教程4.03.pdf

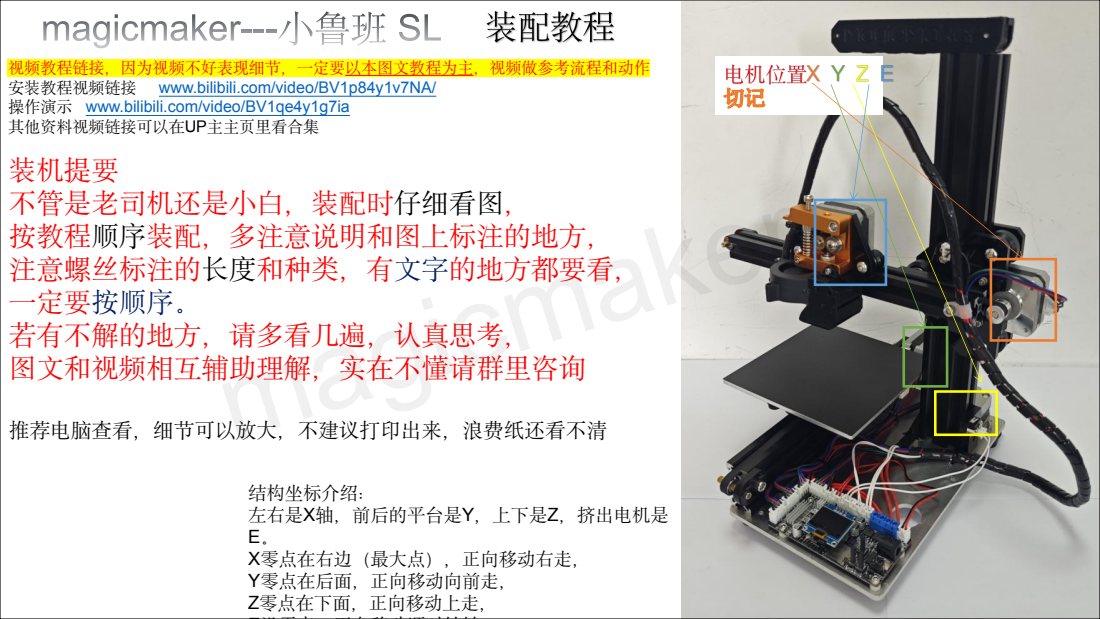
[picture p141: page 1]
议打印出来，浪费纸还看不清; gicmaker

视频教程链接，因为视频不好表现细节，一定要以本图文教程为主，视频做参考流程和动作
安装教程视频链接 www.bilibili.com/video/BV1p84y1v7NA/
操作演示 www.bilibili.com/video/BV1qe4y1g7ia
其他资料视频链接可以在UP主主页里看合集
装机提要
不管是老司机还是小白，装配时仔细看图，
按教程顺序装配，多注意说明和图上标注的地方，
注意螺丝标注的长度和种类，有文字的地方都要看，
一定要按顺序。
推荐电脑查看，细节可以m放大，不建
若有不解的地方，请多看几遍，认真思考，
图文和视频相互辅助理解，实在不懂请群里咨询

结构坐标介绍：
左右是X轴，前后的平台是Y，上下是Z，挤出电机是
X零点在右边（最大点），正向移动右走，
Y零点在后面，正向移动向前走，
Z零点在下面，正向移动上走，
E没零点，正向移动顺时针转

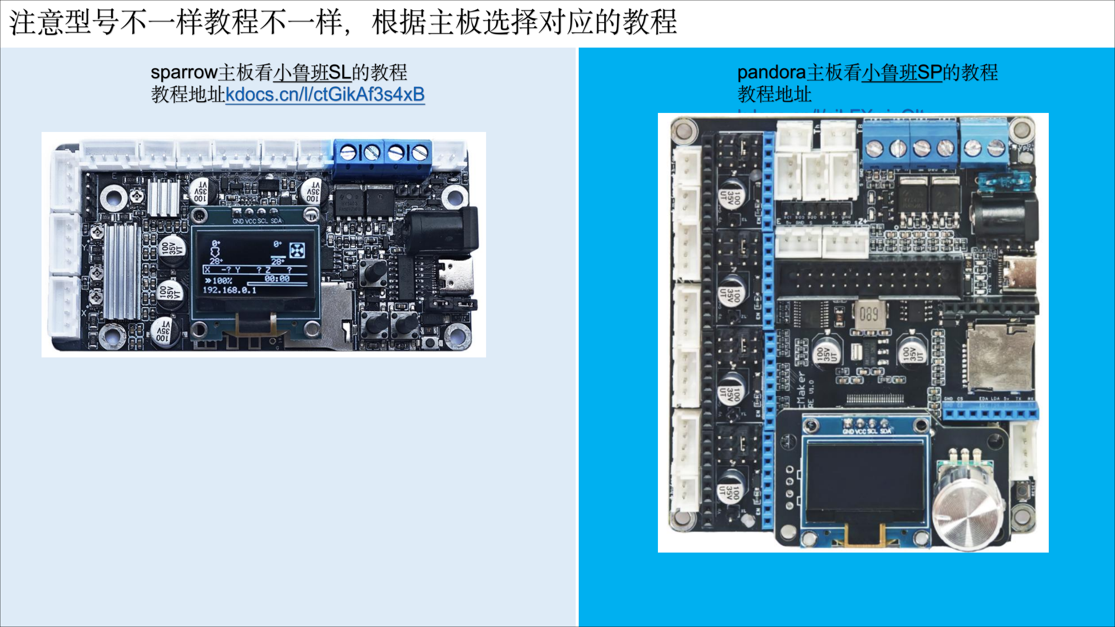
[picture p142: page 2]

## 绿色背景页金属版专用

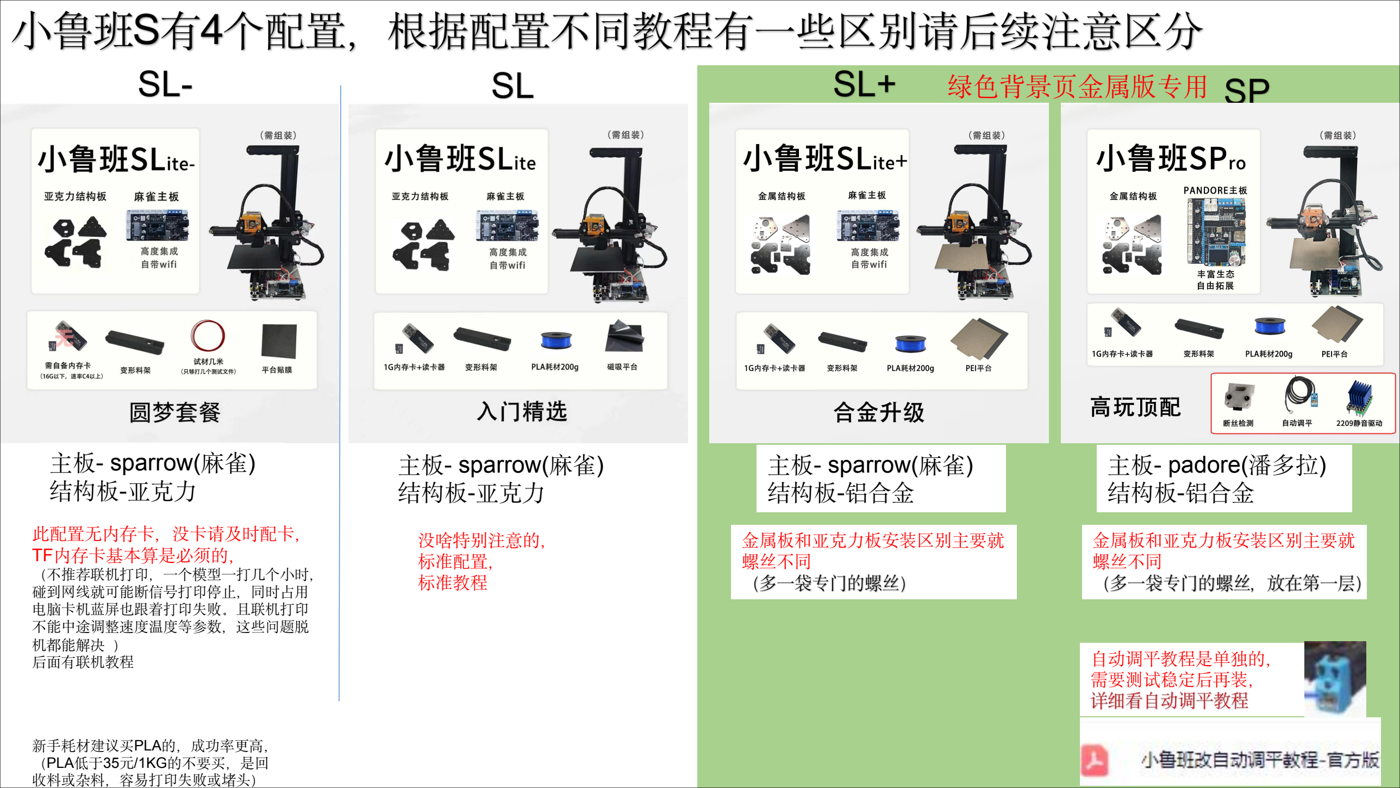
[picture p143: page 3]

此配置无内存卡，没卡请及时配卡，
TF内存卡基本算是必须的，
（不推荐联机打印，一个模型一打几个小时，
碰到网线就可能断信号打印停止，同时占用
电脑卡机蓝屏也跟着打印失败。且联机打印
不能中途调整速度温度等参数，这些问题脱
机都能解决 ）
后面有联机教程

金属板和亚克力板安装区别主要就
螺丝不同

没啥特别注意的，
标准配置，
标准教程

新手耗材建议买PLA的，成功率更高，
（PLA低于35元/1KG的不要买，是回
收料或杂料，容易打印失败或堵头）

金属板和亚克力板安装区别主要就
螺丝不同

自动调平教程是单独的，

需要测试稳定后再装， 主板- sparrow(麻雀)
结构板-亚克力

### 主板- sparrow(麻雀)

结构板-亚克力

### 主板- sparrow(麻雀)

结构板-铝合金

### 主板- padore(潘多拉)

结构板-铝合金

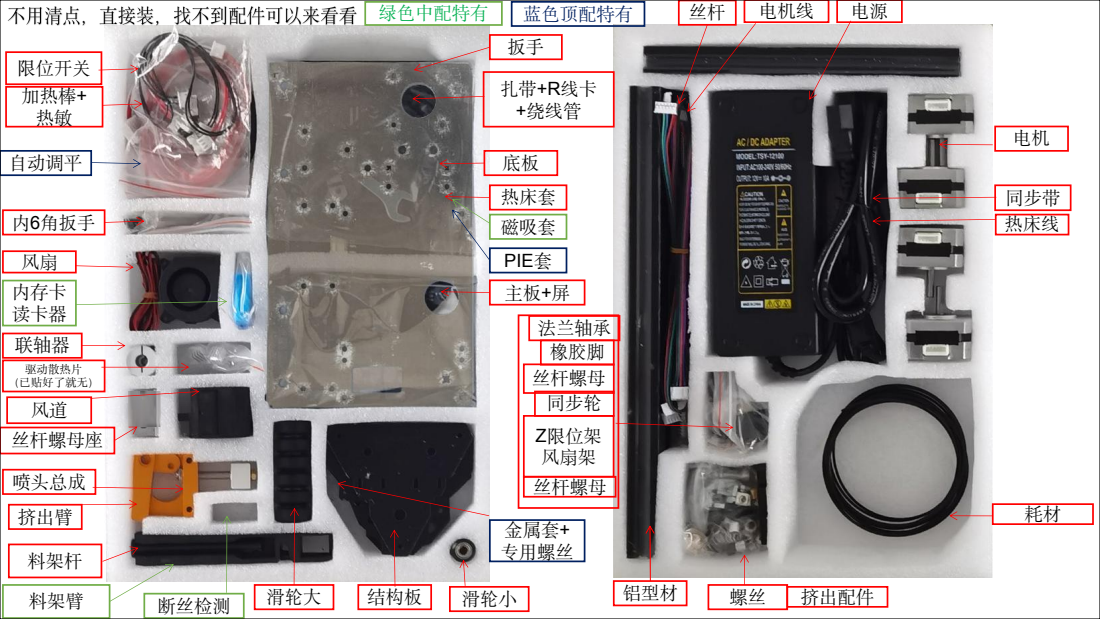
[picture p144: page 4]
扎带+R线卡 +绕线管 挤出臂; 挤出配件 丝杆螺母 橡胶脚 内存卡 读卡器; 丝杆螺母 内6角扳手 喷头总成 风扇; 主板+屏 底板热床套 滑轮大; 结构板; 滑轮小; 同步轮 联轴器; 法兰轴承 风道; 铝型材 丝杆 加热棒+ 热敏; 螺丝电机线; 电源 限位开关; 同步带 热床线 扳手 料架臂; Z限位架 风扇架; 电机 丝杆螺母座; 耗材 料架杆; 断丝检测; 磁吸套 PIE套 自动调平; 绿色中配特有; 蓝色顶配特有 金属套+ 专用螺丝 驱动散热片 （已贴好了就无）

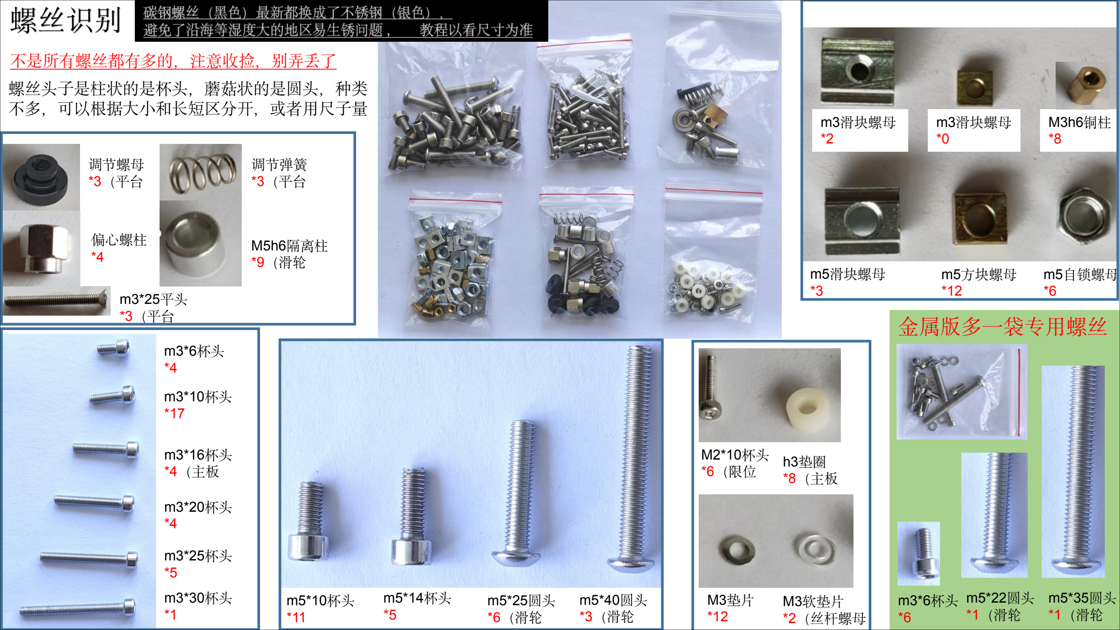
[picture p145: page 5]

螺丝头子是柱状的是杯头，蘑菇状的是圆头，种类
不多，可以根据大小和长短区分开，或者用尺子量

不是所有螺丝都有多的，注意收捡，别弄丢了

M2*10杯头
*6（限位

h3垫圈
*8（主板

M3垫片
*12

M3软垫片
*2（丝杆螺母

M3h6铜柱
*8

M5h6隔离柱
*9（滑轮

调节螺母
*3（平台

调节弹簧
*3（平台

m3*10杯头
*17

m3*20杯头
*4

m3*16杯头
*4（主板

m3*30杯头
*1

m3*25杯头
*5

m3*25平头
*3（平台

m3滑块螺母
*2

m5滑块螺母
*3

m5方块螺母
*12

m5自锁螺母
*6

m3滑块螺母
*0

m5*10杯头
*11

m5*14杯头
*5

m5*25圆头
*6（滑轮

m5*40圆头
*3（滑轮

偏心螺柱
*4

m3*6杯头
*4

m5*22圆头
*1（滑轮

m5*35圆头
*1（滑轮

m3*6杯头
*6

## 金属版多一袋专用螺丝

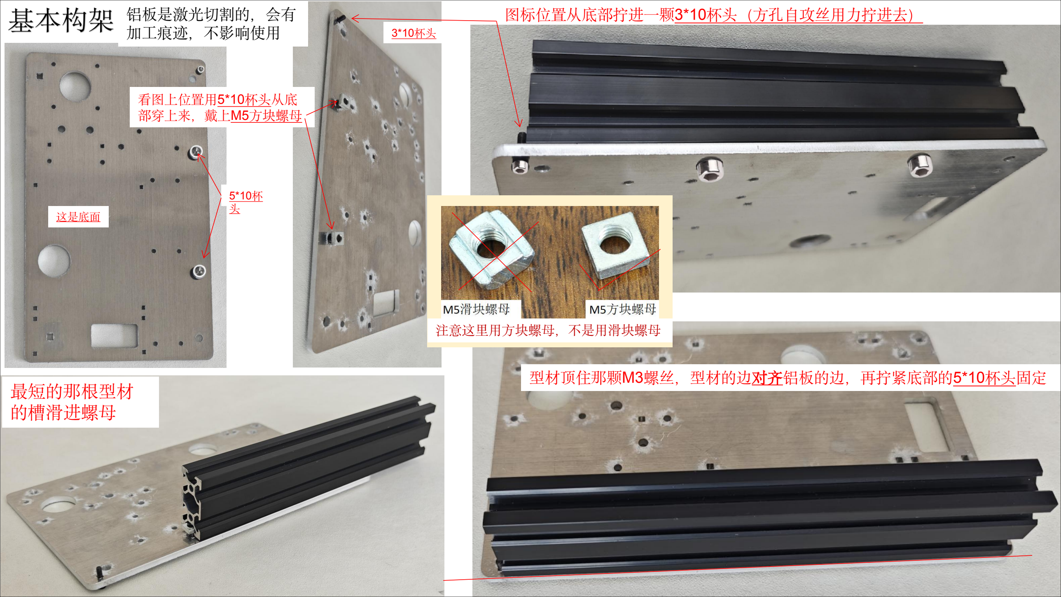
[picture p146: page 6]

铝板是激光切割的，会有
加工痕迹，不影响使用

看图上位置用5*10杯头从底
部穿上来，戴上M5方块螺母

最短的那根型材
的槽滑进螺母

图标位置从底部拧进一颗3*10杯头（方孔自攻丝用力拧进去）

型材顶住那颗M3螺丝，型材的边对齐铝板的边，再拧紧底部的5*10杯头固定

5*10杯
头

3*10杯头

这是底面

注意这里用方块螺母，不是用滑块螺母

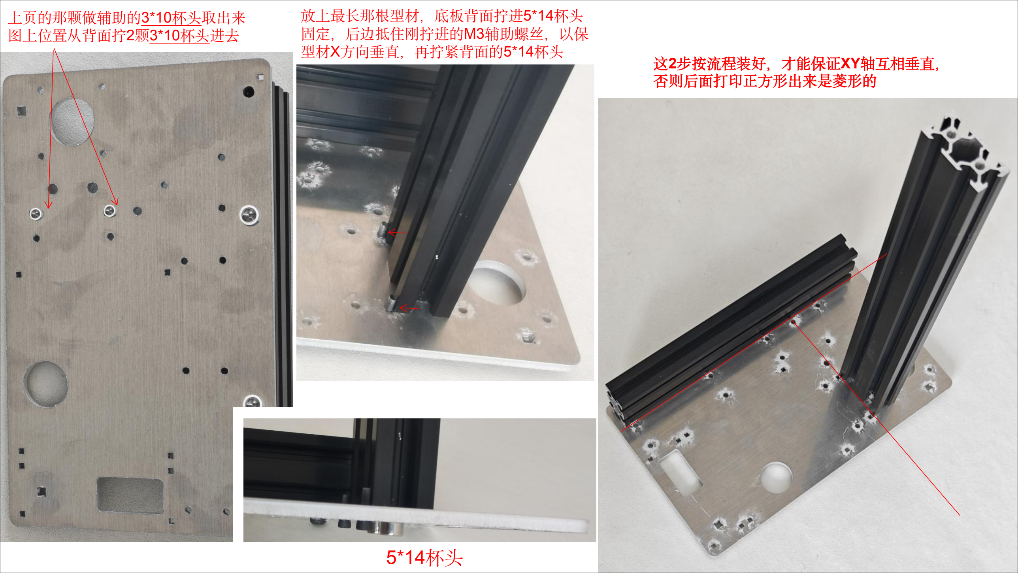
[picture p147: page 7]

上页的那颗做辅助的3*10杯头取出来
图上位置从背面拧2颗3*10杯头进去

放上最长那根型材，底板背面拧进5*14杯头
固定，后边抵住刚拧进的M3辅助螺丝，以保
型材X方向垂直，再拧紧背面的5*14杯头
这2步按流程装好，才能保证XY轴互相垂直，
否则后面打印正方形出来是菱形的

5*14杯头

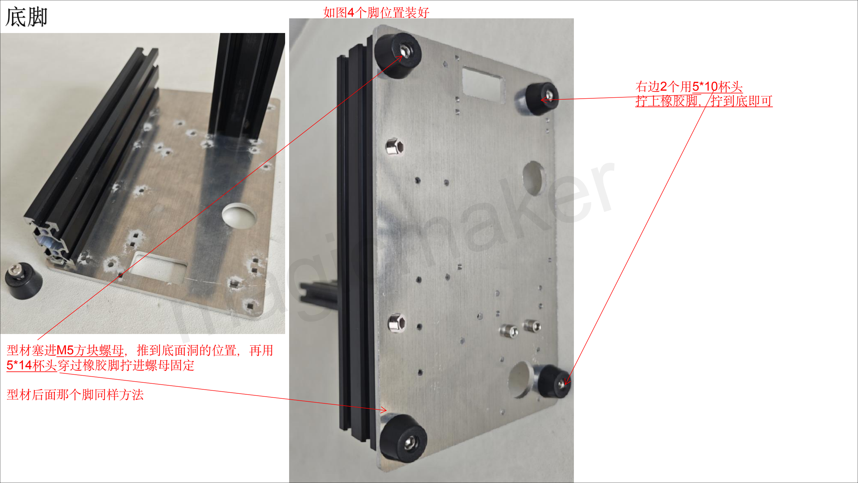
[picture p148: page 8]

型材塞进M5方块螺母，推到底面洞的位置，再用
5*14杯头穿过橡胶脚拧进螺母固定

型材后面那个脚同样方法

如图4个脚位置装好

右边2个用5*10杯头
拧上橡胶脚，拧到底即可

# magicmaker

## XYZ的三组限位线先如图插限位开

关，

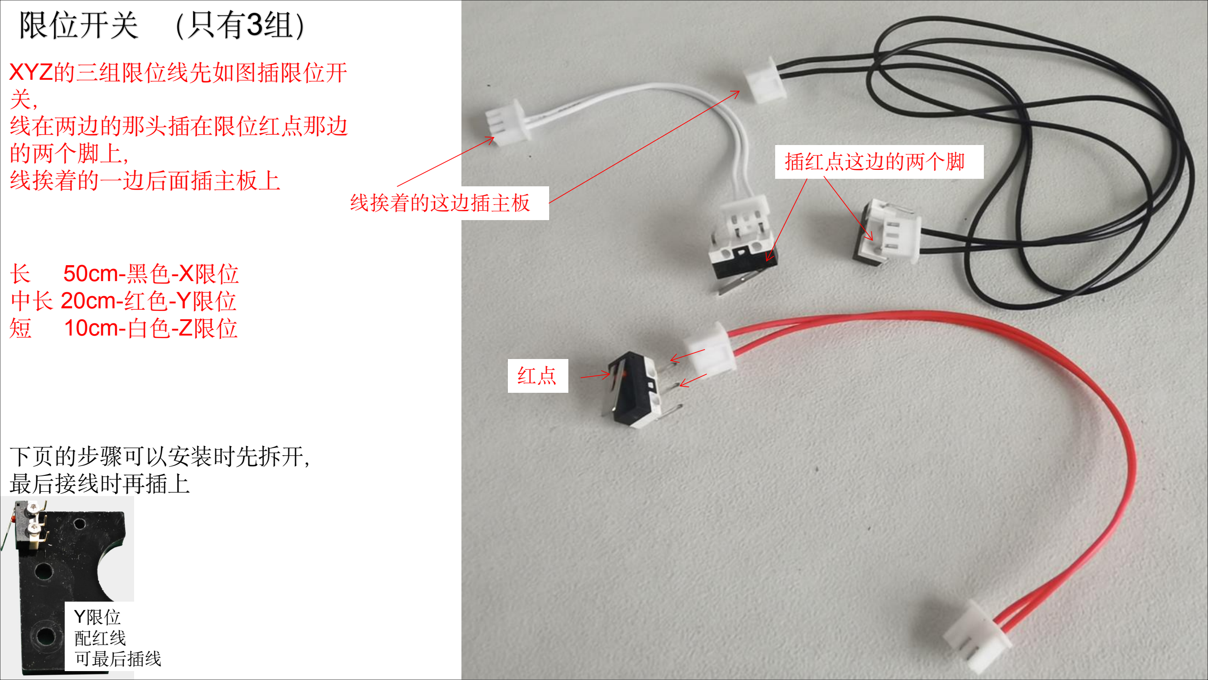
[picture p149: page 9]

## 线在两边的那头插在限位红点那边 的两个脚上， 线挨着的一边后面插主板上

线挨着的这边插主板

插红点这边的两个脚

红点

## 下页的步骤可以安装时先拆开， 最后接线时再插上

## 长 50cm-黑色-X限位 中长 20cm-红色-Y限位 短 10cm-白色-Z限位

Y限位
配红线
可最后插线

## 左边型材后面塞2颗M5方块螺母

## 建议先装好

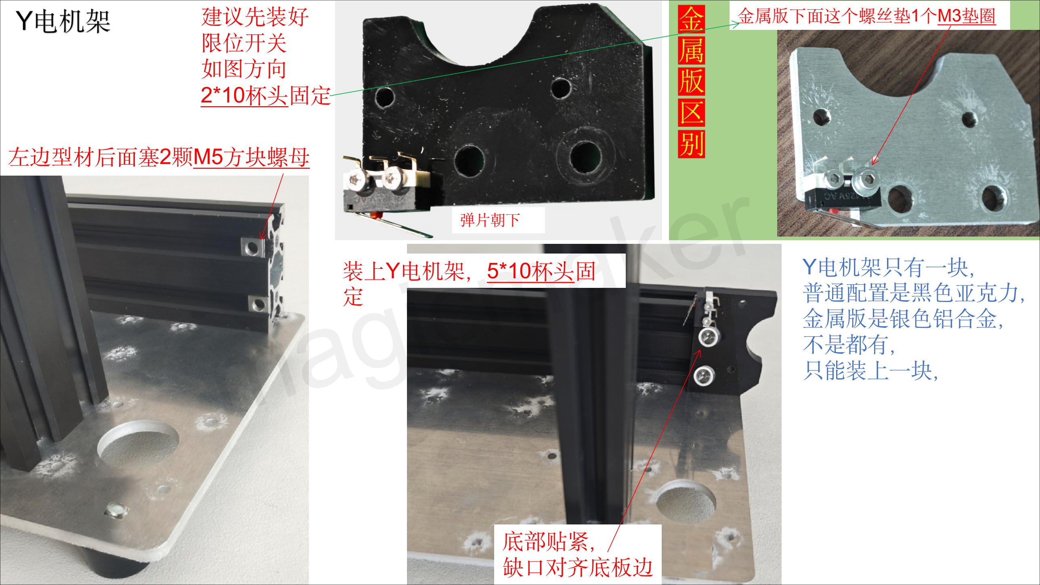
[picture p150: page 10]

## 装上Y电机架，5*10杯头固

定

# magicmaker

## 底部贴紧， 缺口对齐底板边

## 限位开关 如图方向

## 2*10杯头固定

金属版下面这个螺丝垫1个M3垫圈

弹片朝下

## Y电机架只有一块， 普通配置是黑色亚克力， 金属版是银色铝合金， 不是都有， 只能装上一块，

## 底部3*6杯头固定，不要太过用力拧

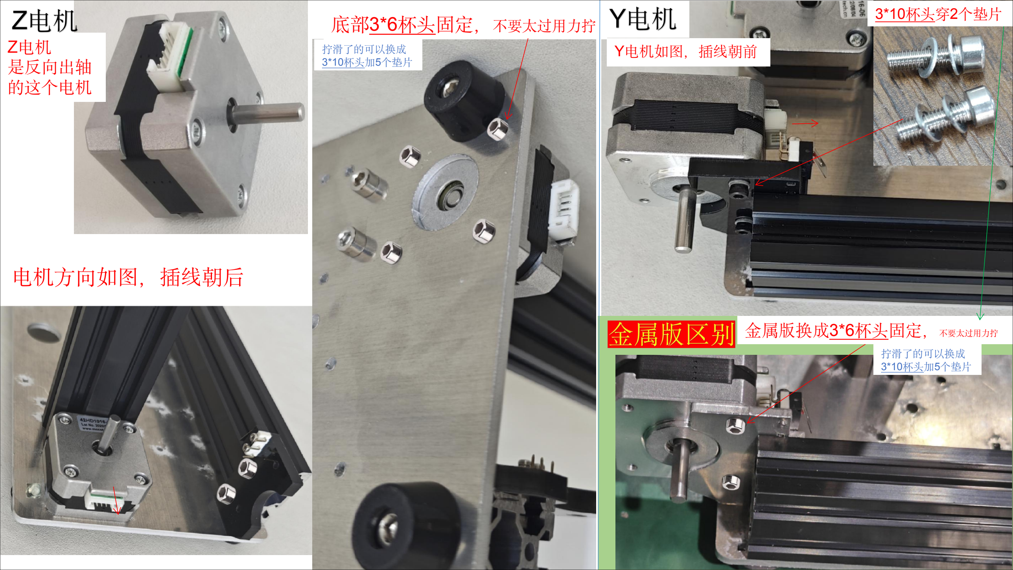
[picture p151: page 11]

## 电机方向如图，插线朝后

Z电机 | Y电机如图，插线朝前
是反向出轴
的这个电机

拧滑了的可以换成
3*10杯头加5个垫片

拧滑了的可以换成
3*10杯头加5个垫片

金属版换成3*6杯头固定，不要太过用力拧

3*10杯头穿2个垫片

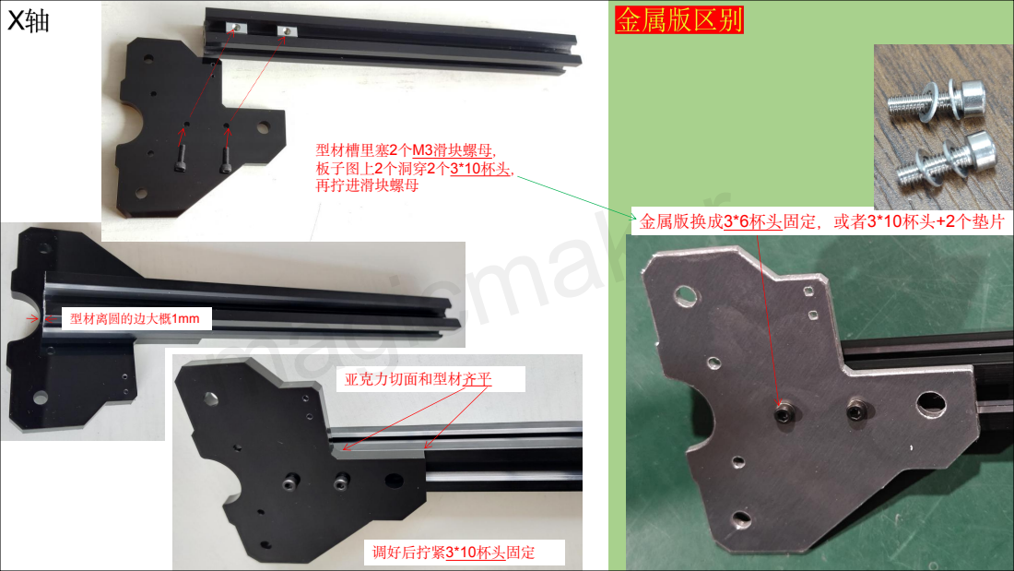
[picture p152: page 12]
型材槽里塞2个M3滑块螺母， 板子图上2个洞穿2个3*10杯头， 再拧进滑块螺母; 型材离圆的边大概1mm; 亚克力切面和型材齐平; 调好后拧紧3*10杯头固定; magicmaker; 金属版换成3*6杯头固定，或者3*10杯头+2个垫片

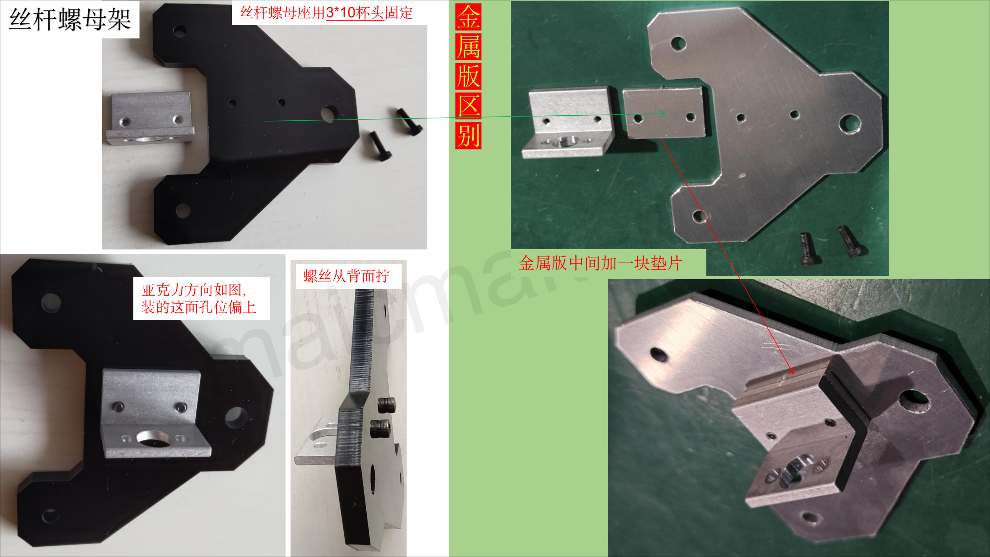
[picture p153: page 13]

丝杆螺母座用3*10杯头固定

亚克力方向如图，
装的这面孔位偏上

螺丝从背面拧

# maicma

金属k版中间e加一块r垫片

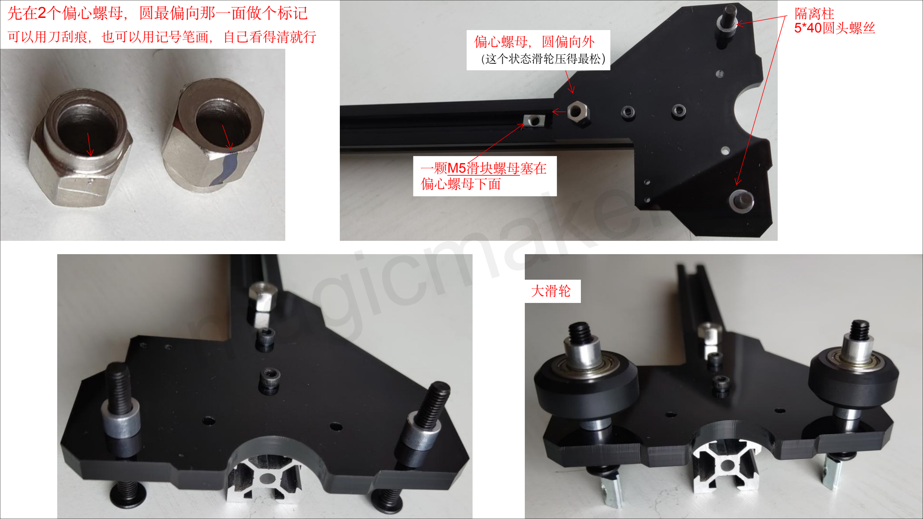
[picture p154: page 14]

先在2个偏心螺母，圆最偏向那一面做个标记

偏心螺母，圆偏向外
（这个状态滑轮压得最松）

可以用刀刮痕，也可以用记号笔画，自己看得清就行

5*40圆头螺丝

一颗M5滑块螺母塞在
偏心螺母下面

隔离柱

# magicmaker

大滑轮

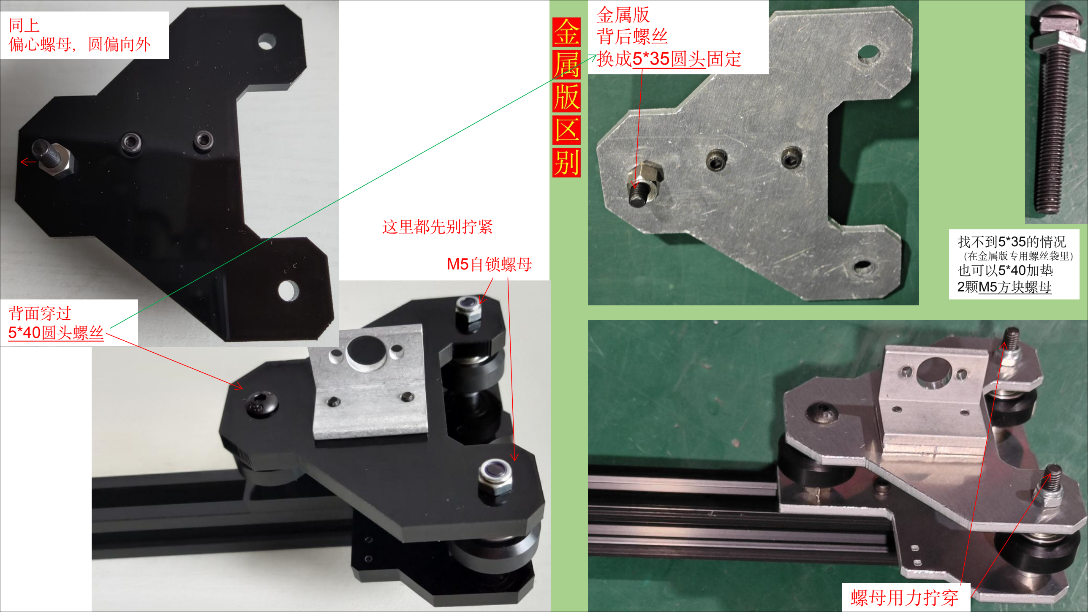
[picture p155: page 15]

M5自锁螺母

同上
偏心螺母，圆偏向外

背面穿过
5*40圆头螺丝

这里都先别拧紧

金属版
背后螺丝
换成5*35圆头固定

找不到5*35的情况
（在金属版专用螺丝袋里）
也可以5*40加垫
2颗M5方块螺母

螺母用力拧穿

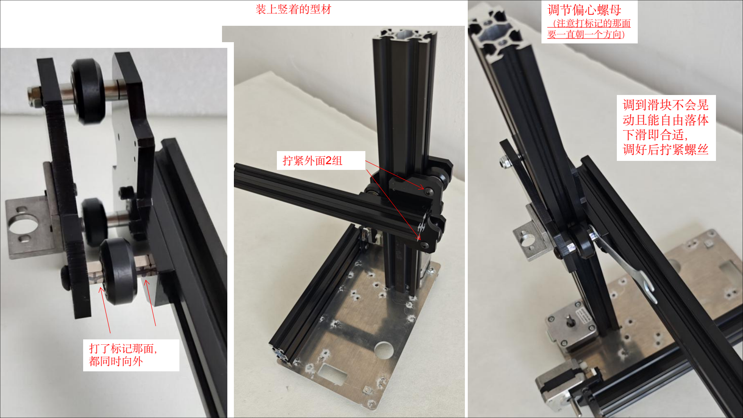
[picture p156: page 16]

装上竖着的型材

拧紧外面2组

调节偏心螺母
（注意打标记的那面
要一直朝一个方向）

调到滑块不会晃
动且能自由落体
下滑即合适，
调好后拧紧螺丝

打了标记那面，
都同时向外

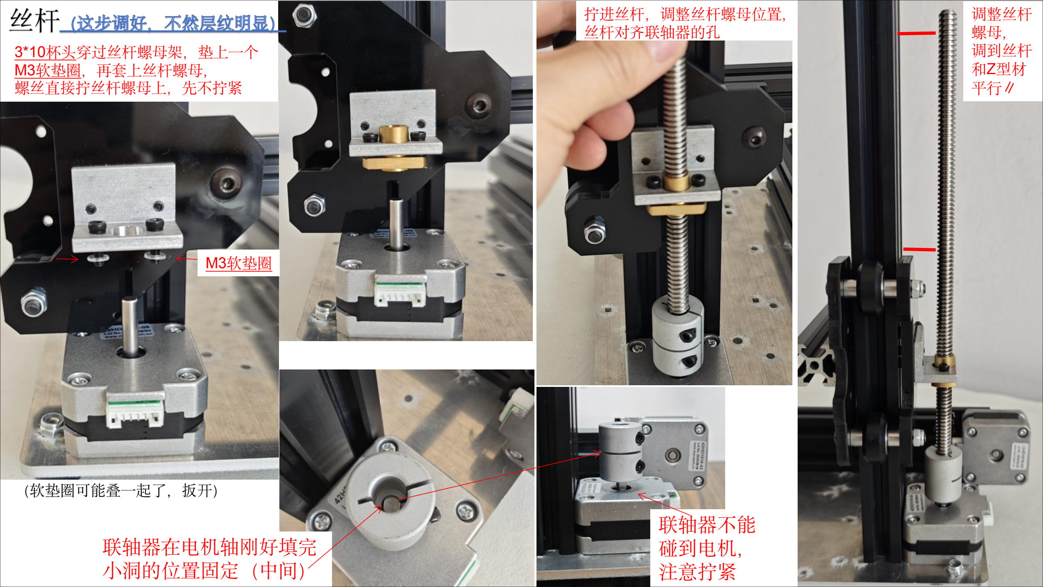
[picture p157: page 17]

3*10杯头穿过丝杆螺母架，垫上一个
M3软垫圈，再套上丝杆螺母，
螺丝直接拧丝杆螺母上，先不拧紧

M3软垫圈

调整丝杆
螺母，
调到丝杆
和Z型材
平行∥

（软垫圈可能叠一起了，扳开）

## 联轴器在电机轴刚好填完 小洞的位置固定（中间）

拧进丝杆，调整丝杆螺母位置，
丝杆对齐联轴器的孔

## 联轴器不能 碰到电机， 注意拧紧

平行∥

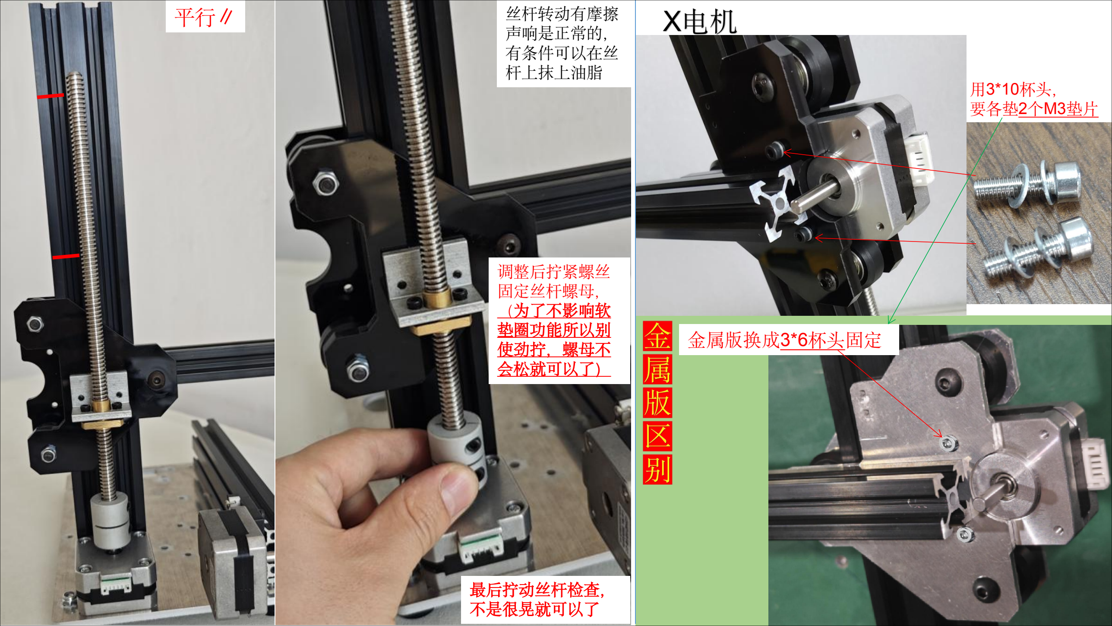
[picture p158: page 18]

调整后拧紧螺丝
固定丝杆螺母，
（为了不影响软
垫圈功能所以别
使劲拧，螺母不
会松就可以了）

用3*10杯头，
要各垫2个M3垫片

丝杆转动有摩擦
声响是正常的，
有条件可以在丝
杆上抹上油脂

金属版换成3*6杯头固定

最后拧动丝杆检查，
不是很晃就可以了

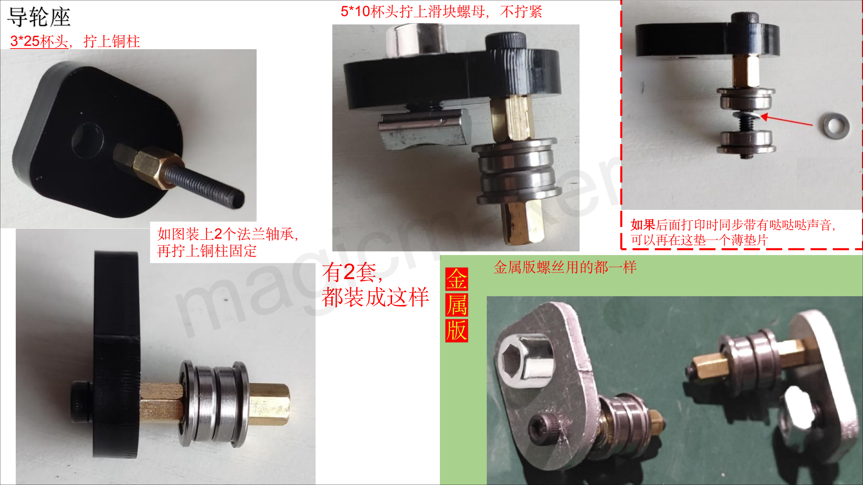
[picture p159: page 19]

3*25杯头，拧上铜柱

如图装上2个法兰轴承，
再拧上铜柱固定

5*10杯头拧上滑块螺母，不拧紧

有2套，

# 都装成这样

如果后面打印时同步带有哒哒哒声音，
可以再在这垫一个薄垫片

# magicmaker

金属版螺丝用的都一样

5*25圆头，

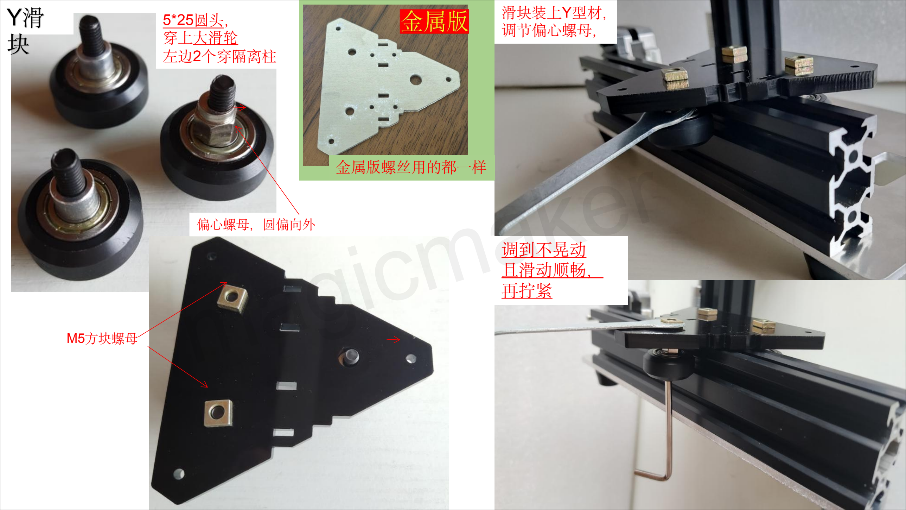
[picture p160: page 20]

穿上大滑轮
左边2个穿隔离柱

滑块装上Y型材，
调节偏心螺母，

偏心螺母，圆偏向外

M5方块螺母

## 调到不晃动 且滑动顺畅，

# 再拧紧 magicmaker

金属版螺丝用的都一样

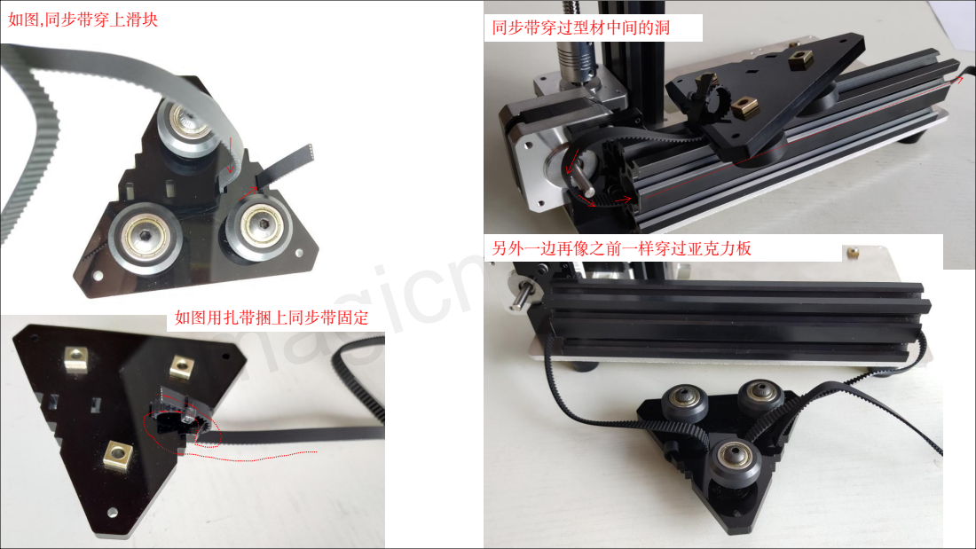
[picture p161: page 21]
如图,同步带穿上滑块; magicmaker; 如图用扎带捆上同步带固定; 同步带穿过型材中间的洞; 另外一边再像之前一样穿过亚克力板

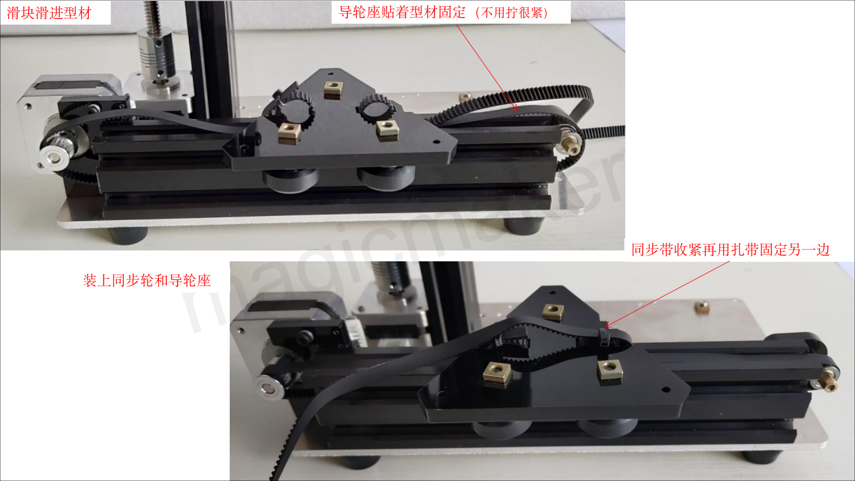
[picture p162: page 22]

同步带收紧再用扎带固定另一边

# magicmaker

滑块滑进型材

装上同步轮和导轮座

导轮座贴着型材固定（不用拧很紧）

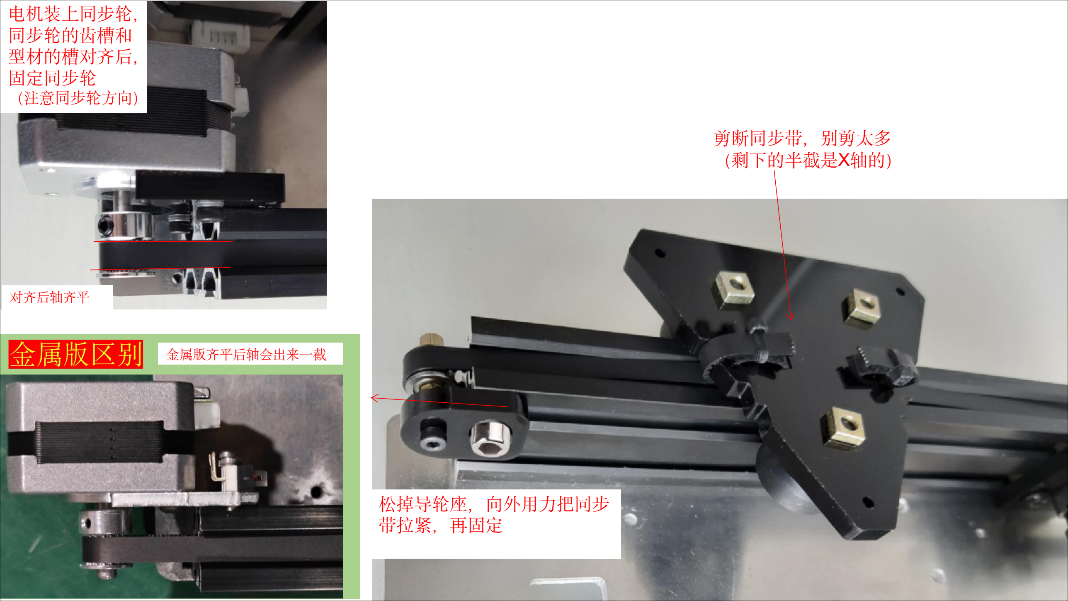
[picture p163: page 23]

电机装上同步轮，
同步轮的齿槽和
型材的槽对齐后，
固定同步轮
（注意同步轮方向）

剪断同步带，别剪太多
（剩下的半截是X轴的）

松掉导轮座，向外用力把同步
带拉紧，再固定

对齐后轴齐平

金属版齐平后轴会出来一截

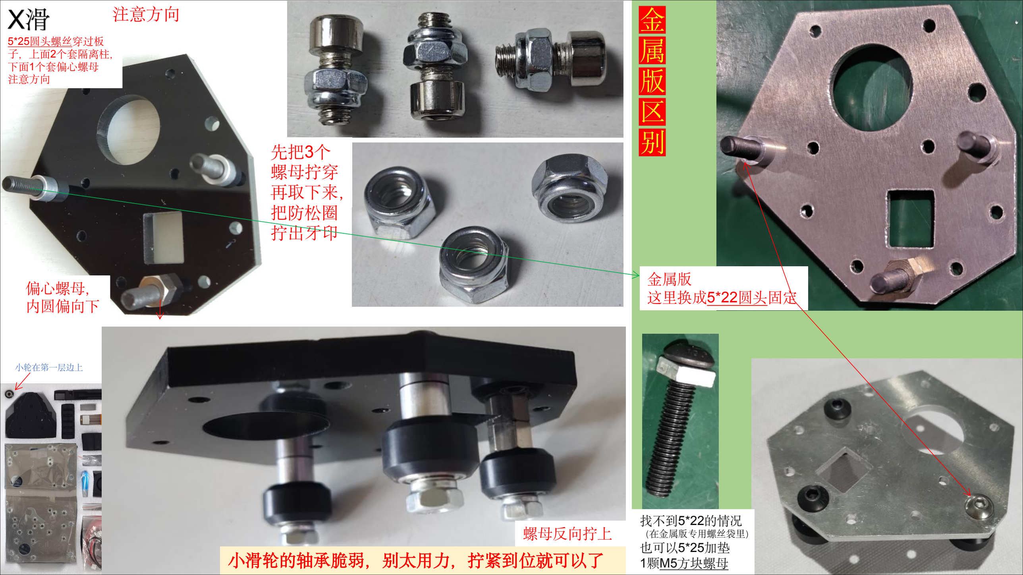
[picture p164: page 24]

小轮在第一层边上

偏心螺母，
内圆偏向下

螺母反向拧上

注意方向

先把3个
螺母拧穿
再取下来，
把防松圈
拧出牙印

小滑轮的轴承脆弱，别太用力，拧紧到位就可以了

5*25圆头螺丝穿过板
子，上面2个套隔离柱，
下面1个套偏心螺母
注意方向

找不到5*22的情况
（在金属版专用螺丝袋里）
也可以5*25加垫
1颗M5方块螺母

金属版
这里换成5*22圆头固定

## 滑块装上X型材， 调节偏心螺母， 调到不晃动

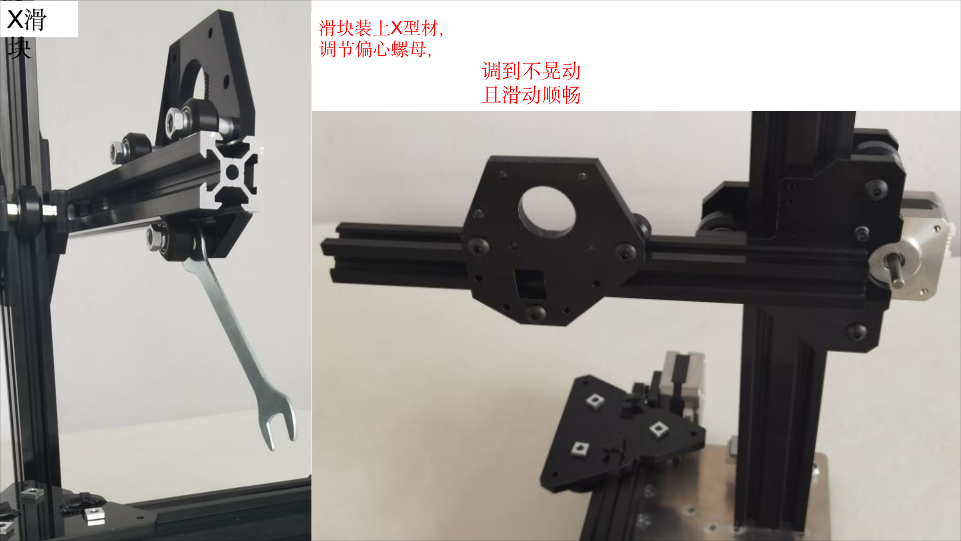
[picture p165: page 25]

## 且滑动顺畅

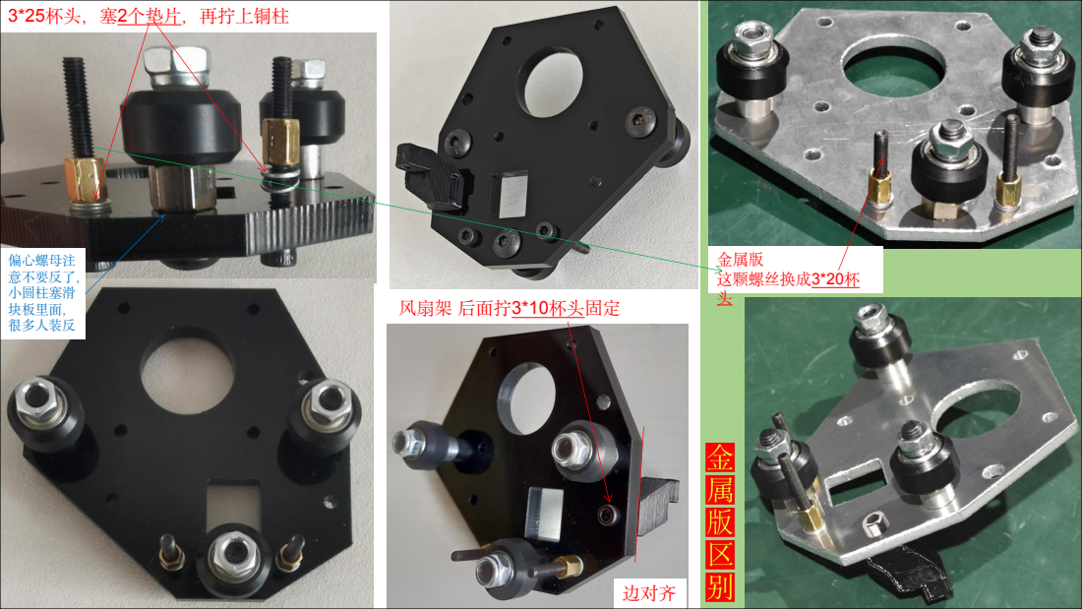
[picture p166: page 26]
3*25杯头，塞2个垫片，再拧上铜柱; 风扇架 后面拧3*10杯头固定; 边对齐; 偏心螺母注 意不要反了， 小圆柱塞滑 块板里面， 很多人装反; 金属版 这颗螺丝换成3*20杯 头

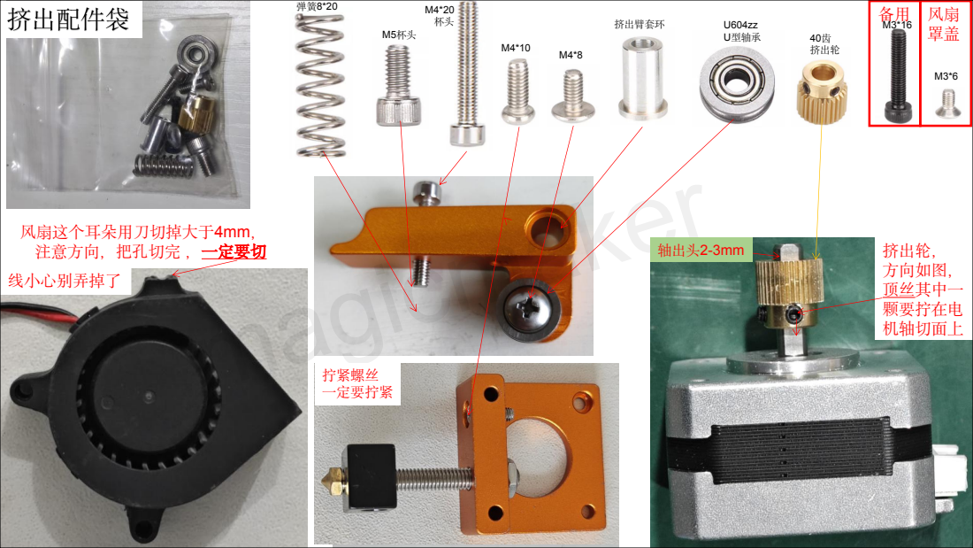
[picture p167: page 27]
挤出轮， 方向如图， 和电机轴齐平; 风扇这个耳朵用刀切掉大于4mm， 注意方向，把孔切完 ，一定要切; magicmaker; 线小心别弄掉了; 挤出轮， 方向如图， 顶丝其中一 颗要拧在电 机轴切面上; 拧紧螺丝 一定要拧紧; 轴出头2-3mm; 挤出臂套环; U型轴承; 挤出轮

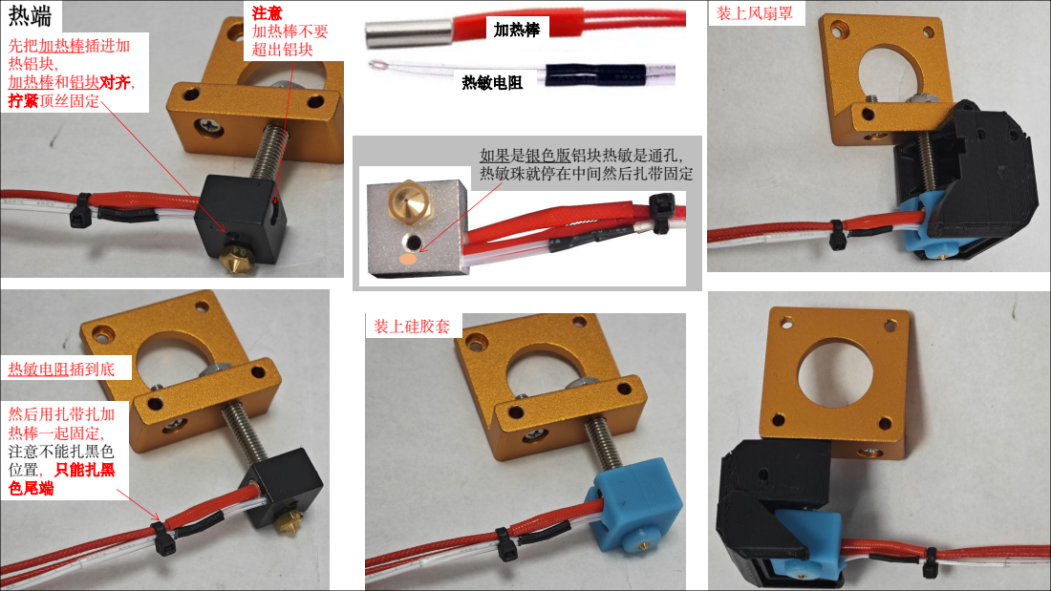
[picture p168: page 28]
先把加热棒插进加 热铝块， 加热棒和铝块对齐， 拧紧顶丝固定; 注意 加热棒不要 超出铝块; 然后用扎带扎加 热棒一起固定， 注意不能扎黑色 位置，只能扎黑 色尾端; 装上硅胶套; 装上风扇罩; 热敏电阻插到底; 加热棒; 热敏电阻; 如果是银色版铝块热敏是通孔， 热敏珠就停在中间然后扎带固定

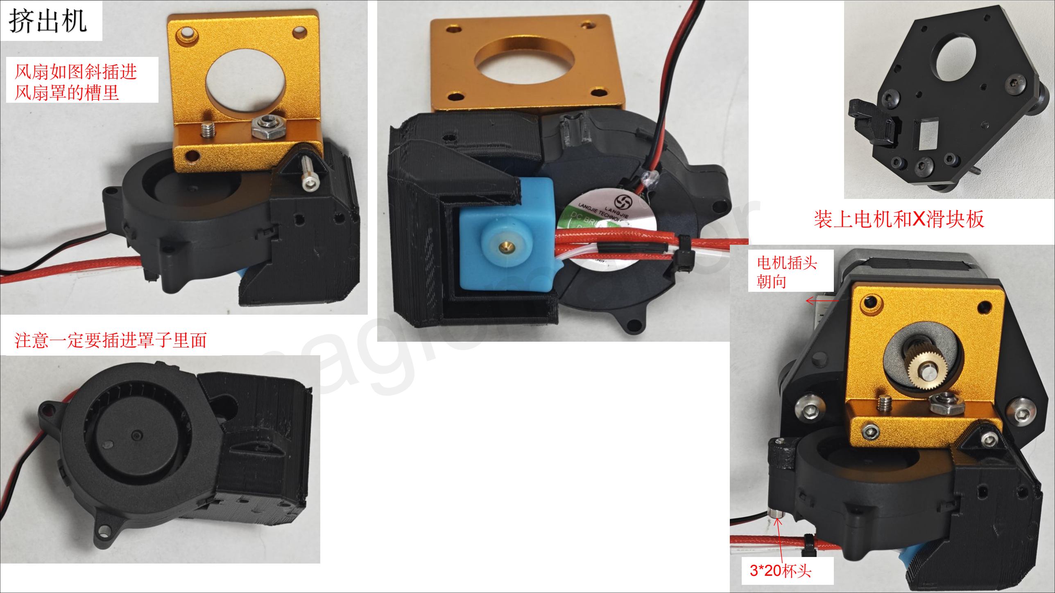
[picture p169: page 29]

风扇如图斜插进
风扇罩的槽里

# magicmaker

注意一定要插进罩子里面

3*20杯头

## 装上电机和X滑块板

电机插头
朝向

3*20杯头

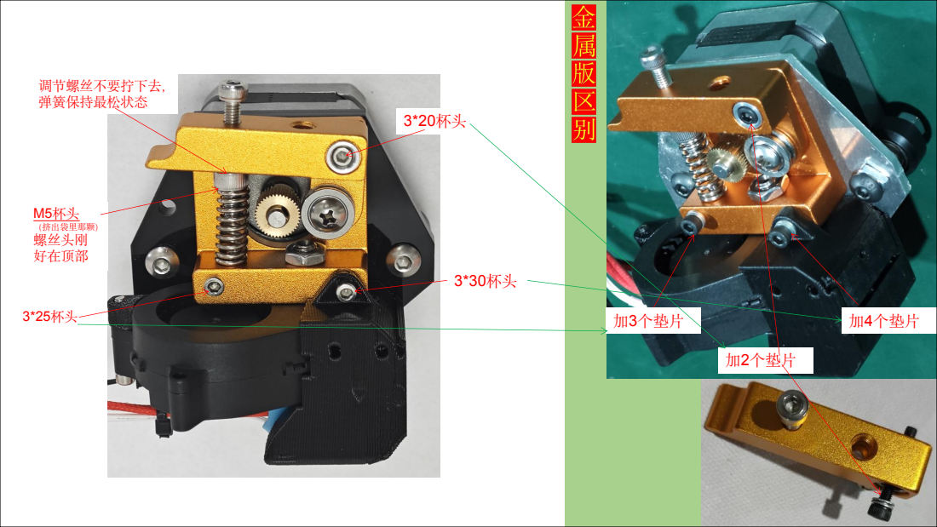
[picture p170: page 30]
调节螺丝不要拧下去， 弹簧保持最松状态; （挤出袋里那颗） 螺丝头刚 好在顶部; 加3个垫片; 加4个垫片; 加2个垫片

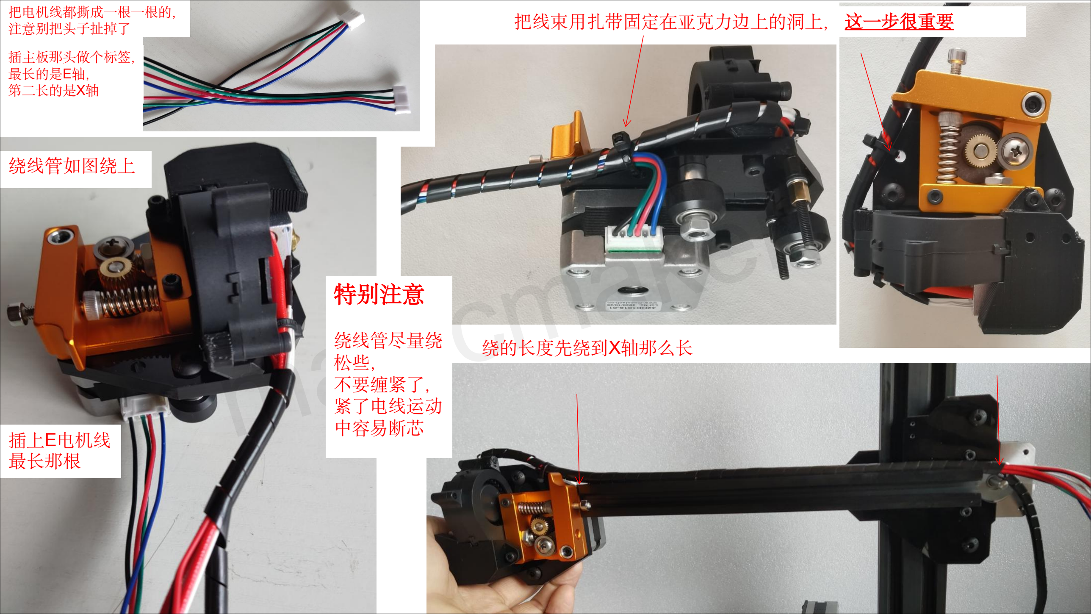
[picture p171: page 31]

# magicmaker

绕线管如图绕上

插上E电机线
最长那根

把线束用扎带固定在亚克力边上的洞上，

绕的长度先绕到X轴那么长

这一步很重要

## 特别注意

绕线管尽量绕
松些，
不要缠紧了，
紧了电线运动
中容易断芯

把电机线都撕成一根一根的，
注意别把头子扯掉了

插主板那头做个标签，
最长的是E轴，
第二长的是X轴

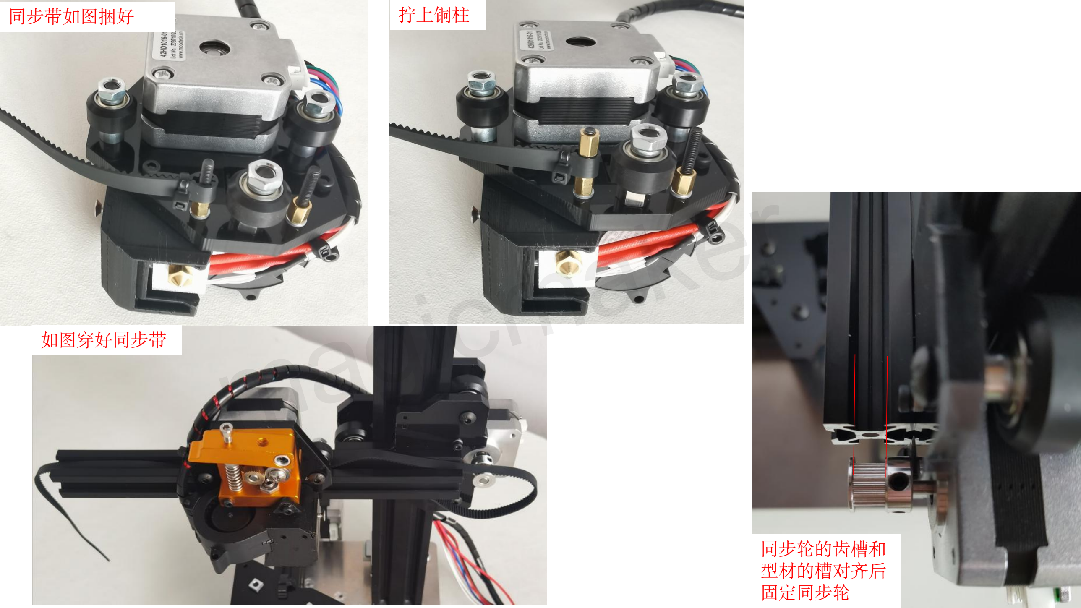
[picture p172: page 32]

# magicmaker

同步带如图捆好

同步轮的齿槽和
型材的槽对齐后
固定同步轮

如图穿好同步带

拧上铜柱

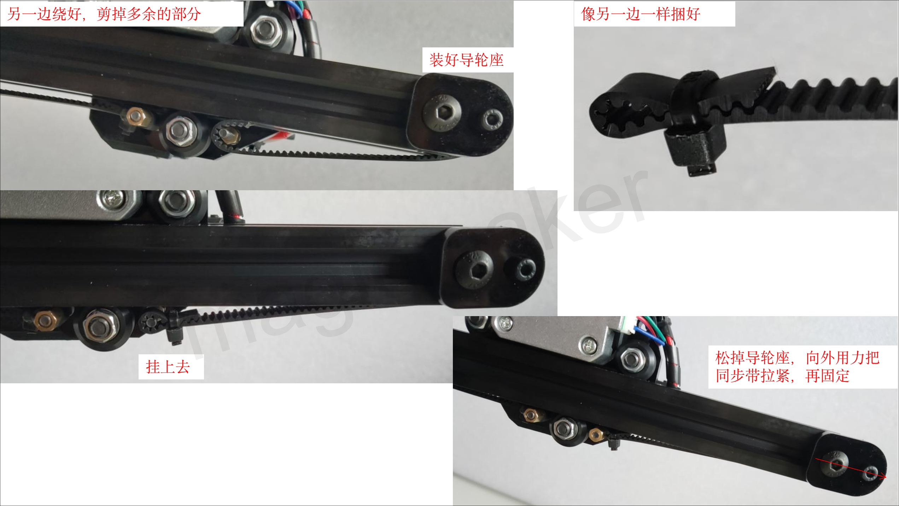
[picture p173: page 33]

另一边绕好，剪掉多余的部分 | 像另一边一样捆好

装好导轮座

挂上去

松掉导轮座，向外用力把 m

同步带拉紧，再固定

# agicmaker

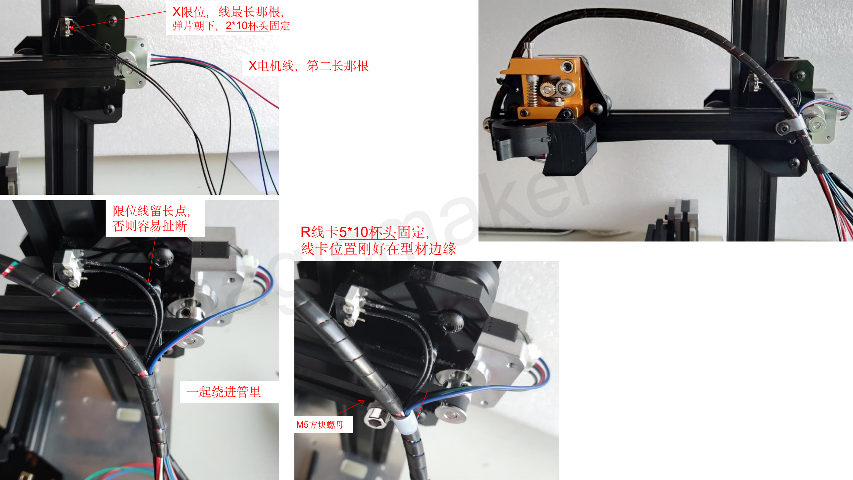
[picture p174: page 34]

X限位，线最长那根，
弹片朝下，2*10杯头固定

R线卡5*10杯头固定，
线卡位置刚好在型材边缘

X电机线，第二长那根

一起绕进管里

限位线留长点，
否则容易扯断

M5方块螺母

# magicmaker

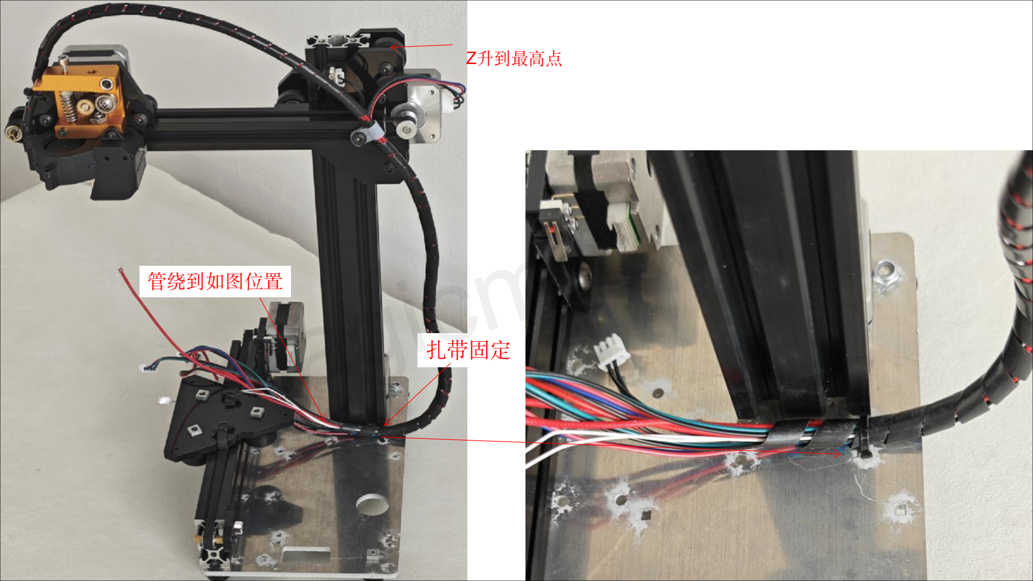
[picture p175: page 35]

Z升到最高点

## 扎带固定

## 管绕到如图位置

# magicmaker

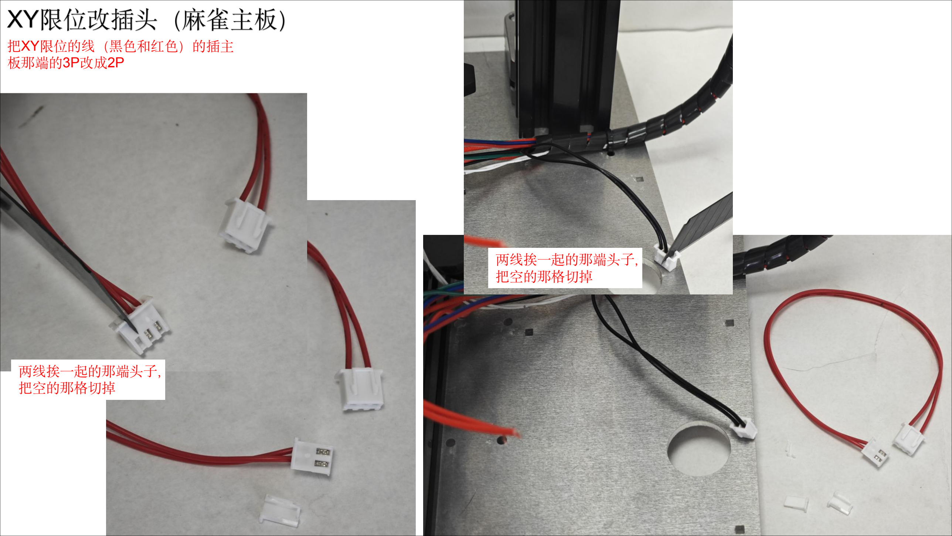
[picture p176: page 36]

把XY限位的线（黑色和红色）的插主
板那端的3P改成2P

两线挨一起的那端头子，
把空的那格切掉

两线挨一起的那端头子，
把空的那格切掉

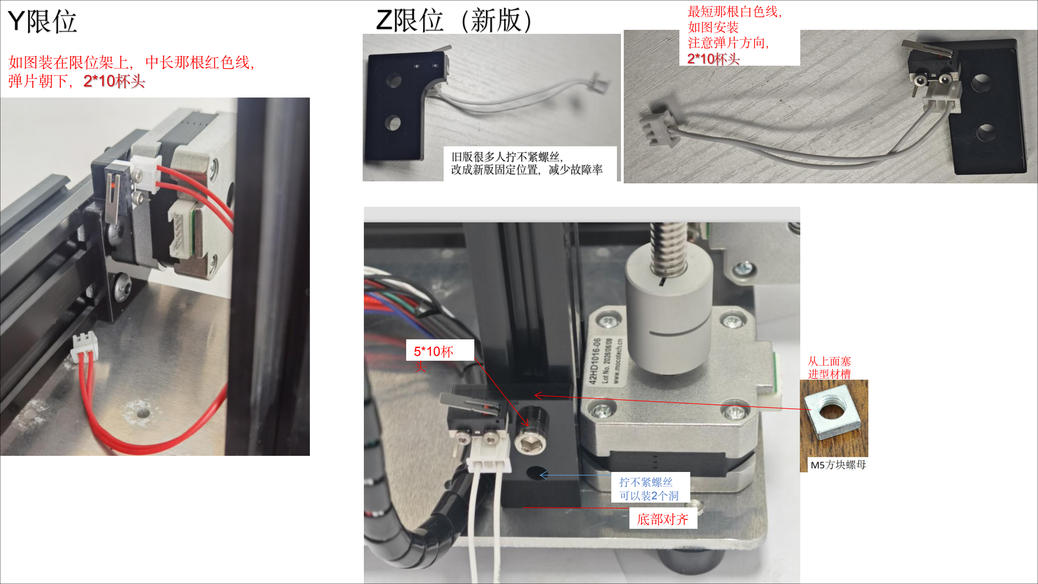
[picture p177: page 37]

如图装在限位架上，中长那根红色线，
弹片朝下，

最短那根白色线，
如图安装
注意弹片方向，

5*10杯
头

底部对齐

拧不紧螺丝
可以装2个洞

从上面塞
进型材槽

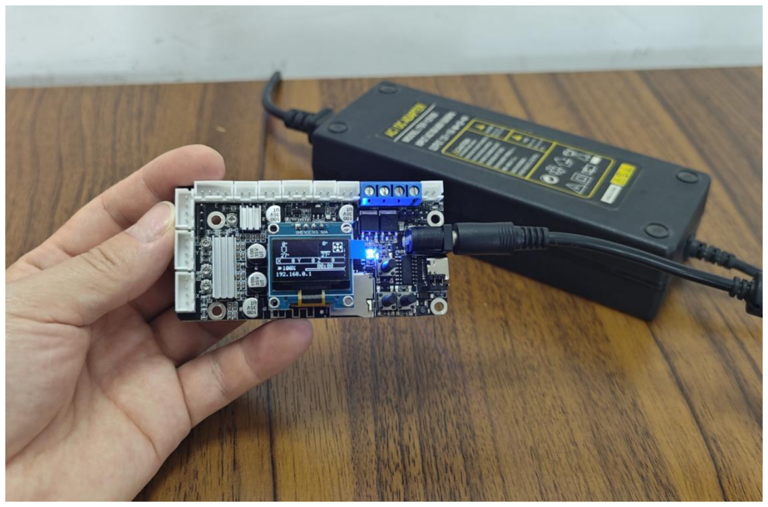
[picture p178: figure]

## （机器开关机：直接插拔主板上的DC插头）

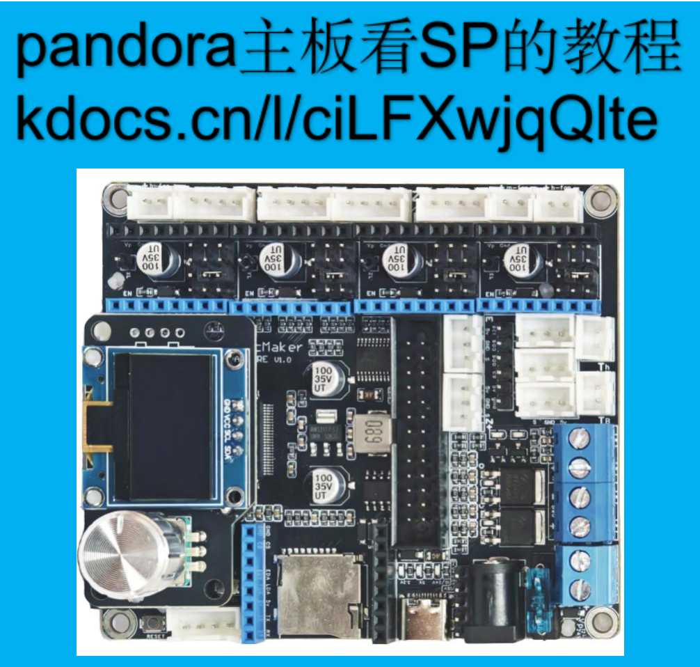
[picture p179: figure]

## 主板先插上电源，确认屏幕能亮， 说明主板完好，再进行下一步。（USB供电也能点亮屏幕）

# 特别注意主板不要放在铝板等导电物体上，会短路烧坏（A4纸不绝缘)

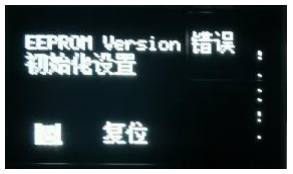
[picture p180: figure]
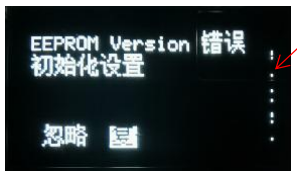
[picture p181: figure]

## 程序有自动息屏，息屏后转旋钮能恢复亮屏

如果出现这个界面，需要按键选到右边，再点确认

显示屏最右边的一
排点是正常现象，
不影响正常使用

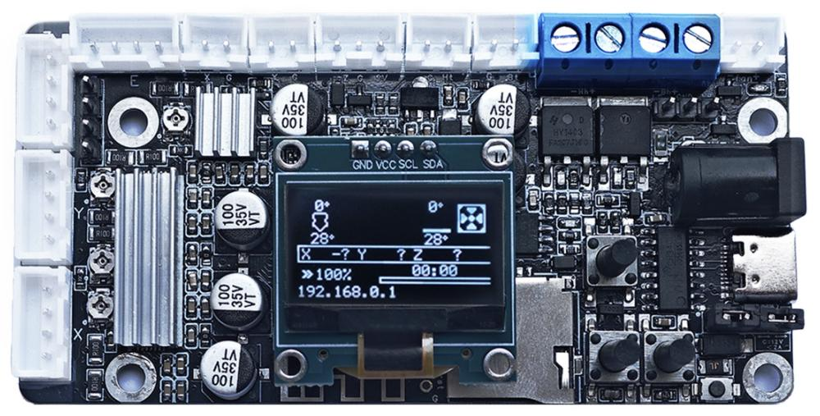
[picture p182: figure]

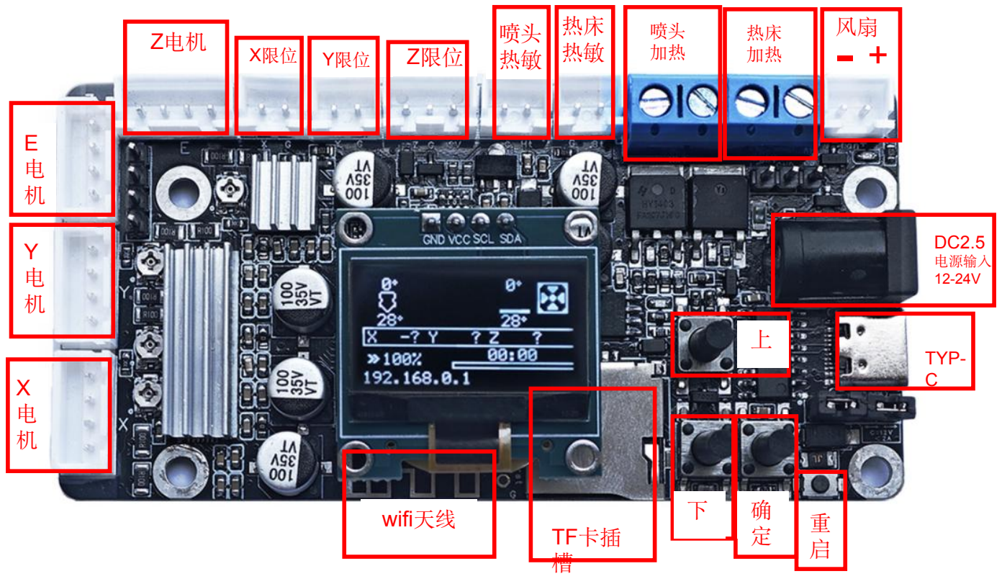
[picture p183: figure]
wifi天线; X限位; Y限位; Z限位; Z电机; TF卡插 槽; TYP- C; DC2.5 电源输入 12-24V

# 热床和加热头

所有接头均正面有丝印，请正确接线，接错线烧坏元件或主板需付费维修，特别注意热敏不要插到风扇那了

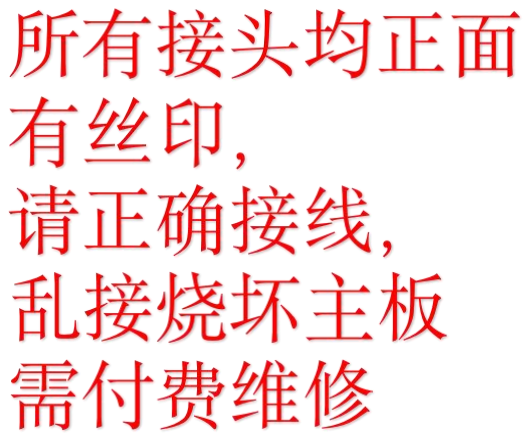
[picture p184: figure]

# 安装和使用过程中，千万注意螺丝和铁削之类别掉在主板上了，会引起短路烧坏主板

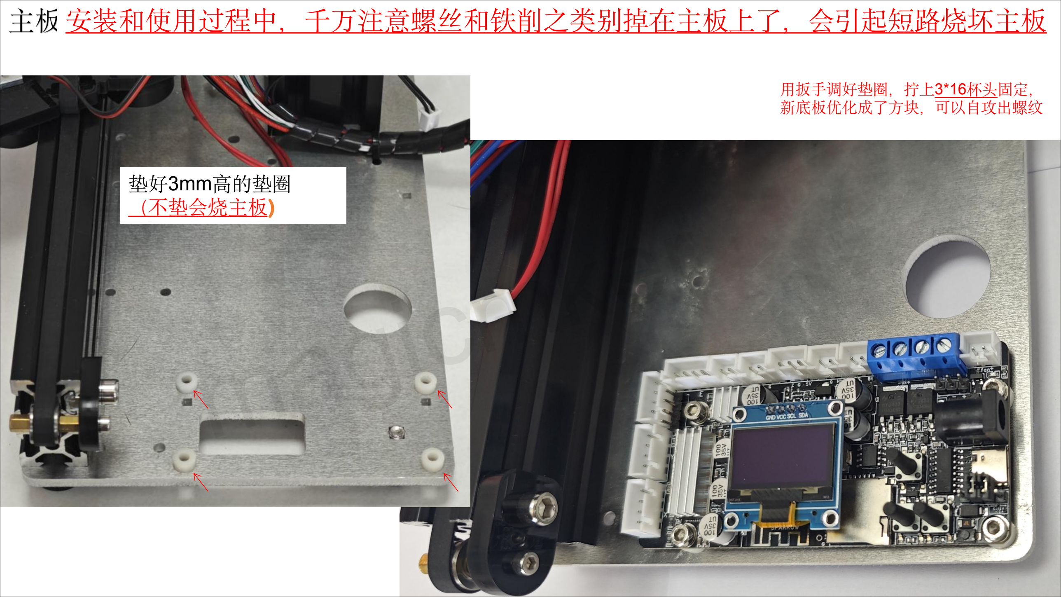
[picture p185: page 40]

## 垫好3mm高的垫圈 （不垫会烧主板

用扳手调好垫圈，拧上3*16杯头固定，
新底板优化成了方块，可以自攻出螺纹

# magicmker

## 先把加热棒线和热床线 都接好，

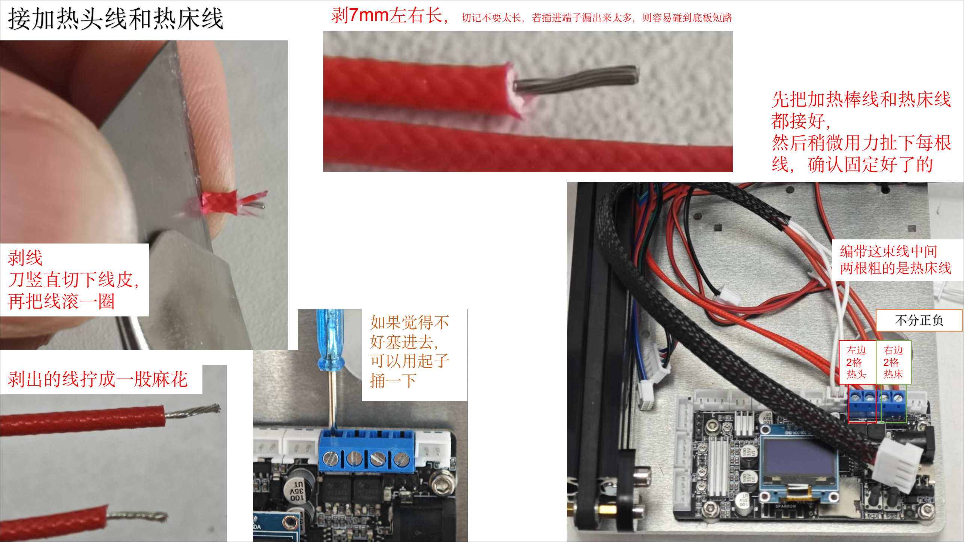
[picture p186: page 41]

剥线

## 刀竖直切下线皮， 再把线滚一圈

剥7mm左右长，切记不要太长，若插进端子漏出来太多，则容易碰到底板短路

## 剥出的线拧成一股麻花

## 然后稍微用力扯下每根 线，确认固定好了的

编带这束线中间
两根粗的是热床线

左边
2格
热头

右边
2格
热床

如果觉得不
好塞进去，
可以用起子
捅一下

先插好电机线，Y和Z电机是短的2根 | 插好其他线 | 热床线

## 端子卡扣

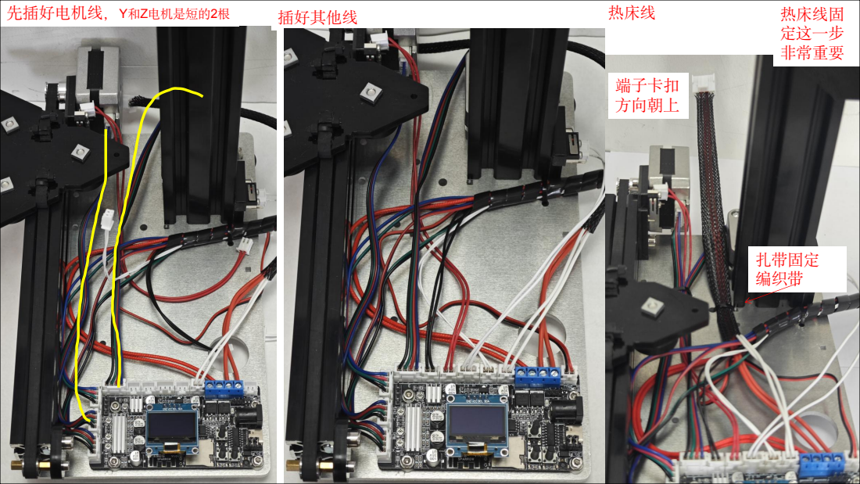
[picture p187: page 42]
方向朝上; 扎带固定 编织带; 热床线固 定这一步 非常重要

## 扎带把线固定在底板上

## 扎带不够长可以2根

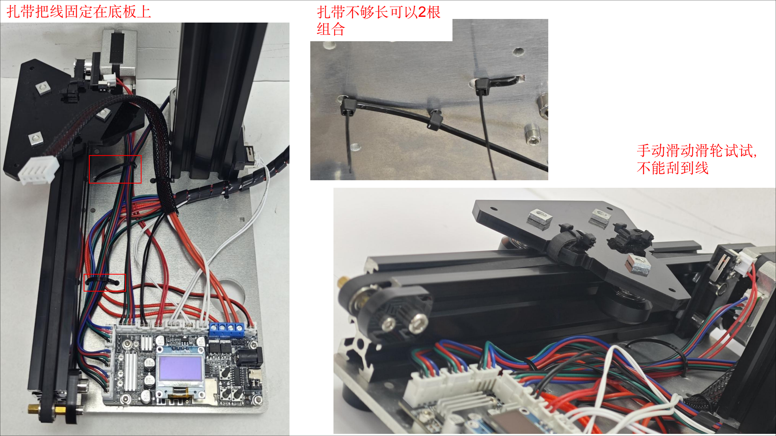
[picture p188: page 43]

## 手动滑动滑轮试试， 不能刮到线

组合

Z电
机

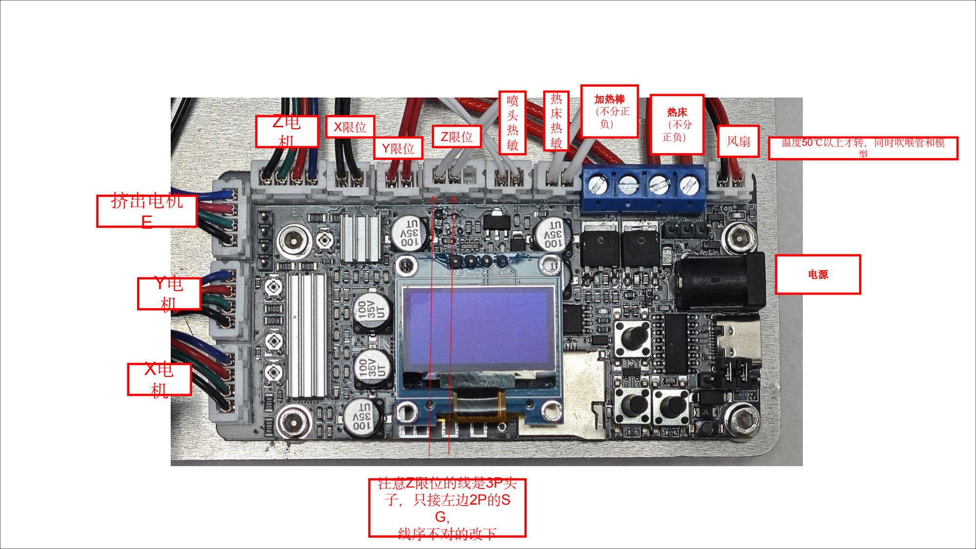
[picture p189: page 44]

X电
机

Y电
机

## 挤出电机

E

风扇

加热棒
（不分正
负）

喷
头
热
敏

X限位

注意Z限位的线是3P头
子，只接左边2P的S
G，
线序不对的改下

热床
（不分
正负）

热
床
热
Y限位 | 敏
Z限位 | 温度50℃以上才转，同时吹喉管和模
| 型

电源

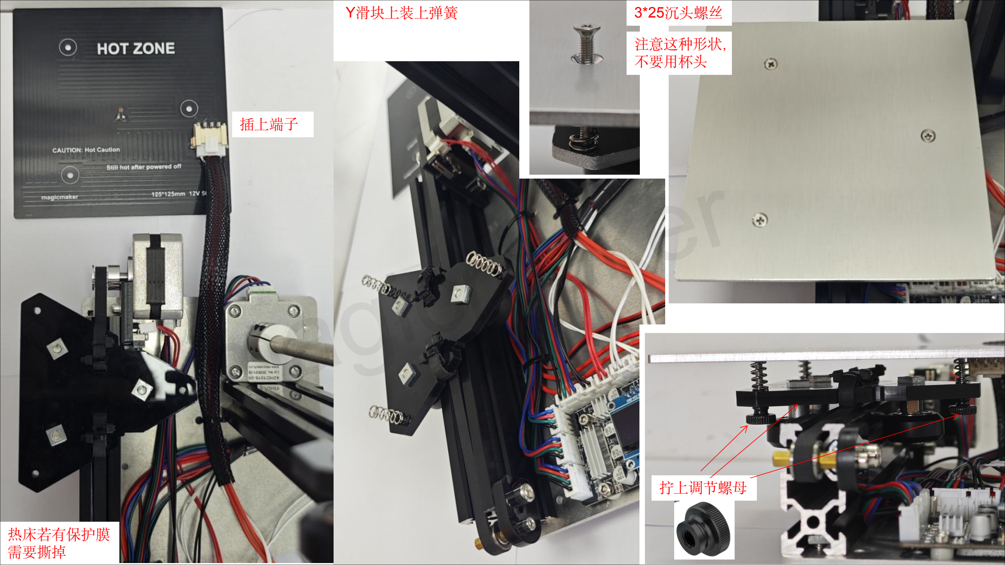
[picture p190: page 45]

热床若有保护膜
需要撕掉

插上端子

Y滑块上装上弹簧

拧上调节螺母

# magicmaker

注意这种形状，
不要用杯头

3*25沉头螺丝

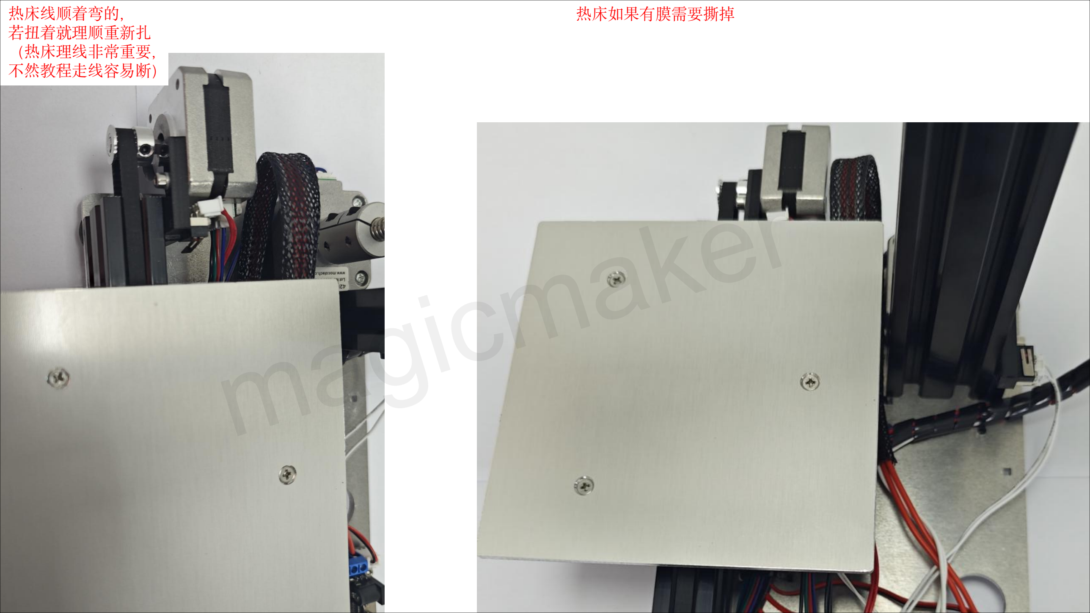
[picture p191: page 46]

热床线顺着弯的，
若扭着就理顺重新扎
（热床理线非常重要，
不然教程走线容易断）

# magicmaker

热床如果有膜需要撕掉

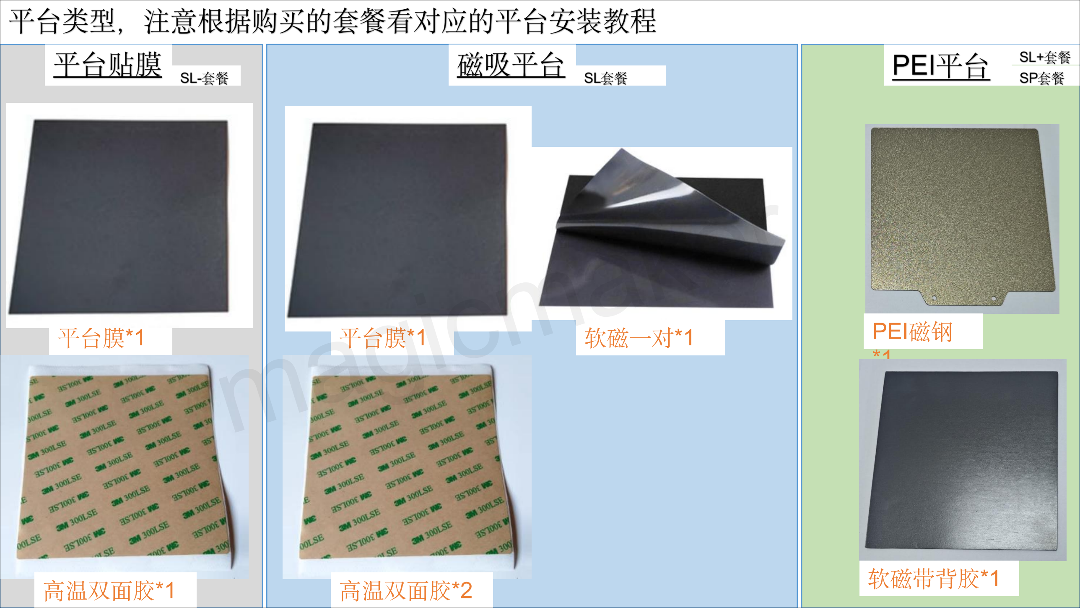
[picture p192: page 47]

## 平台膜*1

高温双面胶*1 | 高温双面胶*2
平台膜*1 | 软磁一对*1 | PEI磁钢

# *1 magicmaker

## 软磁带背胶*1

## 黑膜直接贴热床上，磨砂朝上

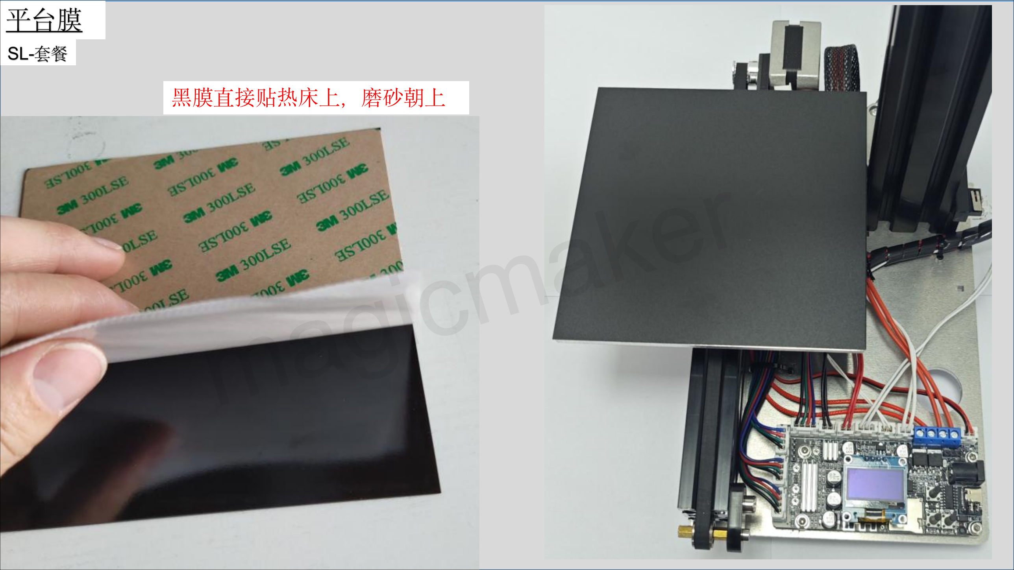
[picture p193: page 48]

# magicmaker

## 磁吸套贴3M胶 一面贴上黑色贴膜

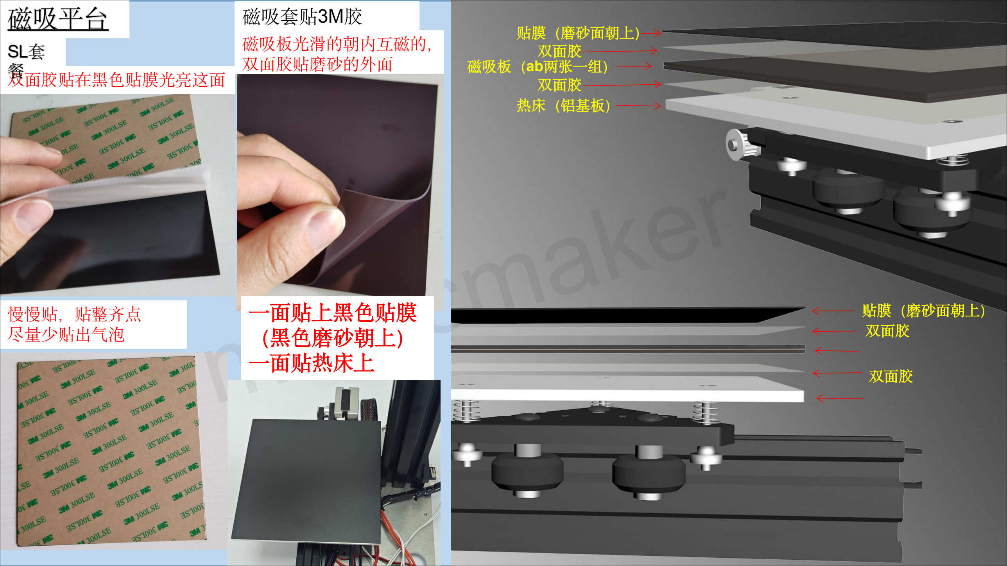
[picture p194: page 49]

双面胶贴在黑色贴膜光亮这面

慢慢贴，贴整齐点

尽量少贴出气泡 magicmaker 磁吸板光滑的朝内互磁的， 双面胶贴磨砂的外面

## （黑色磨砂朝上） 一面贴热床上

贴膜（磨砂面朝上）
双面胶
磁吸板（ab两张一组）
双面胶
热床（铝基板）

贴膜（磨砂面朝上）

双面胶

双面胶

# 把软磁撕了背胶贴热床上

# 金属板直接放软磁上面，

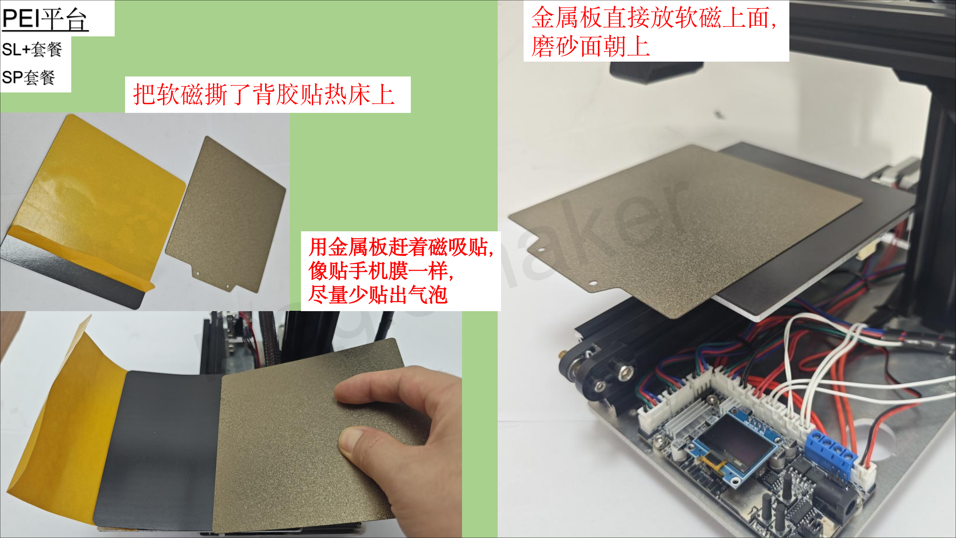
[picture p195: page 50]

ma

用金

g
属板

i
赶

c

## 着磁m

## 吸贴， aker

## 像贴手机膜一样， 尽量少贴出气泡

# 磨砂面朝上

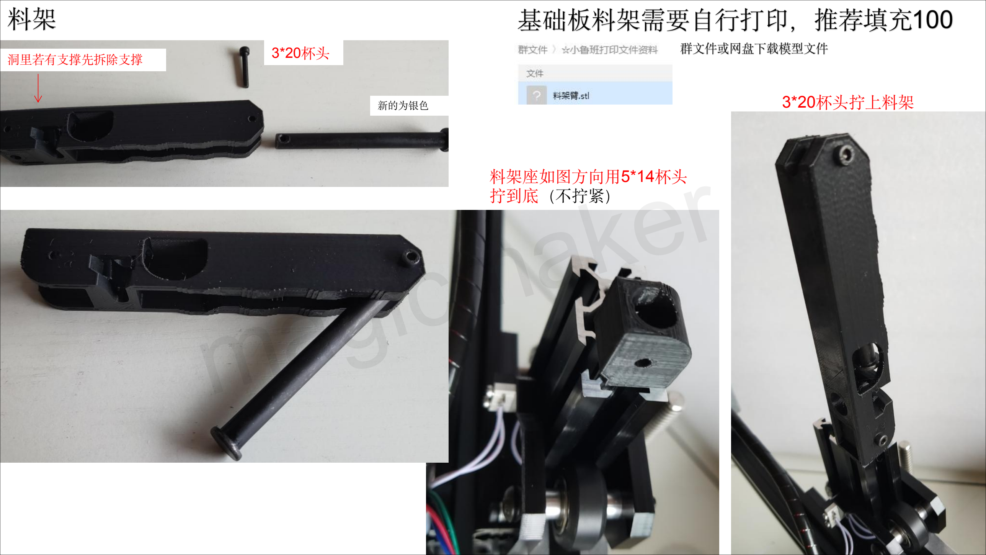
[picture p196: page 51]

3*20杯头

料架座如图方向用5*14杯头
拧到底（不拧紧）

# magicmaker

洞里若有支撑先拆除支撑

新的为银色 | 3*20杯头拧上料架

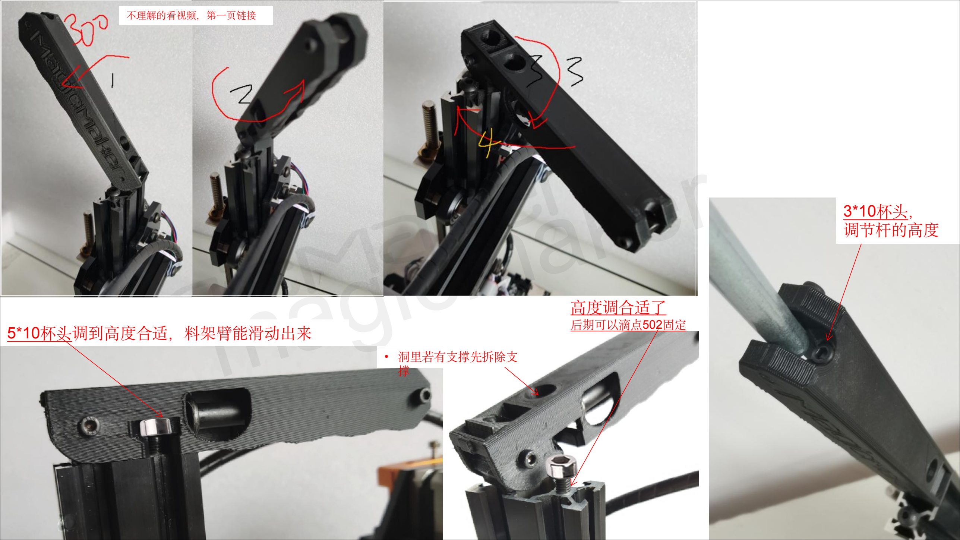
[picture p197: page 52]

# magicmaker

5*10杯头调到高度合适，料架臂能滑动出来

高度调合适了
后期可以滴点502固定

不理解的看视频，第一页链接

3*10杯头，
调节杆的高度
- 洞里若有支撑先拆除支
撑

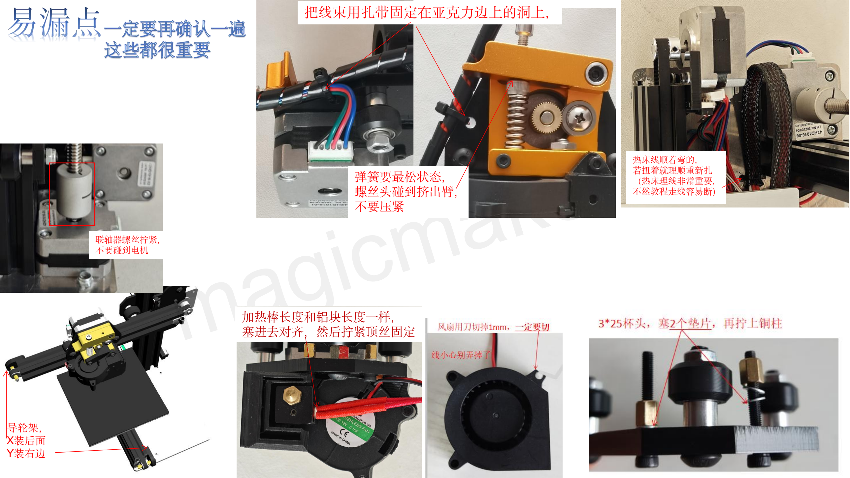
[picture p198: page 53]

# magicmaker

联轴器螺丝拧紧，
不要碰到电机

导轮架，
X装后面
Y装右边

把线束用扎带固定在亚克力边上的洞上，

弹簧要最松状态，
螺丝头碰到挤出臂，
不要压紧

热床线顺着弯的，
若扭着就理顺重新扎
（热床理线非常重要，
不然教程走线容易断）

加热棒长度和铝块长度一样，
塞进去对齐，然后拧紧顶丝固定

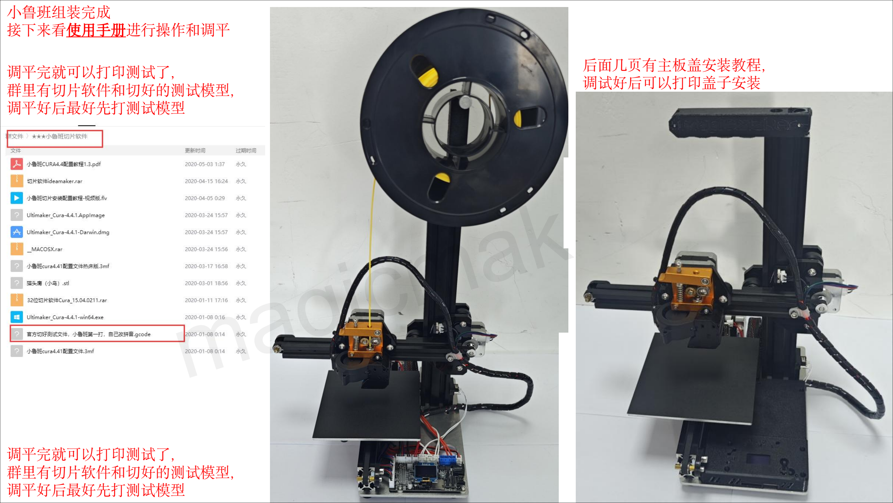
[picture p199: page 54]

小鲁班组装完成
接下来看使用手册进行操作和调平

调平完就可以打印测试了，
群里有切片软件和切好的测试模型，
调平好后最好先打测试模型

# magicmaker

调平完就可以打印测试了，
群里有切片软件和切好的测试模型，
调平好后最好先打测试模型

后面几页有主板盖安装教程，
调试好后可以打印盖子安装

# 注意事项（一定要读完)

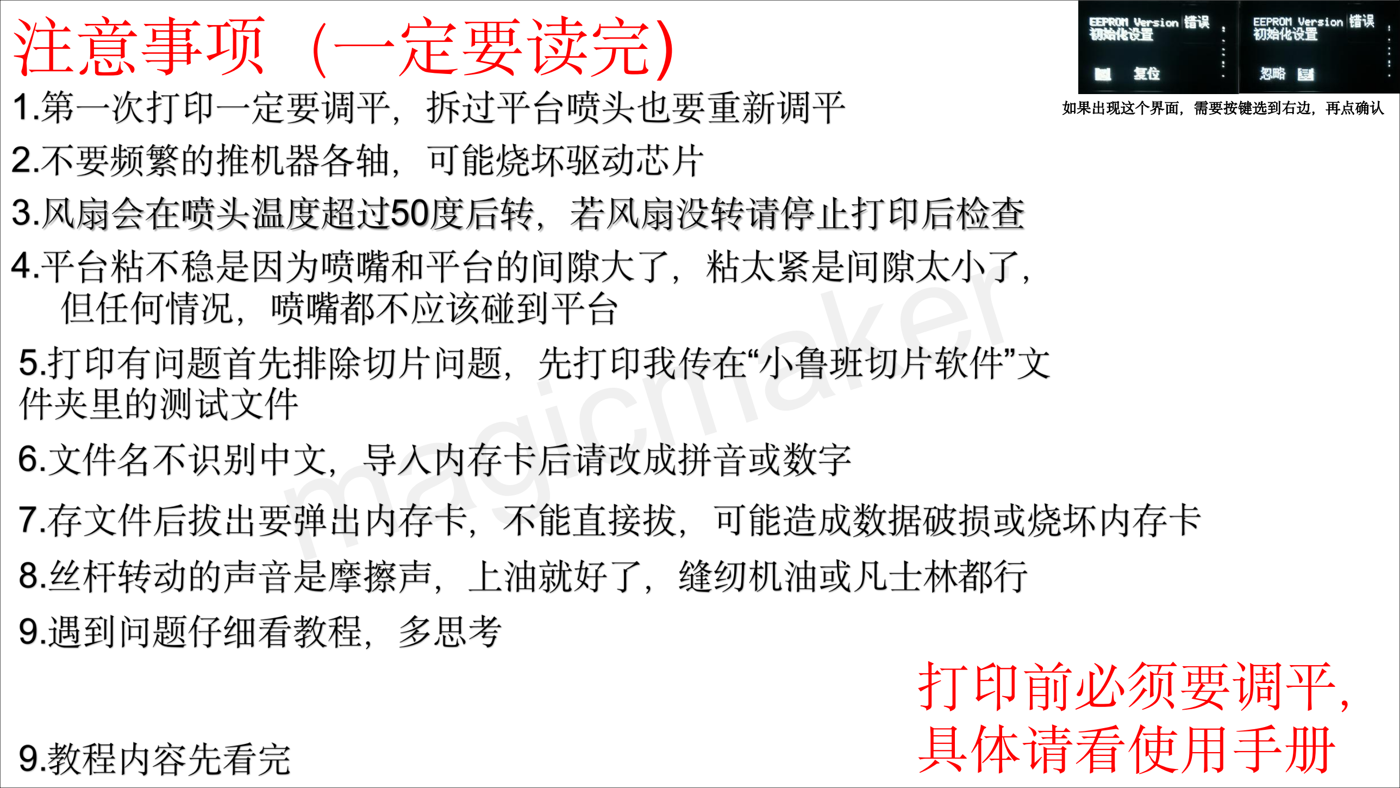
[picture p200: page 55]

# 打印前必须要调平， 具体请看使用手册

# magicmaker

如果出现这个界面，需要按键选到右边，再点确认

## 按键操作，左边是上下选择，右边是确认

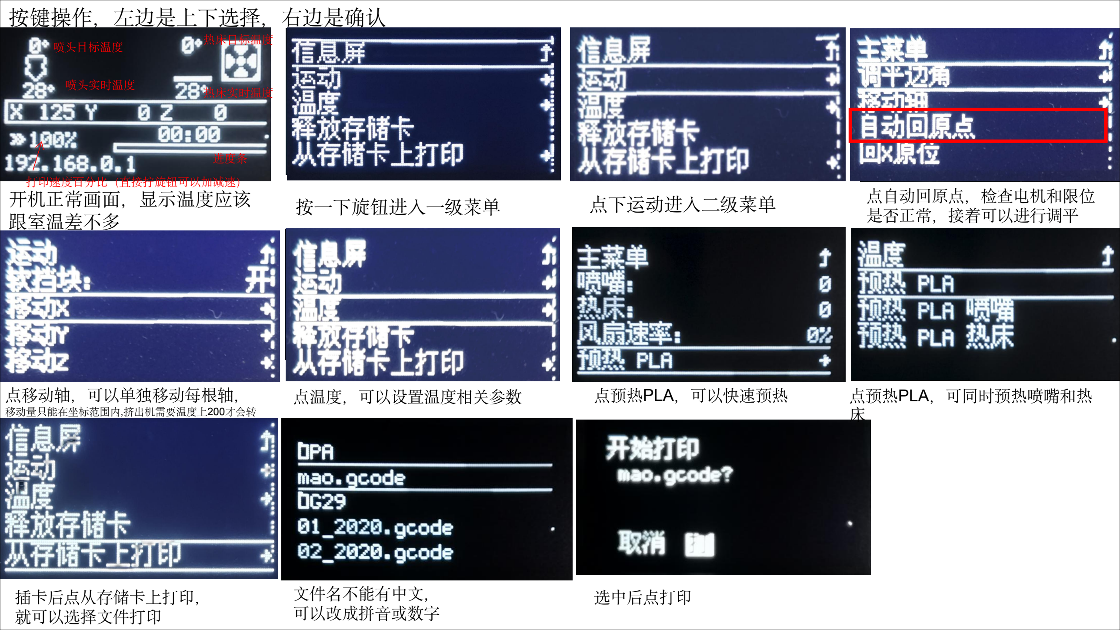
[picture p201: page 56]

开机正常画面，显示温度应该
跟室温差不多
按一下旋钮进入一级菜单 | 点下运动进入二级菜单 | 点自动回原点，检查电机和限位 是否正常，接着可以进行调平

## 需要单独加热喷头点

## 预热PLA（180℃）或 ABS（240℃）

插卡后点从存储卡上打印，
就可以选择文件打印

点移动轴，可以单独移动每根轴，
移动量只能在坐标范围内,挤出机需要温度上200才会转

喷头目标温度

喷头实时温度

打印速度百分比（直接拧旋钮可以加减速）

进度条

热床实时温度

热床目标温度

文件名不能有中文，
可以改成拼音或数字

选中后点打印

点温度，可以设置温度相关参数 | 点预热PLA，可以快速预热 | 点预热PLA，可同时预热喷嘴和热 床

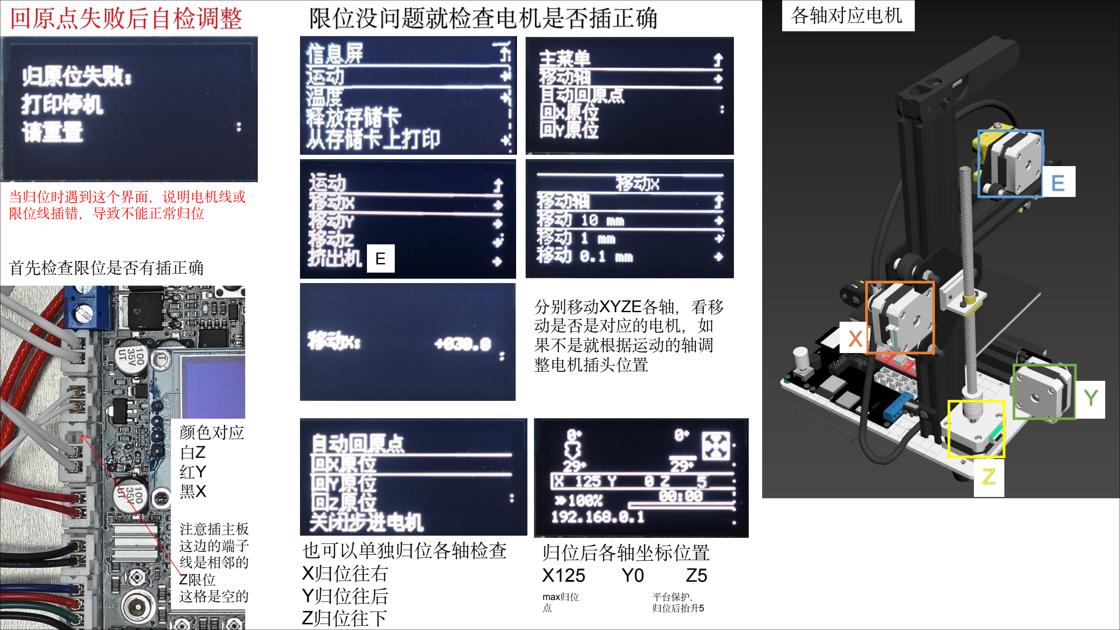
[picture p202: page 57]

当归位时遇到这个界面，说明电机线或
限位线插错，导致不能正常归位

也可以单独归位各轴检查
X归位往右
Y归位往后
Z归位往下

分别移动XYZE各轴，看移
动是否是对应的电机，如
果不是就根据运动的轴调
整电机插头位置

首先检查限位是否有插正确

颜色对应
白Z
红Y
黑X

注意插主板
这边的端子
线是相邻的
Z限位
这格是空的

E

各轴对应电机

归位后各轴坐标位置
X125 | Y0 | Z5
max归位 点 | | 平台保护， 归位后抬升5

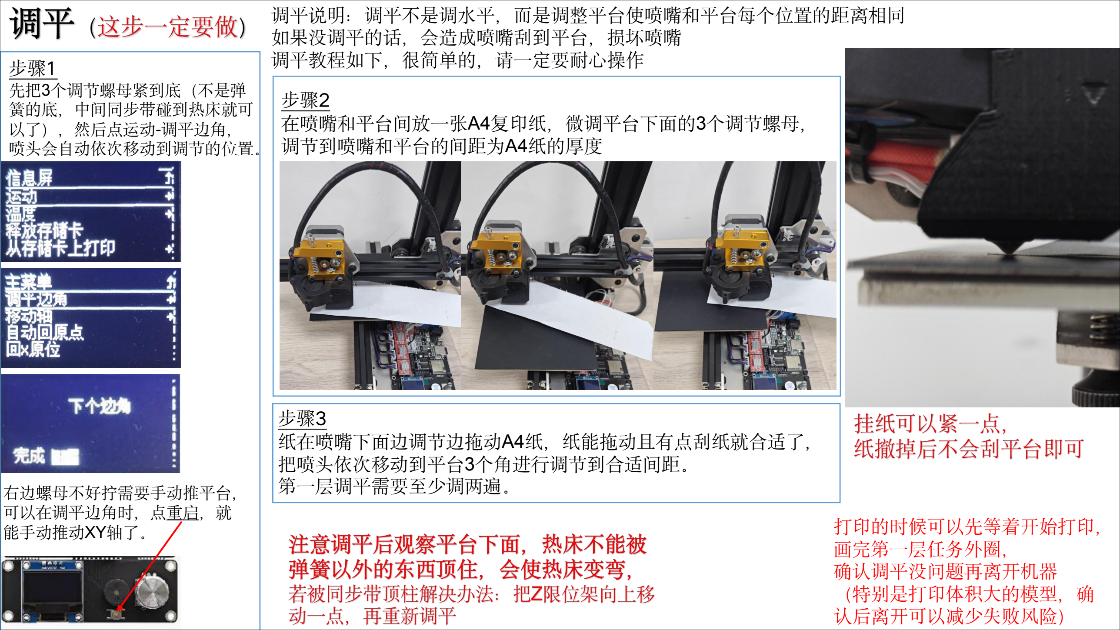
[picture p203: page 58]

调平说明：调平不是调水平，而是调整平台使喷嘴和平台每个位置的距离相同 如果没调平的话，会造成喷嘴刮到平台，损坏喷嘴
调平教程如下，很简单的，请一定要耐心操作
步骤2
在喷嘴和平台间放一张A4复印纸，微调平台下面的3个调节螺母， 调节到喷嘴和平台的间距为A4纸的厚度

打印的时候可以先等着开始打印，
画完第一层任务外圈，
确认调平没问题再离开机器
（特别是打印体积大的模型，确
认后离开可以减少失败风险）

步骤1
先把3个调节螺母紧到底（不是弹
簧的底，中间同步带碰到热床就可
以了），然后点运动-调平边角，
喷头会自动依次移动到调节的位置。 步骤3

纸在喷嘴下面边调节边拖动A4纸，纸能拖动且有点刮纸就合适了， 把喷头依次移动到平台3个角进行调节到合适间距。
右边螺母不好拧需要手动推平台， 第一层调平需要至少调两遍。 可以在调平边角时，点重启，就
能手动推动XY轴了。

# 调平进阶

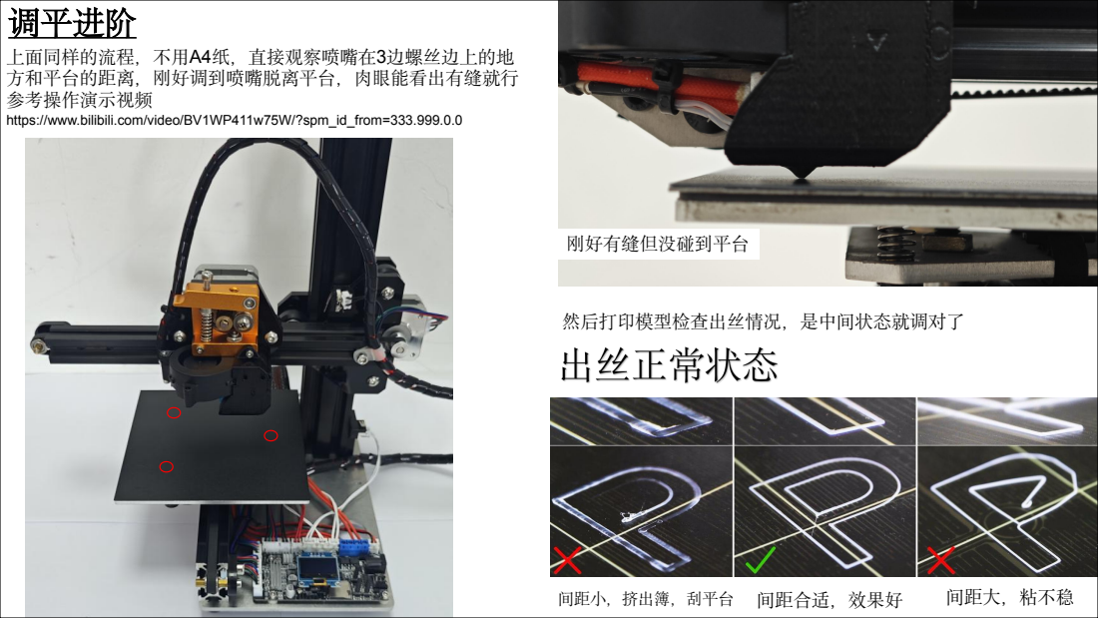
[picture p204: page 59]
间距小，挤出簿，刮平台 间距合适，效果好; 间距大，粘不稳; 刚好有缝但没碰到平台; 然后打印模型检查出丝情况，是中间状态就调对了

上面同样的流程，不用A4纸，直接观察喷嘴在3边螺丝边上的地
方和平台的距离，刚好调到喷嘴脱离平台，肉眼能看出有缝就行
参考操作演示视频
https://www.bilibili.com/video/BV1WP411w75W/?spm_id_from=333.999.0.0

### 1.点温度---预热PLA---预热PLA喷头，

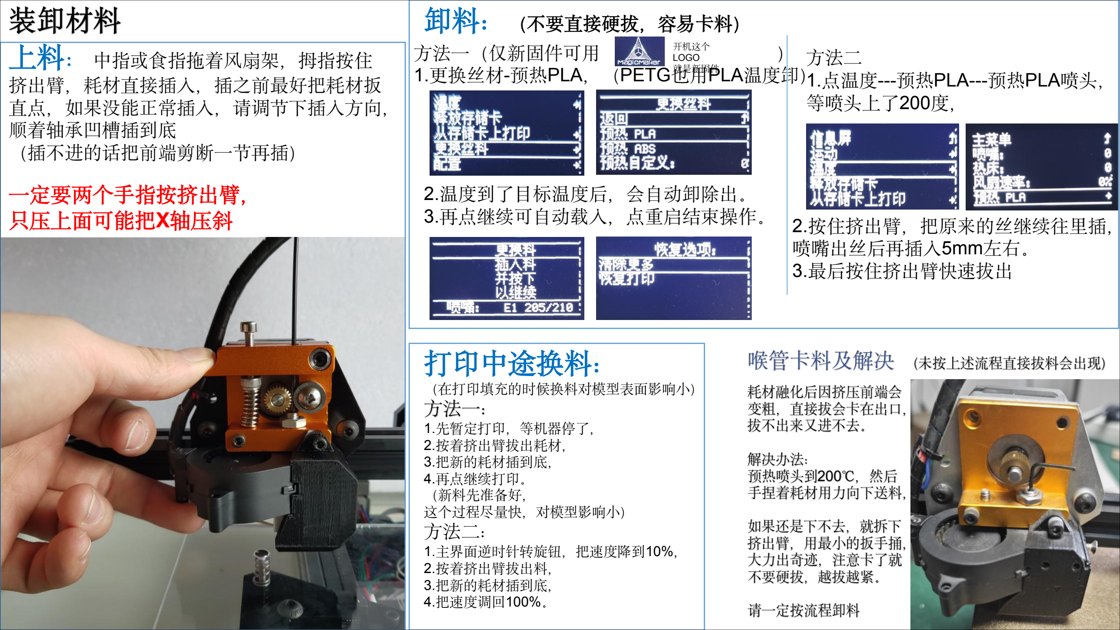
[picture p205: page 60]

2.按住挤出臂，把原来的丝继续往里插，
喷嘴出丝后再插入5mm左右。
3.最后按住挤出臂快速拔出

上料：中指或食指拖着风扇架，拇指按住
挤出臂，耗材直接插入，插之前最好把耗材扳
直点，如果没能正常插入，请调节下插入方向，
顺着轴承凹槽插到底
（插不进的话把前端剪断一节再插） 一定要两个手指按挤出臂，

## 只压上面可能把X轴压斜

卸料：（不要直接硬拔，容易卡料）

# 打印中途换料：

（在打印填充的时候换料对模型表面影响小）

1.先暂定打印，等机器停了，
2.按着挤出臂拔出耗材，
3.把新的耗材插到底，
4.再点继续打印。
（新料先准备好，
这个过程尽量快，对模型影响小）
方法二：
1.主界面逆时针转旋钮，把速度降到10%，
2.按着挤出臂拔出料，
3.把新的耗材插到底，
4.把速度调回100%。
方法一（仅新固件可用 | ）
1.更换丝材-预热PLA，（PETG也用PLA温度卸）

方法二

等喷头上了200度，

2.温度到了目标温度后，会自动卸除出。
3.再点继续可自动载入，点重启结束操作。

开机这个
LOGO
就是新固件

官方群里下载切好的测试模型，导入内存，再把内存卡插上打印机，选择里面切好的文件***.gcode 打印，机器会先预热喷头到打印温 度，预热好了就开始打印，观察第一层喷嘴是否有刮擦平台，出丝是否有沾牢平台，第一层打印无问题即可离开机器 后期如果有动过喷头，动过平台，大的搬动等情况使平台可能不平了，需要重新调平 建议打印稍大的模型打印前期都看一眼，喷头有没有刮平台或没粘稳,有这个情况及时停止重新调平

（把STL的模型文件转成机器可识别代码文件）

## 下载好切片软件ORCA和教程，按切片教程操作

切片软件就是把.stl格式的模型文件转换成可以打印的.gocde格式 的软件
.stl是三维模型，可以自己用三维建模软件设计，也可以在网上下， 需要是封闭的多边形。.goced是切片软件吧stl文件转换后的代码 文件，文件就是一堆G代码，且可以自己编辑更改。（不用太清 楚了解）
反正就是你设计的模型需要导出.stl，下载的模型需要是.stl。导 入机器的，机器能执行的文件为.goced。

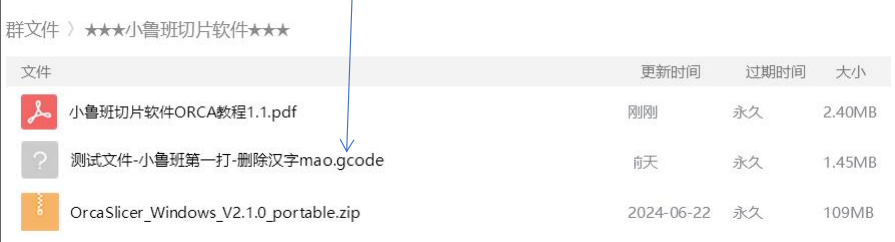
[picture p206: figure]

## 小鲁班只能认识英文和数字 替补切片软件CURA（需要手动配置）

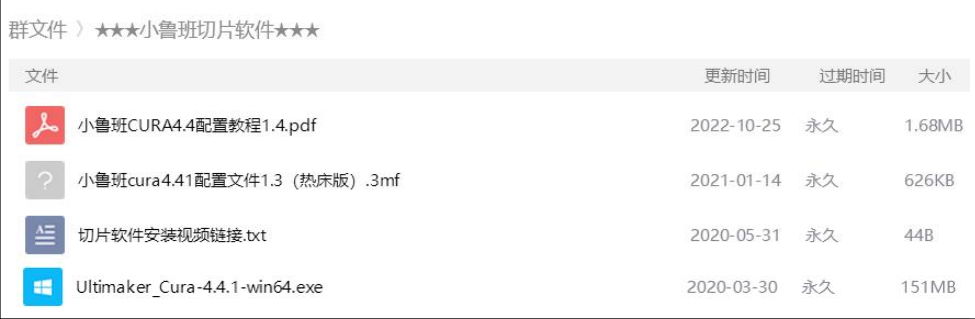
[picture p207: figure]

## （仅CURA支持）

## 先下载340驱动安装

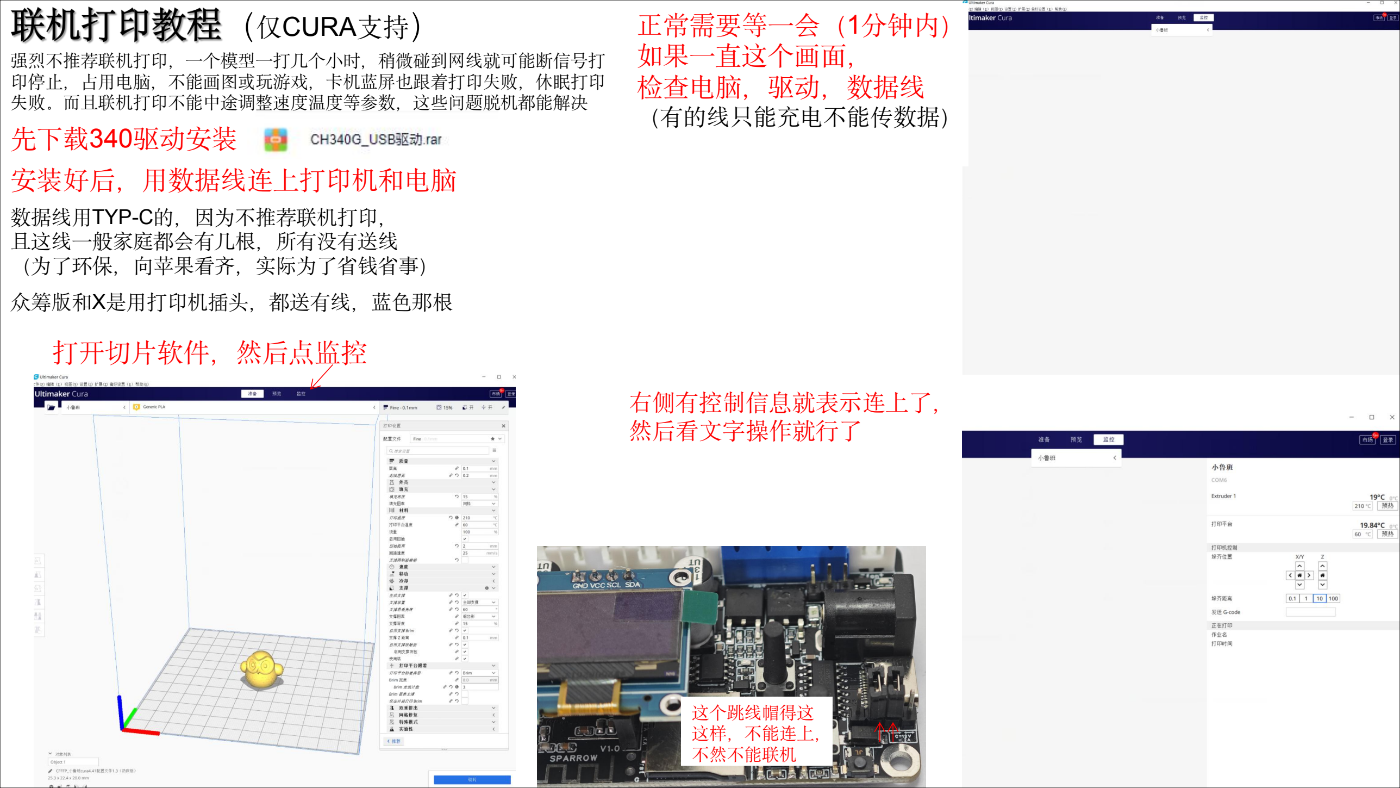
[picture p208: page 62]

## 安装好后，用数据线连上打印机和电脑

数据线用TYP-C的，因为不推荐联机打印，
且这线一般家庭都会有几根，所有没有送线
（为了环保，向苹果看齐，实际为了省钱省事）
众筹版和X是用打印机插头，都送有线，蓝色那根

## 打开切片软件，然后点监控

## 正常需要等一会（1分钟内） 如果一直这个画面， 检查电脑，驱动，数据线

（有的线只能充电不能传数据）

右侧有控制信息就表示连上了，
然后看文字操作就行了

强烈不推荐联机打印，一个模型一打几个小时，稍微碰到网线就可能断信号打 印停止，占用电脑，不能画图或玩游戏，卡机蓝屏也跟着打印失败，休眠打印 失败。而且联机打印不能中途调整速度温度等参数，这些问题脱机都能解决

这个跳线帽得这
这样，不能连上，
不然不能联机

## 用刀切入风扇罩背后盖的缝里，让盖能打开 拧上一颗短的M3螺丝

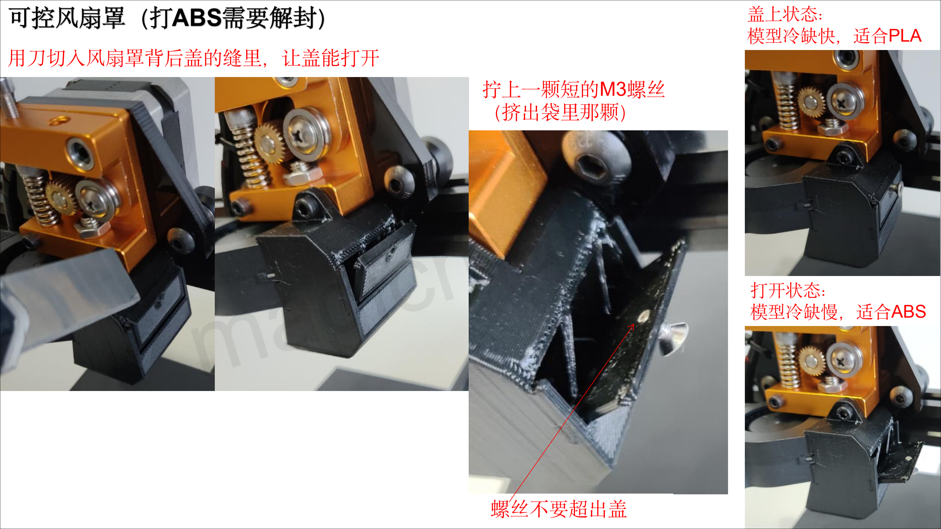
[picture p209: page 63]

## （挤出袋里那颗）

## 螺丝不要超出盖

## 盖上状态： 模型冷缺快，适合PLA

## 打开状态：

## 模型冷缺慢，适合ABS magicmaker

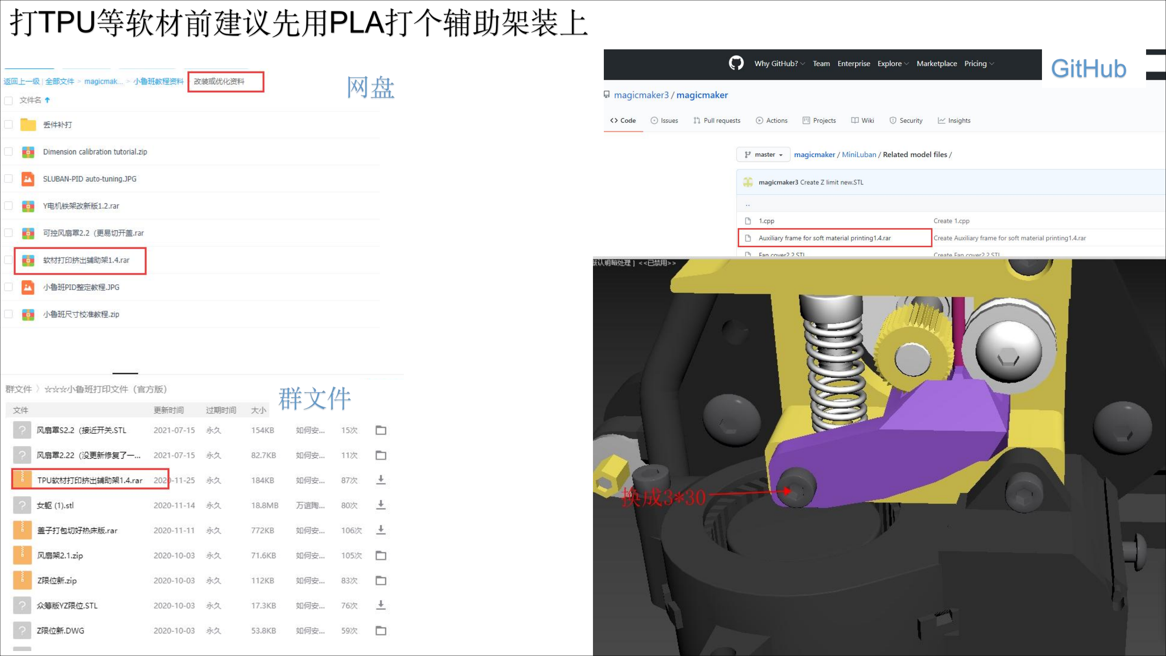
[picture p210: page 64]

网盘

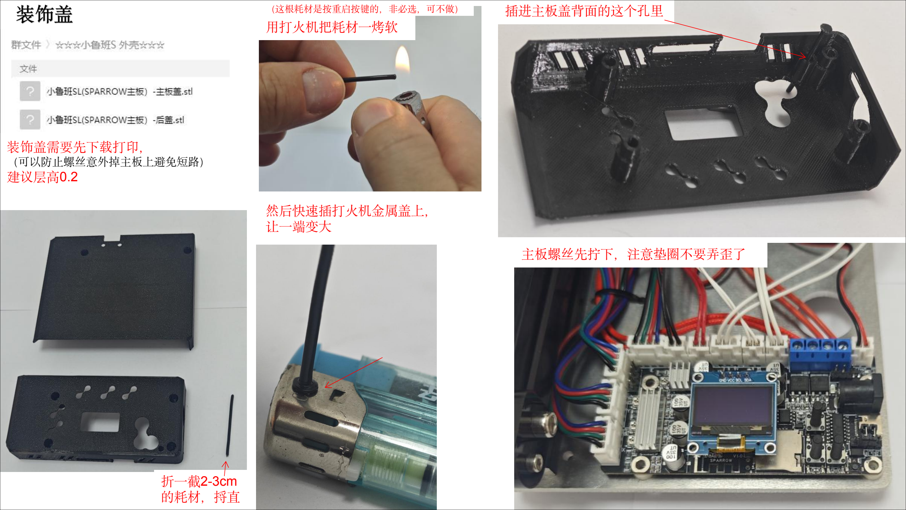
[picture p211: page 65]

用打火机把耗材一烤软

装饰盖需要先下载打印，
（可以防止螺丝意外掉主板上避免短路）
建议层高0.2

折一截2-3cm
的耗材，捋直
（这根耗材是按重启按键的，非必选，可不做） | 插进主板盖背面的这个孔里

主板螺丝先拧下，注意垫圈不要弄歪了

然后快速插打火机金属盖上，
让一端变大

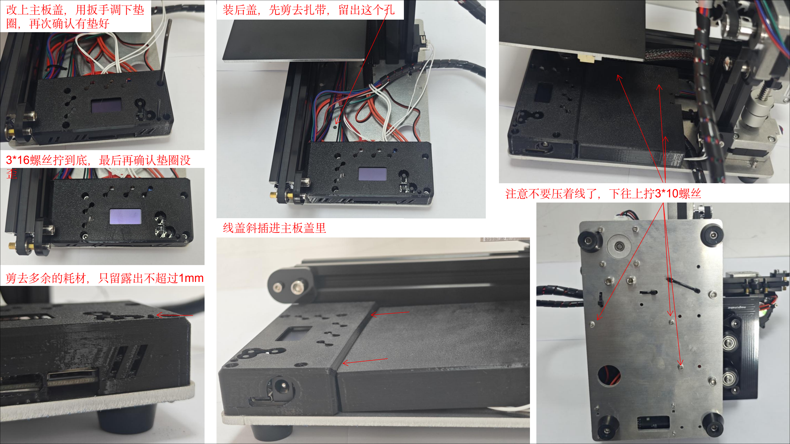
[picture p212: page 66]

改上主板盖，用扳手调下垫
圈，再次确认有垫好

3*16螺丝拧到底，最后再确认垫圈没
歪

剪去多余的耗材，只留露出不超过1mm

装后盖，先剪去扎带，留出这个孔

线盖斜插进主板盖里

注意不要压着线了，下往上拧3*10螺丝

背面这个位置
倒拧3*16螺丝

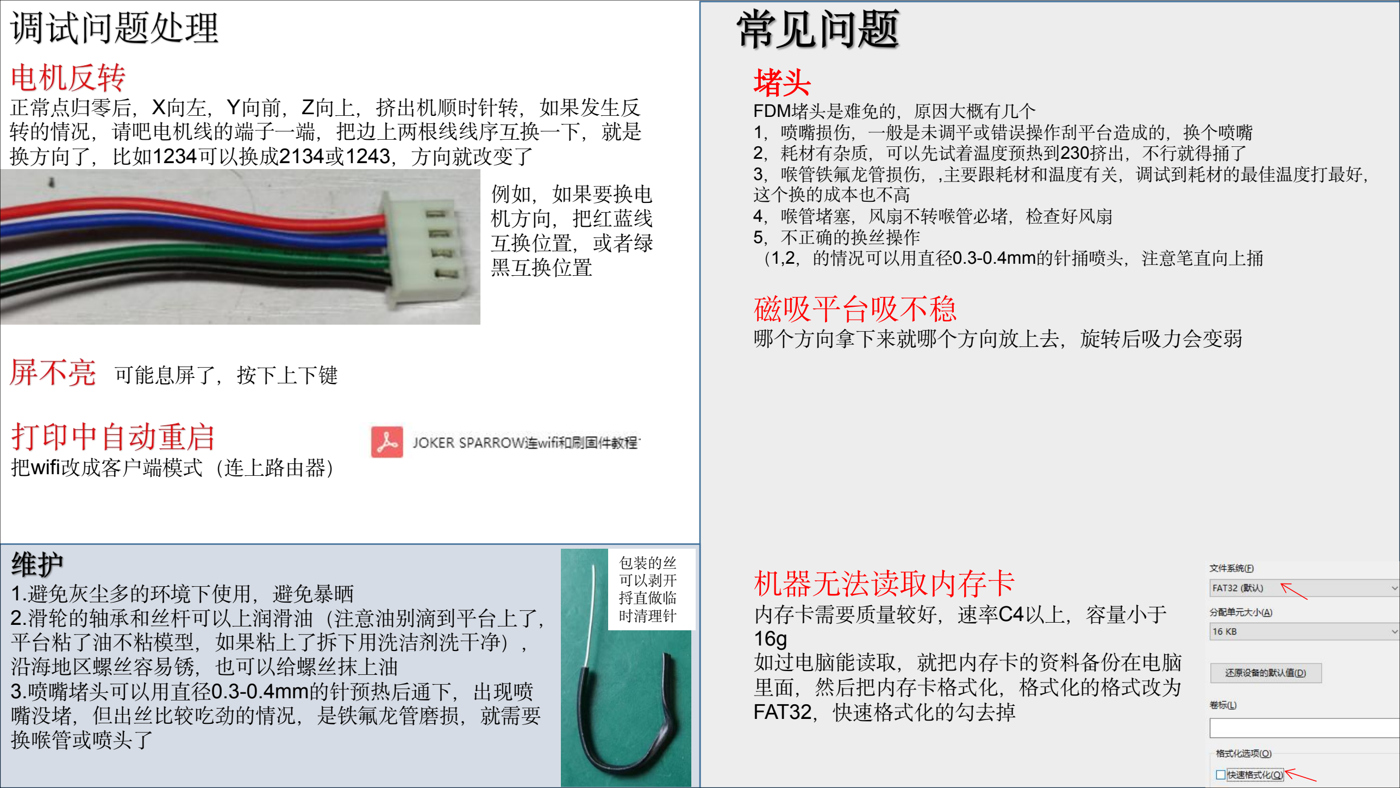
[picture p213: figure]
1.避免灰尘多的环境下使用，避免暴晒 2.滑轮的轴承和丝杆可以上润滑油（注意油别滴到平台上了， 平台粘了油不粘模型，如果粘上了拆下用洗洁剂洗干净）， 沿海地区螺丝容易锈，也可以给螺丝抹上油 3.喷嘴堵头可以用直径0.3-0.4mm的针预热后通下，出现喷 嘴没堵，但出丝比较吃劲的情况，是铁氟龙管磨损，就需要 换喉管或喷头了; FDM堵头是难免的，原因大概有几个 1，喷嘴损伤，一般是未调平或错误操作刮平台造成的，换个喷嘴 2，耗材有杂质，可以先试着温度预热到230挤出，不行就得捅了 3，喉管铁氟龙管损伤，,主要跟耗材和温度有关，调试到耗材的最佳温度打最好， 这个换的成本也不高 4，喉管堵塞，风扇不转喉管必堵，检查好风扇 5，不正确的换丝操作 （1,2，的情况可以用直径0.3-0.4mm的针捅喷头，注意笔直向上捅 磁吸平台吸不稳 哪个方向拿下来就哪个方向放上去，旋转后吸力会变弱; 机器无法读取内存卡 内存卡需要质量较好，速率C4以上，容量小于 16g 如过电脑能读取，就把内存卡的资料备份在电脑 里面，然后把内存卡格式化，格式化的格式改为 FAT32，快速格式化的勾去掉; 正常点归零后，X向左，Y向前，Z向上，挤出机顺时针转，如果发生反 转的情况，请吧电机线的端子一端，把边上两根线线序互换一下，就是 换方向了，比如1234可以换成2134或1243，方向就改变了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
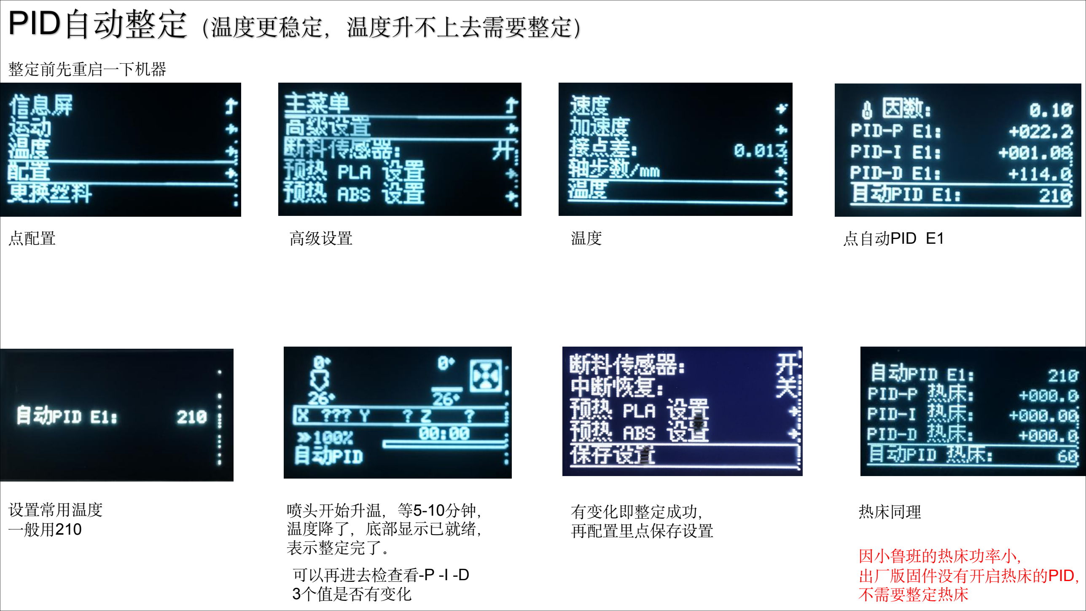
[picture p214: page 68]

点配置 | 高级设置

喷头开始升温，等5-10分钟，
温度降了，底部显示已就绪，
表示整定完了。
可以再进去检查看-P -I -D
3个值是否有变化
设置常用温度 | 热床同理
一般用210

温度

有变化即整定成功，
再配置里点保存设置
因小鲁班的热床功率小，
出厂版固件没有开启热床的PID，
不需要整定热床

点自动PID E1

整定前先重启一下机器

# 挤出不出丝少丝等问题解析

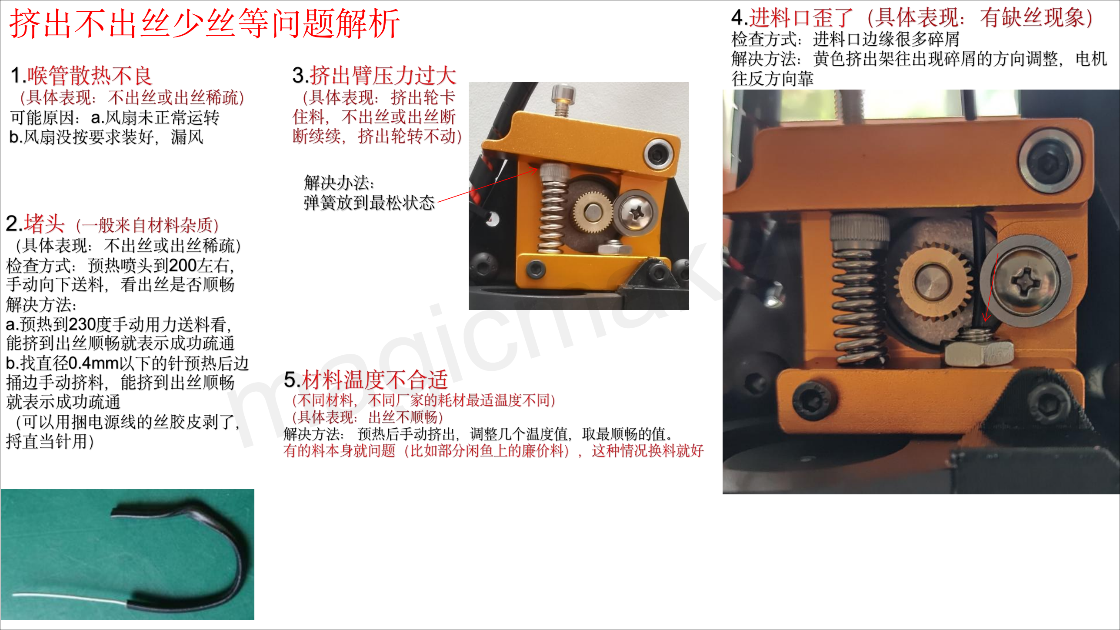
[picture p215: page 69]

# magicmaker

## 百度网盘链接:

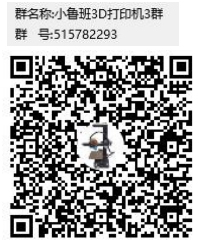
[picture p216: figure]

## pan.baidu.com/s/1aTfgacmzn0Qr1cNqkTUBUg?pwd=mukb 提取码: mukb

## 技术问题请在QQ群咨询， 群文件有很多官方和群友提供的资料，

（喜欢潜水又想蹲资料可以把群昵称加个小鲁班或SLB的前缀， 以防清人的时候误踢，若误踢了也可以再加进来）

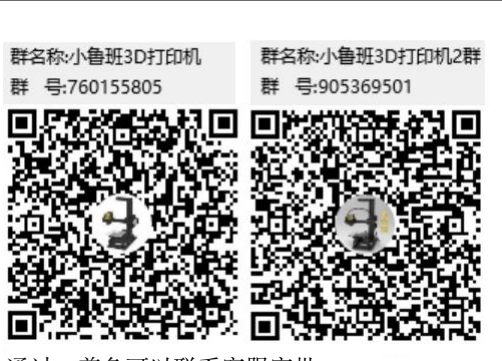
[picture p217: figure]

## 加群了管理在线就都会通过，着急可以联系客服审批， 坑位有限，只能加一个群

官网：

## www.3dmohe.com

## 海外用户：

## github.com/magicmaker3/magicmaker
