magicmaker3/magicmaker/(commit log)

2020-11-21 Create SLUBAN Assembly tutorial2.31.pdf
2020-11-25 Create Auxiliary frame for soft material printing1.4.rar
2021-01-03 Create Miniluban cura4.41 configuration file1.2.3mf
    [Miniluban cura4.41 configuration file1.2.3mf]
2021-01-12 Create SLUBAN Assembly tutorial2.46.pdf
2021-01-12 Create Video link 视频链接1.3.txt
2021-01-14 Create Miniluban cura4.41 configuration file1.3.3mf
    [Miniluban cura4.41 configuration file1.3.3mf]
2021-03-08 Create SLUBAN Assembly tutorial2.47.pdf
2021-06-03 Create Fan cover2.2.STL
    [Fan cover2.2.STL]
2021-06-03 Create Fan rack2.1.STL
    [Fan rack2.1.STL]
2021-06-03 Create Material carrier arm.STL
    [Material carrier arm.STL]
2021-06-03 Create Material rack seat.STL
    [Material rack seat.STL]
2021-06-03 Create YZ limit.STL
    [YZ limit.STL]
2021-06-03 Create Z limit new.STL
    [Z limit new.STL]
2021-07-21 Create Dimension calibration tutorial.zip
2021-07-21 Create SLUBAN-PID auto-tuning.JPG
2021-08-01 Create SLUBAN Assembly tutorial2.53.pdf
2021-12-06 Create SLUBAN Assembly tutorial2.6.pdf
2022-11-03 Create CH340G_USB drive驱动.zip
2022-11-03 Create Main board cover2.2.STL
    [Main board cover2.2.STL]
2022-11-03 Create Wire cover1.4.STL
    [Wire cover1.4.STL]
2022-11-03 Create Screen cover2.1.STL
    [Screen cover2.1.STL]
2022-11-22 Create Fan cover2.3风扇罩.stl
    [Fan cover2.3风扇罩.stl]
2022-11-22 Create Fan rack2.1风扇架.STL
    [Fan rack2.1风扇架.STL]
2022-11-22 Create Material carrier arm1.2料架臂.stl
    [Material carrier arm1.2料架臂.stl]
2022-11-22 Create Material rack seat1.2料架座.stl
    [Material rack seat1.2料架座.stl]
2022-11-22 Create Z limitZ限位.STL
    [Z limitZ限位.STL]
2022-11-22 Create Soft material auxiliary1.4软材辅助架.rar
2022-11-22 Create Air duct3.2风道.stl
    [Air duct3.2风道.stl]
2022-11-22 Create Main board cover3.4主板盖.stl
    [Main board cover3.4主板盖.stl]
2022-11-22 Create Screen cover3.1屏盖.stl
    [Screen cover3.1屏盖.stl]
2022-11-22 Create Side cover3.1边盖.stl
    [Side cover3.1边盖.stl]
2022-11-22 Create Switch rack1.1开关架.stl
    [Switch rack1.1开关架.stl]
2022-11-22 Create Wire clamp1.2导线卡.stl
    [Wire clamp1.2导线卡.stl]
2022-11-22 Create Wire cover3.4线盖.stl
    [Wire cover3.4线盖.stl]
2023-01-11 Create Main board cover3.5主板盖.stl
    [Main board cover3.5主板盖.stl]
2023-03-16 Create Fan rack风扇架2.2.stl
    [Fan rack风扇架2.2.stl]
2023-03-16 Create Main board cover4.13主板盖（new）.stl
    [Main board cover4.13主板盖（new）.stl]
2023-03-16 Create Screen cover4.13屏盖（new）.stl
    [Screen cover4.13屏盖（new）.stl]
2023-03-16 Create Side cover3.62边盖.stl
    [Side cover3.62边盖.stl]
2023-03-16 Create Wire cover3.42线盖.stl
    [Wire cover3.42线盖.stl]
2023-06-21 Create Fan cover风扇罩2.6.stl
    [Fan cover风扇罩2.6.stl]
2024-01-23 Create Installation tutorial小鲁班S教程3.68.pdf
2024-01-23 Create Video link 视频链接1.4.txt
2024-06-08 Create Installation tutorial小鲁班S教程3.69.pdf
2024-06-08 Create Installation tutorial小鲁班S教程3.72.pdf
2024-06-29 Create Installation tutorial小鲁班S教程3.73.pdf
2024-06-29 Create SLUBAN User manual 小鲁班使用手册2.11.pdf
2024-08-10 Create Installation tutorial小鲁班S教程3.75（最新）.pdf
2024-08-10 Create Installation tutorial小鲁班S教程3.69（黑螺丝）.pdf
2024-08-10 Create SLUBAN User manual使用手册2.2.pdf
2024-08-17 Create Dimension calibration tutorial尺寸校准教程.zip
2024-09-21 Create Installation tutorial小鲁班S教程3.76（最新）.pdf
2024-10-09 Create Installation tutorial小鲁班S教程3.77（最新）.pdf
2025-01-07 Create firmware(COREXY 125口.bin
2025-01-07 Create firmware(COREXY 160口.bin
2025-01-07 Create firmware(COREXY 180口.bin
2025-01-07 Create firmware(COREXY 220口.bin
2025-01-07 Create firmware(COREXY 320口.bin
2025-01-07 Create firmware(XYZ 125口.bin
2025-01-07 Create firmware(XYZ 160口.bin
2025-01-07 Create firmware(XYZ 180口.bin
2025-01-07 Create firmware(XYZ 220口.bin
2025-01-07 Create firmware(XYZ 320口.bin
2025-01-07 Create firmware(XYZ 420口.bin
2025-01-07 Create firmware(XYZ 520口.bin
2025-01-07 Create 全功能固件-firmware（SLB 125口 2208-出厂版.bin
2025-01-07 Create 全功能固件-firmware（SLB 125口 4988-出厂版.bin
2025-01-07 Create 全功能固件-firmware（小鲁班 125口 2208-出厂版.bin
2025-01-07 Create 全功能固件-firmware（小鲁班 125口 2208-改24V.bin
2025-01-07 Create 全功能固件-firmware（小鲁班 125口 4988-出厂版.bin
2025-01-07 Create 全功能固件-firmware（小鲁班 125口 4988-改24V.bin
2025-01-07 Create 全功能固件-firmware（小鲁班 150口 2208.bin
2025-01-07 Create 全功能固件-firmware（小鲁班 150口 4988.bin
2025-01-07 Create 全功能固件-firmware（小鲁班 220口 2208.bin
2025-01-07 Create 全功能固件-firmware（小鲁班 220口 4988.bin
2025-01-07 Create 带 SLB 的是英文界面.txt
2025-01-07 Create Material rack seat1.3料架座.stl
    [Material rack seat1.3料架座.stl]
2025-01-13 Create Installation tutorial小鲁班S教程3.81（最新）.pdf
2025-01-13 Create Fan cover风扇罩S2.7（可装硅胶套.stl
    [Fan cover风扇罩S2.7（可装硅胶套.stl]
2025-01-13 Create SLUBAN User manual使用手册2.3.pdf
2025-01-15 Create Fan cover风扇罩S2.8（可装硅胶套.stl
    [Fan cover风扇罩S2.8（可装硅胶套.stl]
2025-02-13 Create Miniluban cura4.41 configuration file1.4.3mf
    [Miniluban cura4.41 configuration file1.4.3mf]
2025-03-11 Create Installation tutorial小鲁班S教程3.82（最新）.pdf
2025-09-22 Create firmware（小鲁班U无限Z 2208）.bin
2025-09-22 Create firmware（小鲁班U无限Z 4988）.bin
2026-03-28 Create Installation tutorial小鲁班S教程3.84.pdf
2026-03-28 Create firmware（220口 风扇温控.bin
2026-03-28 Create firmware（220口 风扇自控.bin
2026-03-28 Create Marlin-2.0.8.1（sparrow 常规固件220.zip
2026-03-28 Create firmware（小鲁班120 自动调平.bin
2026-03-28 Create Marlin-2.0.8.1（sparrow 小鲁班固件.zip
2026-05-23 Create Side cover边盖U.stl
    [Side cover边盖U.stl]
2026-07-27 Create Installation tutorial小鲁班SL教程4.02.pdf
2026-07-27 Create JOKER SPARROW连wifi和刷固件教程1.91.pdf
2026-07-27 Create SL-Main board cover主板盖.stl
    [SL-Main board cover主板盖.stl]
2026-07-27 Create SL-Wire cover线盖.stl
    [SL-Wire cover线盖.stl]
2026-09-19 Create Installation tutorial小鲁班SL教程4.03.pdf
2026-09-19 Create Installation tutorial小鲁班SP教程4.03.pdf
2026-09-19 Create SL-Back cover后盖.stl
    [SL-Back cover后盖.stl]
2026-09-19 Create SP-Back cover后盖.STL
    [SP-Back cover后盖.STL]
2026-09-19 Create SP-front bumper前杠.STL
    [SP-front bumper前杠.STL]
2026-09-19 Create SP-Main board cover主板盖.stl
    [SP-Main board cover主板盖.stl]
2026-09-19 Create SP-Screen cover屏盖.STL
    [SP-Screen cover屏盖.STL]
2026-09-19 Create SP-Side cover边盖.STL
    [SP-Side cover边盖.STL]
2026-09-19 Create SP-Wind guidance风导.STL
    [SP-Wind guidance风导.STL]
2026-09-19 Create SP-Wire cover线盖.STL
    [SP-Wire cover线盖.STL]
